Jinzuu/wc_ws/doc/Signalfluss DigIn Out.png

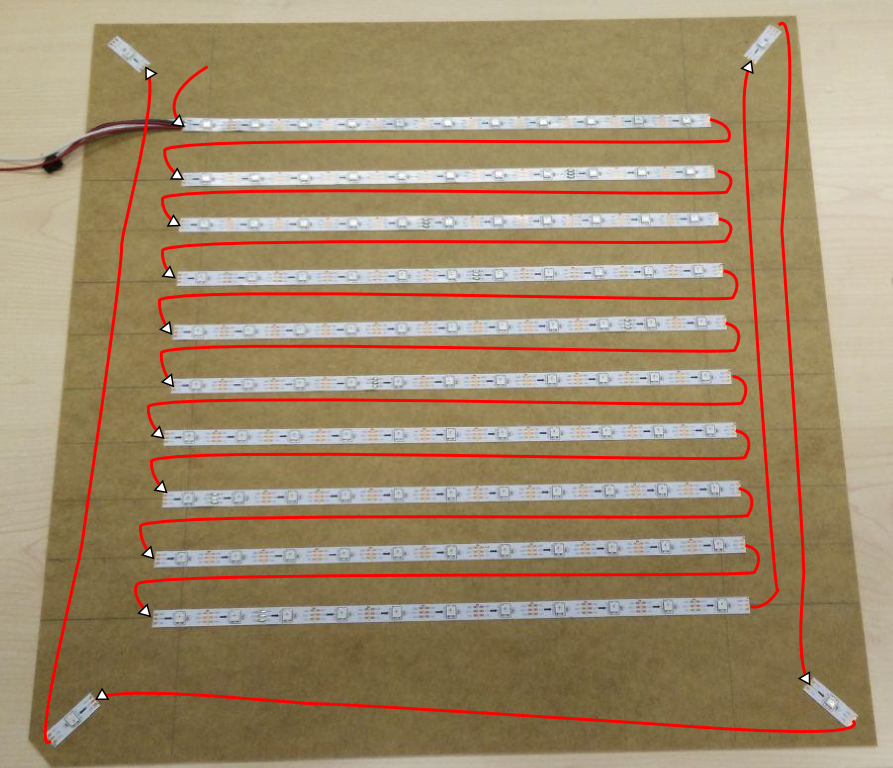
doc/Signalfluss DigIn Out.png
