Jinzuu/wc_ws/README.md

wc_ws
=====

Wordclock on STM32 with WS LEDs
