Jinzuu/wc_ws/doc/Frontplatte V02 mit Bemaßung.png

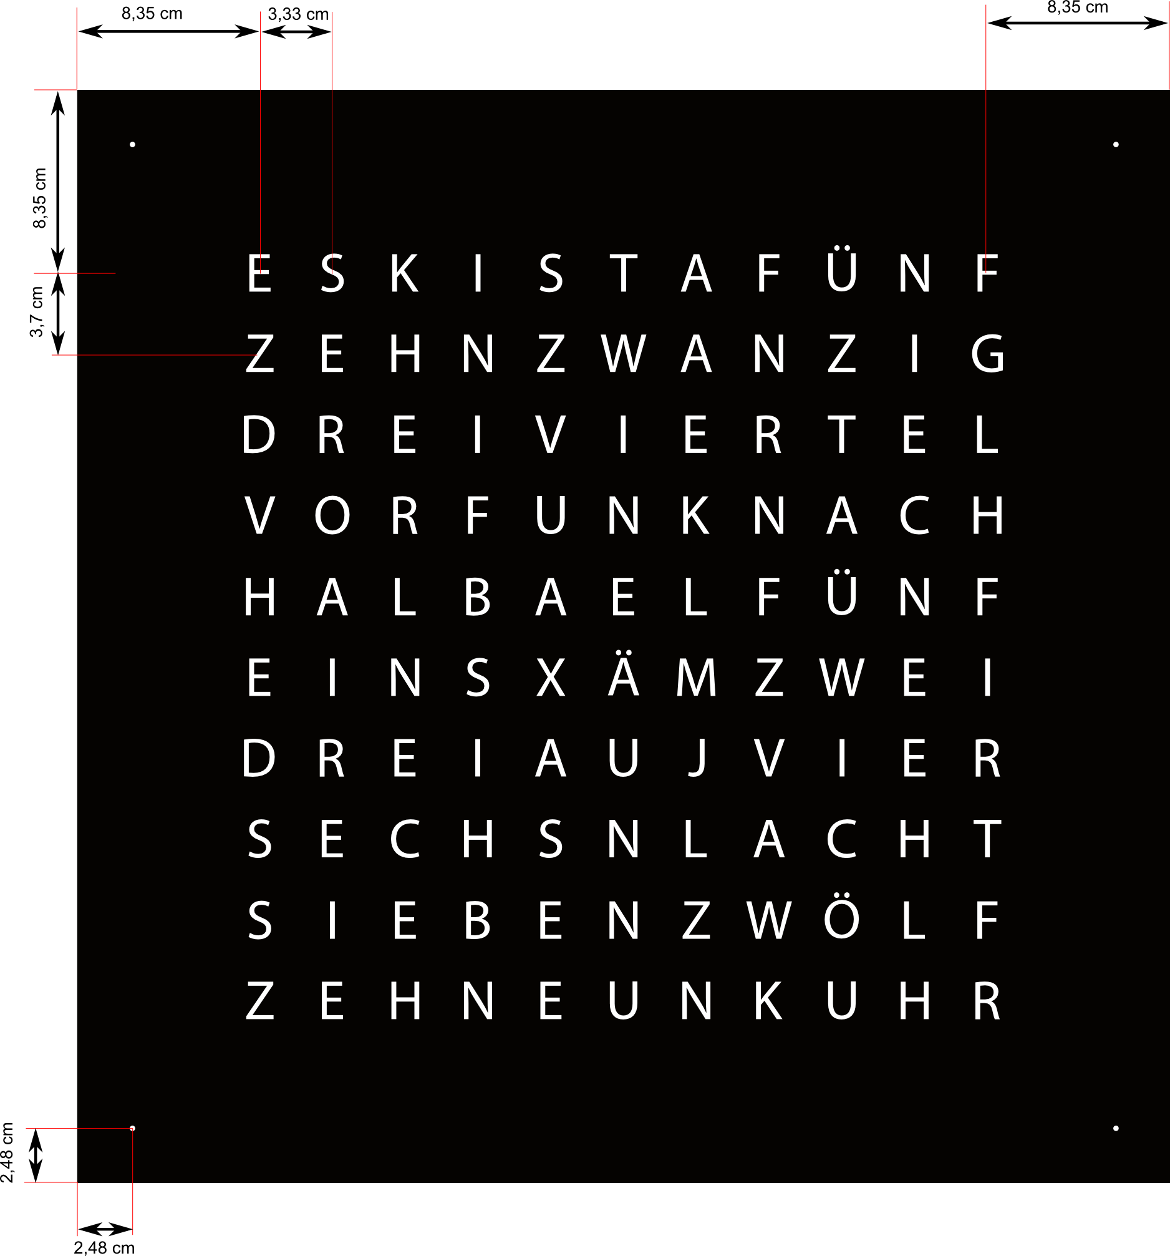
doc/Frontplatte V02 mit Bemaßung.png
