Jinzuu/wc_ws/(list of files, cad)

Other CAD files:
Inventor/Horizontal_Einschub.ipt
