Jinzuu/wc_ws/Platine/Zusatzplatine.brd

## EAGLE design Platine/Zusatzplatine.brd (2015-11-07)

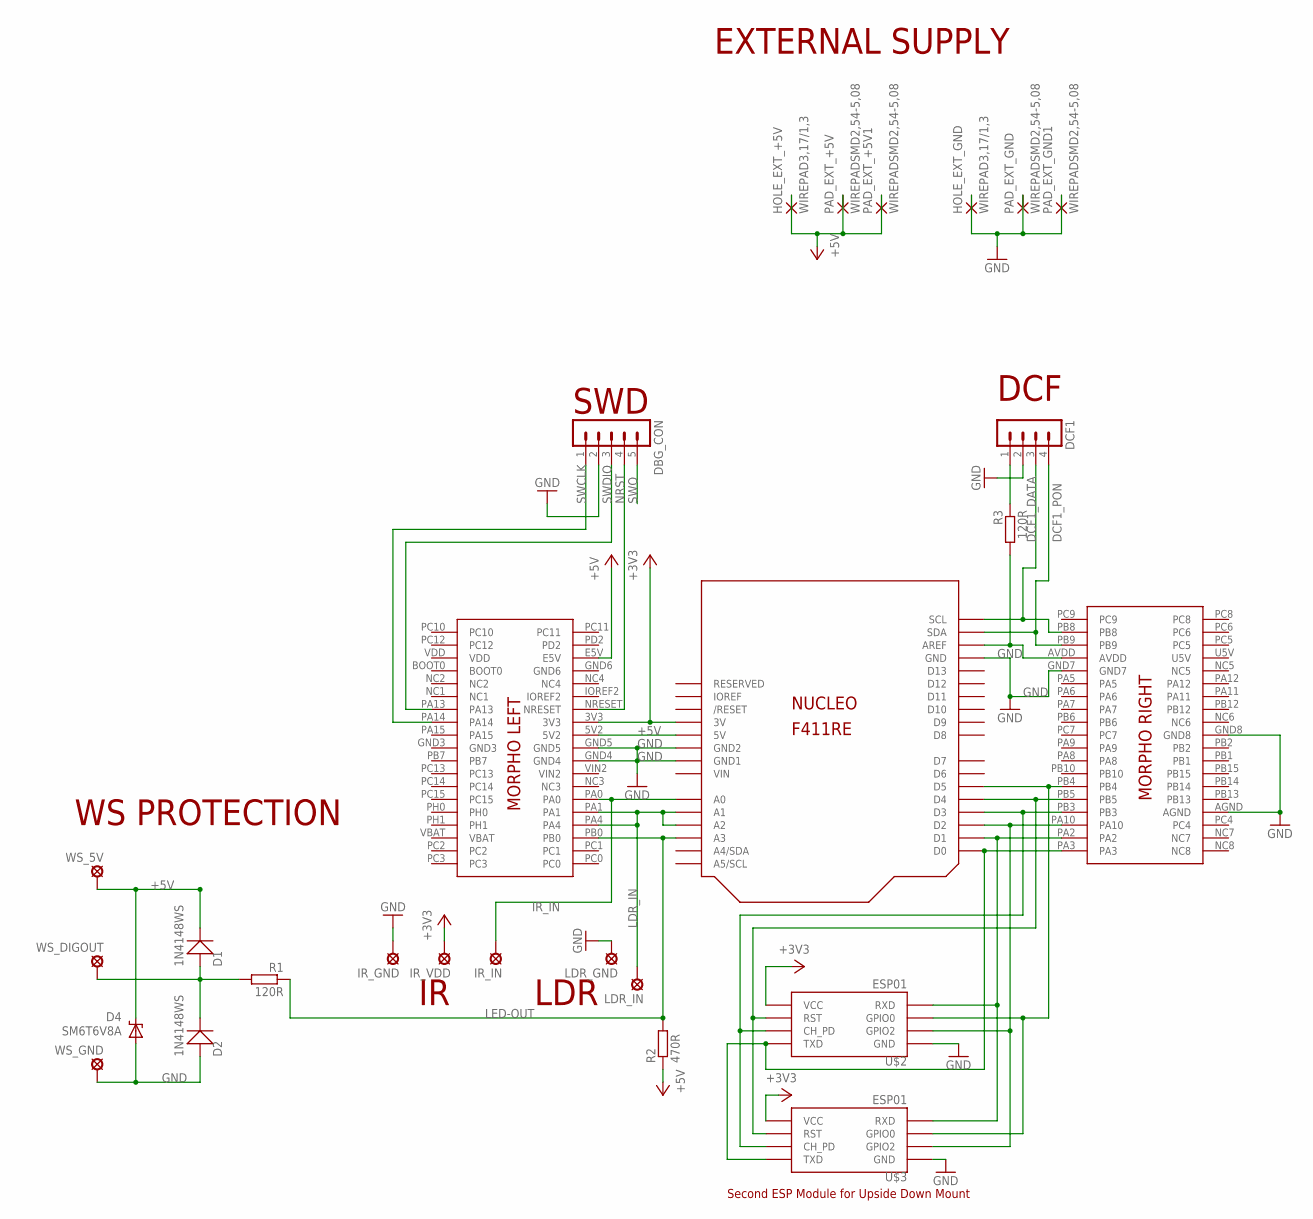
[picture p7: schematic Zusatzplatine.sch]

Parts:
D1, D2: 1N4148WS; SOD-323
D4: SM6T6V8A; SMBJ
DBG_CON: MA05-1
DCF1: MA04-1
HOLE_EXT_+5V: WIREPAD3,17/1,3; 3,17/1,3
HOLE_EXT_GND: WIREPAD3,17/1,3; 3,17/1,3
IR_GND: SE14
IR_IN: SE14
IR_VDD: SE14
LDR_GND: SE14
LDR_IN: SE14
PAD_EXT_+5V, PAD_EXT_+5V1: WIREPADSMD2,54-5,08; SMD2,54-5,08
PAD_EXT_GND, PAD_EXT_GND1: WIREPADSMD2,54-5,08; SMD2,54-5,08
R1, R3: 120R; R1206
R2: 470R; R1206
U$1: NUCLEO_F411RE; NUCLEO_BRD64
U$2, U$3: ESP01
WS_5V: SE14
WS_DIGOUT: SE14
WS_GND: SE14

Connections:
+3V3: IR_VDD.MP, U$1.3V, U$1.3V3, U$2.VCC, U$3.VCC
+5V: D1.1, D4.C, HOLE_EXT_+5V.1, PAD_EXT_+5V.1, PAD_EXT_+5V1.1, R2.1, U$1.5V, U$1.5V2, U$1.E5V, WS_5V.MP
DCF1_DATA: DCF1.3, U$1.PB8, U$1.SCL
DCF1_PON: DCF1.4, U$1.PB9, U$1.SDA
GND: D2.0, D4.A, DBG_CON.2, DCF1.2, HOLE_EXT_GND.1, IR_GND.MP, LDR_GND.MP, PAD_EXT_GND.1, PAD_EXT_GND1.1, U$1.AGND, U$1.GND, U$1.GND1, U$1.GND2, U$1.GND4, U$1.GND5, U$1.GND7, U$1.GND8, U$2.GND, U$3.GND, WS_GND.MP
GND3: U$1.GND3
GND6: U$1.GND6
IR_IN: IR_IN.MP, U$1.A0, U$1.PA0
LDR_IN: LDR_IN.MP, U$1.A1, U$1.A2, U$1.PA1, U$1.PA4
LED-OUT: R1.1, R2.2, U$1.A3, U$1.PB0
unnamed: R3.2, U$1.AREF, U$1.AVDD
unnamed: DCF1.1, R3.1
unnamed: D1.0, D2.1, R1.2, WS_DIGOUT.MP
unnamed: U$1.D5, U$1.PB4, U$2.GPIO0, U$3.GPIO0
unnamed: U$1.D4, U$1.PB5, U$2.RST, U$3.RST
unnamed: U$1.D3, U$1.PB3, U$2.CH_PD, U$3.CH_PD
unnamed: U$1.D0, U$1.PA3, U$2.TX (TXD), U$3.TX (TXD)
unnamed: U$1.D1, U$1.PA2, U$2.RX (RXD), U$3.RX (RXD)
unnamed: U$1.D2, U$1.PA10, U$2.GPIO2, U$3.GPIO2
NRST: DBG_CON.4, U$1.NRESET
SWCLK: DBG_CON.1, U$1.PA14
SWDIO: DBG_CON.3, U$1.PA13
SWO: DBG_CON.5
U5V: U$1.U5V
VBAT: U$1.VBAT
VDD: U$1.VDD
VIN: U$1.VIN
VIN2: U$1.VIN2

Notes on the sheet:
DCF
EXTERNAL SUPPLY
WS PROTECTION
LDR
SWD
Second ESP Module for Upside Down Mount

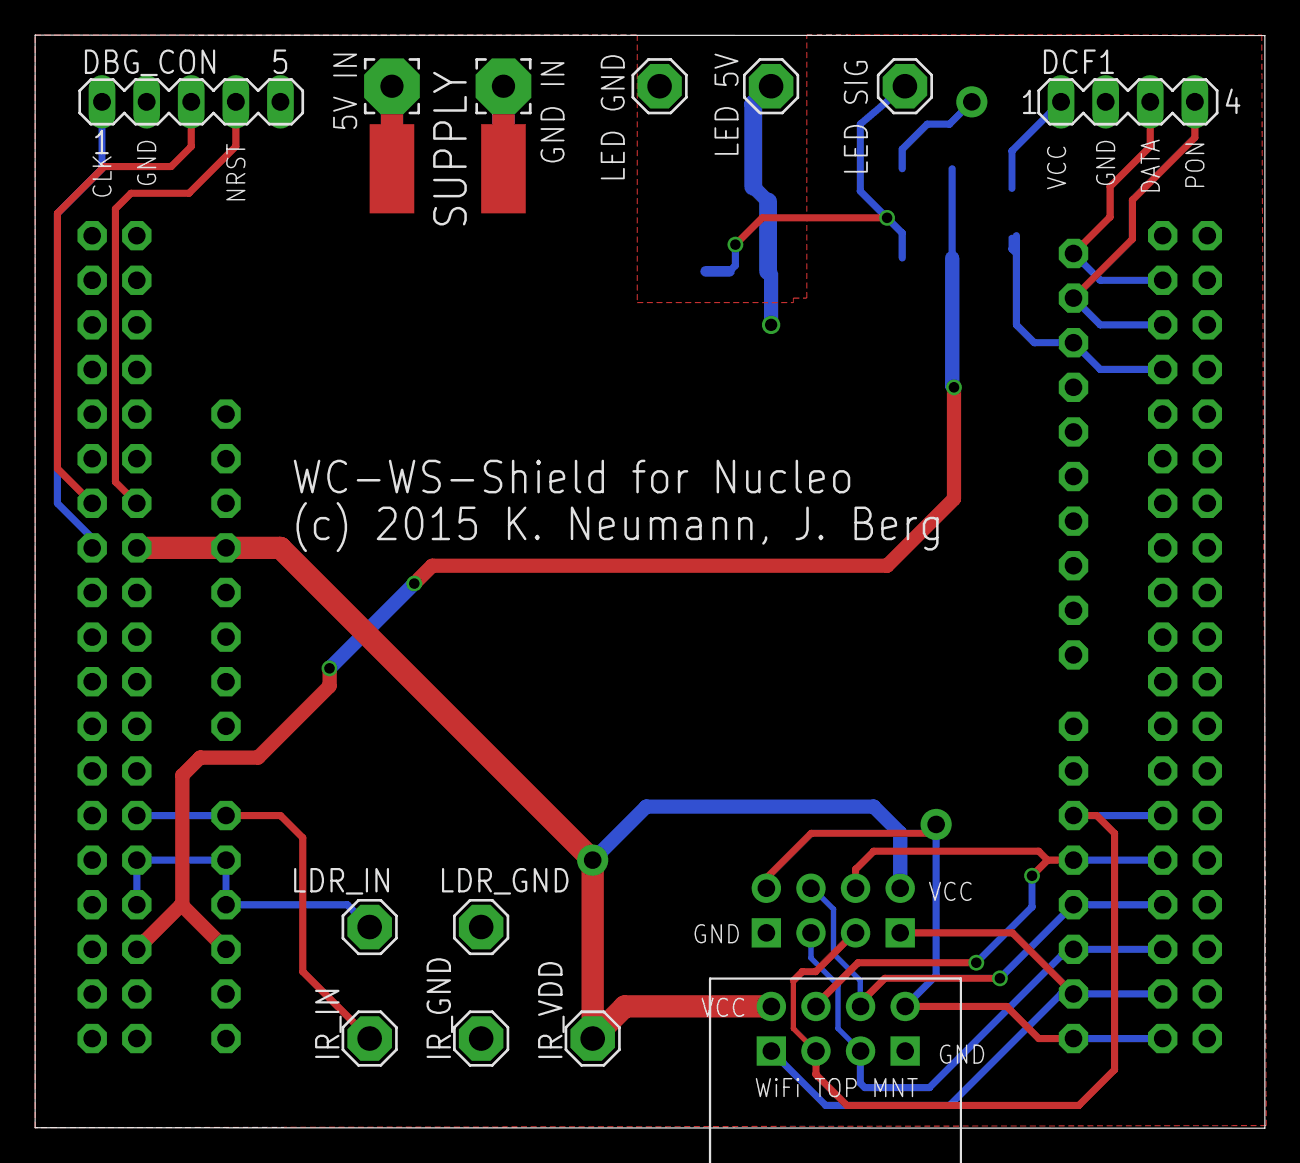
[picture p8: board Zusatzplatine.brd from above]

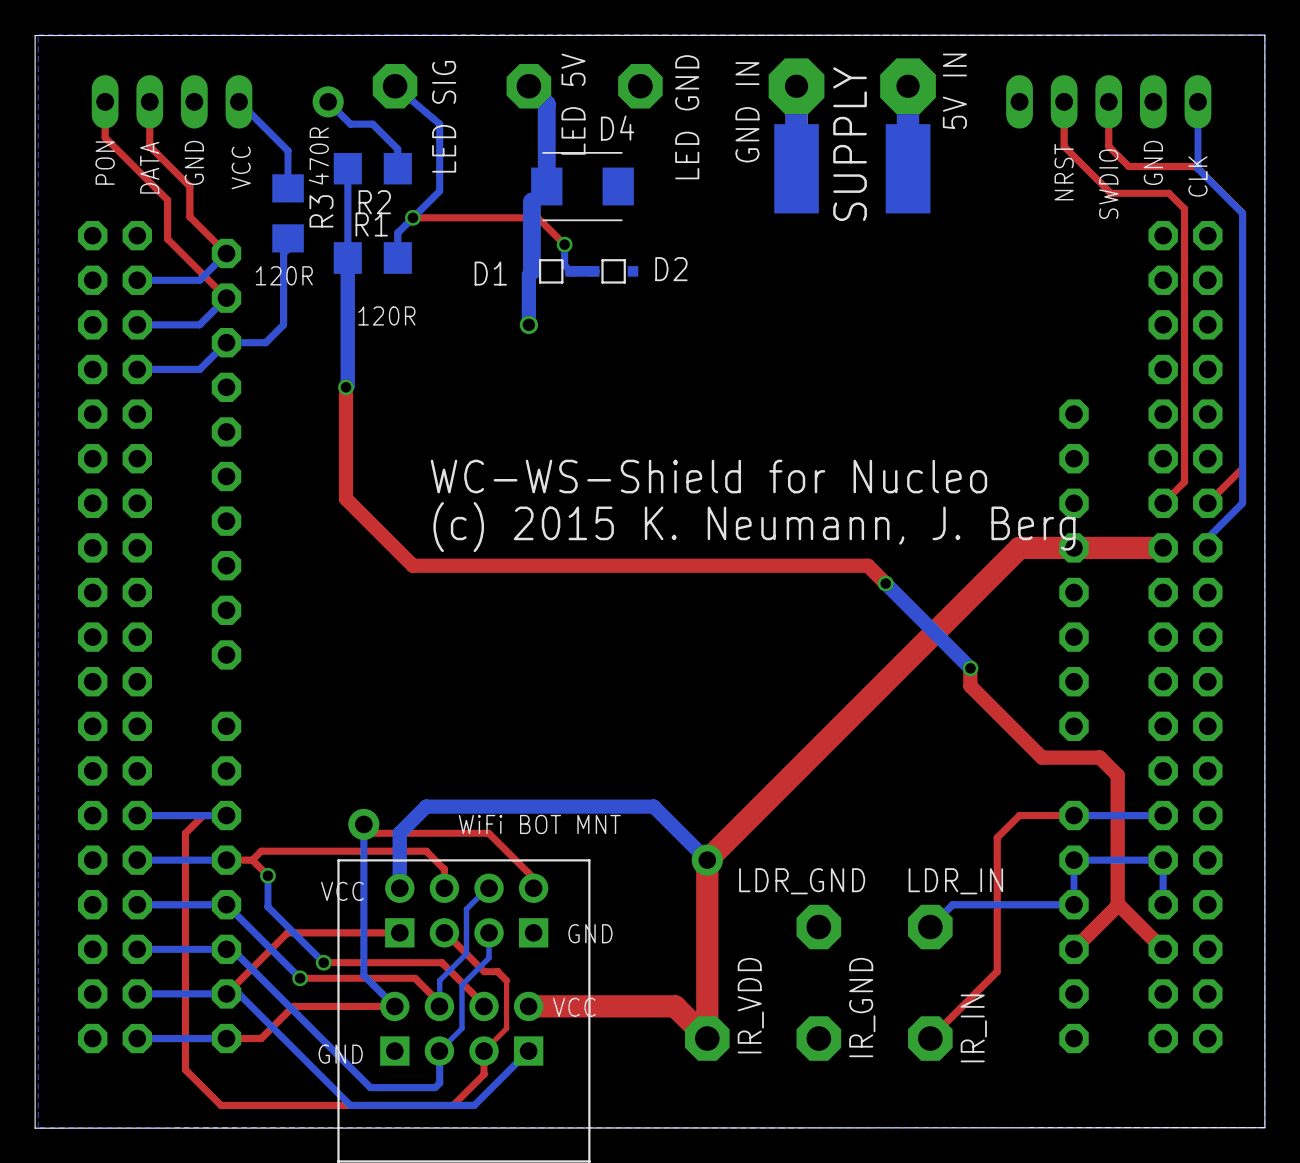
[picture p9: board Zusatzplatine.brd from below]

Board: 2 copper layers, 70.0 x 62.2 mm, 25 parts (9 on the bottom side), 20 nets.
