Jinzuu/wc_ws/Platine/Schutz.brd

## EAGLE design Platine/Schutz.brd (2015-05-21)

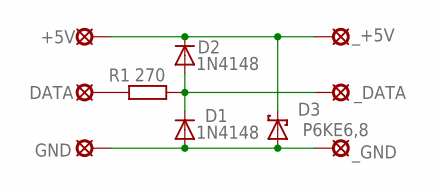
[picture p10: schematic Schutz.sch]

Parts:
+5V: LSP11
D1, D2: 1N4148; DO35-7
D3: P6KE6,8; CB417-15
DATA: LSP11
GND: LSP11
R1: 270; 0207/7
_+5V: LSP11
_DATA: LSP11
_GND: LSP11

Connections:
unnamed: D1.C, D2.A, R1.2, _DATA.MP
unnamed: D1.A, D3.A, GND.MP, _GND.MP
unnamed: +5V.MP, D2.C, D3.C, _+5V.MP
unnamed: DATA.MP, R1.1

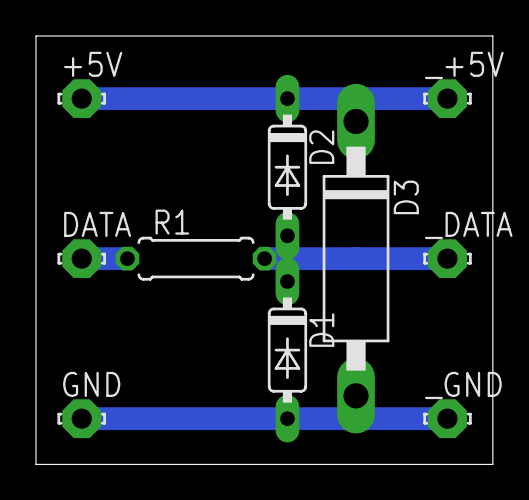
[picture p11: board Schutz.brd from above]

Board: 2 copper layers, 25.4 x 23.8 mm, 10 parts (0 on the bottom side), 4 nets.
