Jinzuu/wc_ws/IRMP/irmp.c

/*---------------------------------------------------------------------------------------------------------------------------------------------------
 * irmp.c - infrared multi-protocol decoder, supports several remote control protocols
 *
 * Copyright (c) 2009-2010 Frank Meyer - frank(at)fli4l.de
 *
 * $Id: irmp.c,v 1.87 2011/01/18 13:02:15 fm Exp $
 *
 * ATMEGA88 @ 8 MHz
 *
 * Typical manufacturers:
 *
 * SIRCS      - Sony
 * NEC        - NEC, Yamaha, Canon, Tevion, Harman/Kardon, Hitachi, JVC, Pioneer, Toshiba, Xoro, Orion, and many other Japanese manufacturers
 * SAMSUNG    - Samsung
 * SAMSUNG32  - Samsung
 * MATSUSHITA - Matsushita
 * KASEIKYO   - Panasonic, Denon & other Japanese manufacturers (members of "Japan's Association for Electric Home Application")
 * RECS80     - Philips, Nokia, Thomson, Nordmende, Telefunken, Saba
 * RC5        - Philips and other European manufacturers
 * DENON      - Denon, Sharp
 * RC6        - Philips and other European manufacturers
 * APPLE      - Apple
 * NUBERT     - Nubert Subwoofer System
 * B&O        - Bang & Olufsen
 * PANASONIC  - Panasonic (older, yet not implemented)
 * GRUNDIG    - Grundig
 * NOKIA      - Nokia
 * SIEMENS    - Siemens, e.g. Gigaset M740AV
 *
 *---------------------------------------------------------------------------------------------------------------------------------------------------
 *
 *   SIRCS
 *   -----
 *
 *   frame: 1 start bit + 12-20 data bits + no stop bit
 *   data:  7 command bits + 5 address bits + 0 to 8 additional bits
 *
 *   start bit:                           data "0":                 data "1":                 stop bit:
 *   -----------------_________           ------_____               ------------______
 *       2400us         600us             600us 600us               1200us      600 us        no stop bit
 *
 *---------------------------------------------------------------------------------------------------------------------------------------------------
 *
 *   NEC + extended NEC
 *   -------------------------
 *
 *   frame: 1 start bit + 32 data bits + 1 stop bit
 *   data NEC:          8 address bits + 8 inverted address bits + 8 command bits + 8 inverted command bits
 *   data extended NEC: 16 address bits + 8 command bits + 8 inverted command bits
 *
 *   start bit:                           data "0":                 data "1":                 stop bit:
 *   -----------------_________           ------______              ------________________    ------______....
 *       9000us        4500us             560us  560us              560us    1690 us          560us
 *
 *
 *   Repetition frame:
 *
 *   -----------------_________------______  .... ~100ms Pause, then repeat
 *       9000us        2250us   560us
 *
 *---------------------------------------------------------------------------------------------------------------------------------------------------
 *
 *   SAMSUNG
 *   -------
 *
 *   frame: 1 start bit + 16 data(1) bits + 1 sync bit + additional 20 data(2) bits + 1 stop bit
 *   data(1): 16 address bits
 *   data(2): 4 ID bits + 8 command bits + 8 inverted command bits
 *
 *   start bit:                           data "0":                 data "1":                 sync bit:               stop bit:
 *   ----------______________             ------______              ------________________    ------______________    ------______....
 *    4500us       4500us                 550us  450us              550us    1450us           550us    4500us         550us
 *
 *---------------------------------------------------------------------------------------------------------------------------------------------------
 *
 *   SAMSUNG32
 *   ----------
 *
 *   frame: 1 start bit + 32 data bits + 1 stop bit
 *   data: 16 address bits + 16 command bits
 *
 *   start bit:                           data "0":                 data "1":                 stop bit:
 *   ----------______________             ------______              ------________________    ------______....
 *    4500us       4500us                 550us  450us              550us    1450us           550us
 *
 *---------------------------------------------------------------------------------------------------------------------------------------------------
 *
 *   MATSUSHITA
 *   ----------
 *
 *   frame: 1 start bit + 24 data bits + 1 stop bit
 *   data:  6 custom bits + 6 command bits + 12 address bits
 *
 *   start bit:                           data "0":                 data "1":                 stop bit:
 *   ----------_________                  ------______              ------________________    ------______....
 *    3488us     3488us                   872us  872us              872us    2616us           872us
 *
 *---------------------------------------------------------------------------------------------------------------------------------------------------
 *
 *   KASEIKYO
 *   --------
 *
 *   frame: 1 start bit + 48 data bits + 1 stop bit
 *   data:  16 manufacturer bits + 4 parity bits + 4 genre1 bits + 4 genre2 bits + 10 command bits + 2 id bits + 8 parity bits
 *
 *   start bit:                           data "0":                 data "1":                 stop bit:
 *   ----------______                     ------______              ------________________    ------______....
 *    3380us   1690us                     423us  423us              423us    1269us           423us
 *
 *---------------------------------------------------------------------------------------------------------------------------------------------------
 *
 *   RECS80
 *   ------
 *
 *   frame: 2 start bits + 10 data bits + 1 stop bit
 *   data:  1 toggle bit + 3 address bits + 6 command bits
 *
 *   start bit:                           data "0":                 data "1":                 stop bit:
 *   -----_____________________           -----____________         -----______________       ------_______....
 *   158us       7432us                   158us   4902us            158us    7432us           158us
 *
 *---------------------------------------------------------------------------------------------------------------------------------------------------
 *
 *   RECS80EXT
 *   ---------
 *
 *   frame: 2 start bits + 11 data bits + 1 stop bit
 *   data:  1 toggle bit + 4 address bits + 6 command bits
 *
 *   start bit:                           data "0":                 data "1":                 stop bit:
 *   -----_____________________           -----____________         -----______________       ------_______....
 *   158us       3637us                   158us   4902us            158us    7432us           158us
 *
 *---------------------------------------------------------------------------------------------------------------------------------------------------
 *
 *   RC5 + RC5X
 *   ----------
 *
 *   RC5 frame:  2 start bits + 12 data bits + no stop bit
 *   RC5 data:   1 toggle bit + 5 address bits + 6 command bits
 *   RC5X frame: 1 start bit +  13 data bits + no stop bit
 *   RC5X data:  1 inverted command bit + 1 toggle bit + 5 address bits + 6 command bits
 *
 *   start bit:              data "0":                data "1":
 *   ______-----             ------______             ______------
 *   889us 889us             889us 889us              889us 889us
 *
 *---------------------------------------------------------------------------------------------------------------------------------------------------
 *
 *   DENON
 *   -----
 *
 *   frame: 0 start bits + 16 data bits + stop bit + 65ms pause + 16 inverted data bits + stop bit
 *   data:  5 address bits + 10 command bits
 *
 *   Theory:
 *
 *   data "0":                 data "1":
 *   ------________________    ------______________
 *   275us       775us         275us   1900us
 *
 *   Practice:
 *
 *   data "0":                 data "1":
 *   ------________________    ------______________
 *   310us       745us         310us   1780us
 *
 *---------------------------------------------------------------------------------------------------------------------------------------------------
 *
 *   RC6
 *   ---
 *
 *   RC6 frame:  1 start bit + 1 bit "1" + 3 mode bits + 1 toggle bit + 16 data bits + 2666 µs pause
 *   RC6 data:   8 address bits + 8 command bits
 *
 *   start  bit               toggle bit "0":      toggle bit "1":     data/mode "0":      data/mode "1":
 *   ____________-------      _______-------       -------_______      _______-------      -------_______
 *      2666us    889us        889us  889us         889us  889us        444us  444us        444us  444us
 *
 *---------------------------------------------------------------------------------------------------------------------------------------------------
 *
 *   APPLE
 *   -----
 *
 *   frame: 1 start bit + 32 data bits + 1 stop bit
 *   data:  16 address bits + 11100000 + 8 command bits
 *
 *   start bit:                           data "0":                 data "1":                 stop bit:
 *   -----------------_________           ------______              ------________________    ------______....
 *       9000us        4500us             560us  560us              560us    1690 us          560us
 *
 *---------------------------------------------------------------------------------------------------------------------------------------------------
 *
 *   NUBERT (subwoofer system)
 *   -------------------------
 *
 *   frame: 1 start bit + 10 data bits + 1 stop bit
 *   data:  0 address bits + 10 command bits ?
 *
 *   start bit:                       data "0":                 data "1":                 stop bit:
 *   ----------_____                  ------______              ------________________    ------______....
 *    1340us   340us                  500us 1300us              1340us 340us              500us
 *
 *---------------------------------------------------------------------------------------------------------------------------------------------------
 *
 *   BANG_OLUFSEN
 *   ------------
 *
 *   frame: 4 start bits + 16 data bits + 1 trailer bit + 1 stop bit
 *   data:  0 address bits + 16 command bits
 *
 *   1st start bit:  2nd start bit:      3rd start bit:       4th start bit:
 *   -----________   -----________       -----_____________   -----________
 *   210us 3000us    210us 3000us        210us   15000us      210us 3000us
 *
 *   data "0":       data "1":           data "repeat bit":   trailer bit:         stop bit:
 *   -----________   -----_____________  -----___________     -----_____________   -----____...
 *   210us 3000us    210us   9000us      210us   6000us       210us   12000us      210us
 *
 *---------------------------------------------------------------------------------------------------------------------------------------------------
 *
 *   GRUNDIG
 *   -------
 *
 *   packet:  1 start frame + 19,968ms pause + N info frames + 117,76ms pause + 1 stop frame
 *   frame: 1 pre bit + 1 start bit + 9 data bits + no stop bit
 *   pause between info frames: 117,76ms
 *
 *   data of start frame:   9 x 1
 *   data of info  frame:   9 command bits
 *   data of stop  frame:   9 x 1
 *
 *   pre bit:              start bit           data "0":            data "1":
 *   ------____________    ------______        ______------         ------______             
 *   528us  2639us         528us  528us        528us  528us         528us  528us
 *
 *---------------------------------------------------------------------------------------------------------------------------------------------------
 *
 *   NOKIA:
 *   ------
 *
 *   Timing similar to Grundig, but 16 data bits:
 *   frame: 1 pre bit + 1 start bit + 8 command bits + 8 address bits + no stop bit
 *
 *---------------------------------------------------------------------------------------------------------------------------------------------------
 *
 *   SIEMENS:
 *   --------
 *
 *   SIEMENS frame:  1 start bit + 22 data bits + no stop bit
 *   SIEMENS data:   13 address bits + 1 repeat bit + 7 data bits + 1 unknown bit
 *
 *   start  bit           data "0":            data "1":
 *   -------_______       _______-------       -------_______
 *    250us  250us         250us  250us         250us  250us
 *
 *---------------------------------------------------------------------------------------------------------------------------------------------------
 *
 *   PANASONIC (older protocol, yet not implemented, see also MATSUSHITA, timing very similar)
 *   -----------------------------------------------------------------------------------------
 *
 *   frame: 1 start bit + 22 data bits + 1 stop bit
 *   22 data bits = 5 custom bits + 6 data bits + 5 inverted custom bits + 6 inverted data bits
 *
 *   European version:      T = 456us
 *   USA & Canada version:  T = 422us
 *
 *   start bit:                           data "0":                 data "1":                 stop bit:
 *        8T            8T                 2T   2T                   2T      6T                2T
 *   -------------____________            ------_____               ------_____________       ------_______....
 *      3648us        3648us              912us 912us               912us    2736us           912us                (Europe)
 *      3376us        3376us              844us 844us               844us    2532us           844us                (US)
 *
 *---------------------------------------------------------------------------------------------------------------------------------------------------
 *
 * This program is free software; you can redistribute it and/or modify
 * it under the terms of the GNU General Public License as published by
 * the Free Software Foundation; either version 2 of the License, or
 * (at your option) any later version.
 *---------------------------------------------------------------------------------------------------------------------------------------------------
 */

#include "irmp.h"


#if defined(__PCM__) || defined(__PCB__) || defined(__PCH__)                // CCS PIC Compiler instead of AVR
#define PIC_CCS_COMPILER
#endif

#ifdef unix                                                                 // test on linux/unix
#include <stdio.h>
#include <unistd.h>
#include <stdlib.h>
#include <string.h>
#include <inttypes.h>

#define ANALYZE
#define PROGMEM
#define memcpy_P        memcpy

#else // not unix:

#ifdef WIN32
#include <stdio.h>
#include <string.h>
typedef unsigned char   uint8_t;
typedef unsigned short  uint16_t;
#define ANALYZE
#define PROGMEM
#define memcpy_P        memcpy

#else

#ifndef CODEVISION

#ifdef PIC_CCS_COMPILER

#include <string.h>
typedef unsigned int8   uint8_t;
typedef unsigned int16  uint16_t;
#define PROGMEM
#define memcpy_P        memcpy
#endif  // PIC_CCS_COMPILER

#ifdef IRMP_FLEXIBLE_VERSION
// Code for other microcontrollers ( ARM...)
#define PROGMEM
#define memcpy_P        memcpy

#else // AVR:

#include <inttypes.h>
#include <stdio.h>
#include <string.h>
#include <avr/io.h>
#include <util/delay.h>
#include <avr/pgmspace.h>

#endif 	// IRMP_FLEXIBLE_VERSION
#endif  // CODEVISION

#endif // windows
#endif // unix

#ifndef IRMP_USE_AS_LIB
#include "irmpconfig.h"
#endif
#include "irmp.h"

#if IRMP_SUPPORT_GRUNDIG_PROTOCOL == 1 || IRMP_SUPPORT_NOKIA_PROTOCOL == 1
#define IRMP_SUPPORT_GRUNDIG_OR_NOKIA_PROTOCOL  1
#else
#define IRMP_SUPPORT_GRUNDIG_OR_NOKIA_PROTOCOL  0
#endif

#if IRMP_SUPPORT_RC5_PROTOCOL == 1 || IRMP_SUPPORT_RC6_PROTOCOL == 1 || IRMP_SUPPORT_GRUNDIG_OR_NOKIA_PROTOCOL == 1 || IRMP_SUPPORT_SIEMENS_PROTOCOL == 1 
#define IRMP_SUPPORT_MANCHESTER                 1
#else
#define IRMP_SUPPORT_MANCHESTER                 0
#endif

//#define IRMP_KEY_REPETITION_LEN                 (uint16_t)(F_INTERRUPTS * 150.0e-3 + 0.5)           // autodetect key repetition within 150 msec
#define IRMP_KEY_REPETITION_LEN                 (uint16_t)(F_INTERRUPTS * 800.0e-3 + 0.5)           // autodetect key repetition within 1 sec

#define MIN_TOLERANCE_00                        1.0                           // -0%
#define MAX_TOLERANCE_00                        1.0                           // +0%

#define MIN_TOLERANCE_05                        0.95                          // -5%
#define MAX_TOLERANCE_05                        1.05                          // +5%

#define MIN_TOLERANCE_10                        0.9                           // -10%
#define MAX_TOLERANCE_10                        1.1                           // +10%

#define MIN_TOLERANCE_15                        0.85                          // -15%
#define MAX_TOLERANCE_15                        1.15                          // +15%

#define MIN_TOLERANCE_20                        0.8                           // -20%
#define MAX_TOLERANCE_20                        1.2                           // +20%

#define MIN_TOLERANCE_30                        0.7                           // -30%
#define MAX_TOLERANCE_30                        1.3                           // +30%

#define MIN_TOLERANCE_40                        0.6                           // -40%
#define MAX_TOLERANCE_40                        1.4                           // +40%

#define MIN_TOLERANCE_50                        0.5                           // -50%
#define MAX_TOLERANCE_50                        1.5                           // +50%

#define MIN_TOLERANCE_60                        0.4                           // -60%
#define MAX_TOLERANCE_60                        1.6                           // +60%

#define MIN_TOLERANCE_70                        0.3                           // -70%
#define MAX_TOLERANCE_70                        1.7                           // +70%

#define SIRCS_START_BIT_PULSE_LEN_MIN           ((uint8_t)(F_INTERRUPTS * SIRCS_START_BIT_PULSE_TIME * MIN_TOLERANCE_10 + 0.5) - 1)
#define SIRCS_START_BIT_PULSE_LEN_MAX           ((uint8_t)(F_INTERRUPTS * SIRCS_START_BIT_PULSE_TIME * MAX_TOLERANCE_10 + 0.5) + 1)
#define SIRCS_START_BIT_PAUSE_LEN_MIN           ((uint8_t)(F_INTERRUPTS * SIRCS_START_BIT_PAUSE_TIME * MIN_TOLERANCE_20 + 0.5) - 1)
#define SIRCS_START_BIT_PAUSE_LEN_MAX           ((uint8_t)(F_INTERRUPTS * SIRCS_START_BIT_PAUSE_TIME * MAX_TOLERANCE_05 + 0.5) + 1) // only 5% to avoid conflict with RC6
#define SIRCS_1_PULSE_LEN_MIN                   ((uint8_t)(F_INTERRUPTS * SIRCS_1_PULSE_TIME * MIN_TOLERANCE_10 + 0.5) - 1)
#define SIRCS_1_PULSE_LEN_MAX                   ((uint8_t)(F_INTERRUPTS * SIRCS_1_PULSE_TIME * MAX_TOLERANCE_10 + 0.5) + 1)
#define SIRCS_0_PULSE_LEN_MIN                   ((uint8_t)(F_INTERRUPTS * SIRCS_0_PULSE_TIME * MIN_TOLERANCE_10 + 0.5) - 1)
#define SIRCS_0_PULSE_LEN_MAX                   ((uint8_t)(F_INTERRUPTS * SIRCS_0_PULSE_TIME * MAX_TOLERANCE_10 + 0.5) + 1)
#define SIRCS_PAUSE_LEN_MIN                     ((uint8_t)(F_INTERRUPTS * SIRCS_PAUSE_TIME * MIN_TOLERANCE_10 + 0.5) - 1)
#define SIRCS_PAUSE_LEN_MAX                     ((uint8_t)(F_INTERRUPTS * SIRCS_PAUSE_TIME * MAX_TOLERANCE_10 + 0.5) + 1)

#define NEC_START_BIT_PULSE_LEN_MIN             ((uint8_t)(F_INTERRUPTS * NEC_START_BIT_PULSE_TIME * MIN_TOLERANCE_40 + 0.5) - 1)
#define NEC_START_BIT_PULSE_LEN_MAX             ((uint8_t)(F_INTERRUPTS * NEC_START_BIT_PULSE_TIME * MAX_TOLERANCE_40 + 0.5) + 1)
#define NEC_START_BIT_PAUSE_LEN_MIN             ((uint8_t)(F_INTERRUPTS * NEC_START_BIT_PAUSE_TIME * MIN_TOLERANCE_40 + 0.5) - 1)
#define NEC_START_BIT_PAUSE_LEN_MAX             ((uint8_t)(F_INTERRUPTS * NEC_START_BIT_PAUSE_TIME * MAX_TOLERANCE_40 + 0.5) + 1)
#define NEC_REPEAT_START_BIT_PAUSE_LEN_MIN      ((uint8_t)(F_INTERRUPTS * NEC_REPEAT_START_BIT_PAUSE_TIME * MIN_TOLERANCE_40 + 0.5) - 1)
#define NEC_REPEAT_START_BIT_PAUSE_LEN_MAX      ((uint8_t)(F_INTERRUPTS * NEC_REPEAT_START_BIT_PAUSE_TIME * MAX_TOLERANCE_40 + 0.5) + 1)
#define NEC_PULSE_LEN_MIN                       ((uint8_t)(F_INTERRUPTS * NEC_PULSE_TIME * MIN_TOLERANCE_40 + 0.5) - 1)
#define NEC_PULSE_LEN_MAX                       ((uint8_t)(F_INTERRUPTS * NEC_PULSE_TIME * MAX_TOLERANCE_40 + 0.5) + 1)
#define NEC_1_PAUSE_LEN_MIN                     ((uint8_t)(F_INTERRUPTS * NEC_1_PAUSE_TIME * MIN_TOLERANCE_40 + 0.5) - 1)
#define NEC_1_PAUSE_LEN_MAX                     ((uint8_t)(F_INTERRUPTS * NEC_1_PAUSE_TIME * MAX_TOLERANCE_40 + 0.5) + 1)
#define NEC_0_PAUSE_LEN_MIN                     ((uint8_t)(F_INTERRUPTS * NEC_0_PAUSE_TIME * MIN_TOLERANCE_40 + 0.5) - 1)
#define NEC_0_PAUSE_LEN_MAX                     ((uint8_t)(F_INTERRUPTS * NEC_0_PAUSE_TIME * MAX_TOLERANCE_40 + 0.5) + 1)
// autodetect nec repetition frame within 50 msec:
// NEC seems to send the first repetition frame after 40ms, further repetition frames after 100 ms
#if 0
#define NEC_FRAME_REPEAT_PAUSE_LEN_MAX          (uint16_t)(F_INTERRUPTS * NEC_FRAME_REPEAT_PAUSE_TIME * MAX_TOLERANCE_20 + 0.5)
#else
#define NEC_FRAME_REPEAT_PAUSE_LEN_MAX          (uint16_t)(F_INTERRUPTS * 100.0e-3 * MAX_TOLERANCE_20 + 0.5)
#endif

#define SAMSUNG_START_BIT_PULSE_LEN_MIN         ((uint8_t)(F_INTERRUPTS * SAMSUNG_START_BIT_PULSE_TIME * MIN_TOLERANCE_10 + 0.5) - 1)
#define SAMSUNG_START_BIT_PULSE_LEN_MAX         ((uint8_t)(F_INTERRUPTS * SAMSUNG_START_BIT_PULSE_TIME * MAX_TOLERANCE_10 + 0.5) + 1)
#define SAMSUNG_START_BIT_PAUSE_LEN_MIN         ((uint8_t)(F_INTERRUPTS * SAMSUNG_START_BIT_PAUSE_TIME * MIN_TOLERANCE_10 + 0.5) - 1)
#define SAMSUNG_START_BIT_PAUSE_LEN_MAX         ((uint8_t)(F_INTERRUPTS * SAMSUNG_START_BIT_PAUSE_TIME * MAX_TOLERANCE_10 + 0.5) + 1)
#define SAMSUNG_PULSE_LEN_MIN                   ((uint8_t)(F_INTERRUPTS * SAMSUNG_PULSE_TIME * MIN_TOLERANCE_30 + 0.5) - 1)
#define SAMSUNG_PULSE_LEN_MAX                   ((uint8_t)(F_INTERRUPTS * SAMSUNG_PULSE_TIME * MAX_TOLERANCE_30 + 0.5) + 1)
#define SAMSUNG_1_PAUSE_LEN_MIN                 ((uint8_t)(F_INTERRUPTS * SAMSUNG_1_PAUSE_TIME * MIN_TOLERANCE_30 + 0.5) - 1)
#define SAMSUNG_1_PAUSE_LEN_MAX                 ((uint8_t)(F_INTERRUPTS * SAMSUNG_1_PAUSE_TIME * MAX_TOLERANCE_30 + 0.5) + 1)
#define SAMSUNG_0_PAUSE_LEN_MIN                 ((uint8_t)(F_INTERRUPTS * SAMSUNG_0_PAUSE_TIME * MIN_TOLERANCE_30 + 0.5) - 1)
#define SAMSUNG_0_PAUSE_LEN_MAX                 ((uint8_t)(F_INTERRUPTS * SAMSUNG_0_PAUSE_TIME * MAX_TOLERANCE_30 + 0.5) + 1)

#define MATSUSHITA_START_BIT_PULSE_LEN_MIN      ((uint8_t)(F_INTERRUPTS * MATSUSHITA_START_BIT_PULSE_TIME * MIN_TOLERANCE_20 + 0.5) - 1)
#define MATSUSHITA_START_BIT_PULSE_LEN_MAX      ((uint8_t)(F_INTERRUPTS * MATSUSHITA_START_BIT_PULSE_TIME * MAX_TOLERANCE_20 + 0.5) + 1)
#define MATSUSHITA_START_BIT_PAUSE_LEN_MIN      ((uint8_t)(F_INTERRUPTS * MATSUSHITA_START_BIT_PAUSE_TIME * MIN_TOLERANCE_20 + 0.5) - 1)
#define MATSUSHITA_START_BIT_PAUSE_LEN_MAX      ((uint8_t)(F_INTERRUPTS * MATSUSHITA_START_BIT_PAUSE_TIME * MAX_TOLERANCE_20 + 0.5) + 1)
#define MATSUSHITA_PULSE_LEN_MIN                ((uint8_t)(F_INTERRUPTS * MATSUSHITA_PULSE_TIME * MIN_TOLERANCE_40 + 0.5) - 1)
#define MATSUSHITA_PULSE_LEN_MAX                ((uint8_t)(F_INTERRUPTS * MATSUSHITA_PULSE_TIME * MAX_TOLERANCE_40 + 0.5) + 1)
#define MATSUSHITA_1_PAUSE_LEN_MIN              ((uint8_t)(F_INTERRUPTS * MATSUSHITA_1_PAUSE_TIME * MIN_TOLERANCE_40 + 0.5) - 1)
#define MATSUSHITA_1_PAUSE_LEN_MAX              ((uint8_t)(F_INTERRUPTS * MATSUSHITA_1_PAUSE_TIME * MAX_TOLERANCE_40 + 0.5) + 1)
#define MATSUSHITA_0_PAUSE_LEN_MIN              ((uint8_t)(F_INTERRUPTS * MATSUSHITA_0_PAUSE_TIME * MIN_TOLERANCE_40 + 0.5) - 1)
#define MATSUSHITA_0_PAUSE_LEN_MAX              ((uint8_t)(F_INTERRUPTS * MATSUSHITA_0_PAUSE_TIME * MAX_TOLERANCE_40 + 0.5) + 1)

#define KASEIKYO_START_BIT_PULSE_LEN_MIN        ((uint8_t)(F_INTERRUPTS * KASEIKYO_START_BIT_PULSE_TIME * MIN_TOLERANCE_10 + 0.5) - 1)
#define KASEIKYO_START_BIT_PULSE_LEN_MAX        ((uint8_t)(F_INTERRUPTS * KASEIKYO_START_BIT_PULSE_TIME * MAX_TOLERANCE_10 + 0.5) + 1)
#define KASEIKYO_START_BIT_PAUSE_LEN_MIN        ((uint8_t)(F_INTERRUPTS * KASEIKYO_START_BIT_PAUSE_TIME * MIN_TOLERANCE_10 + 0.5) - 1)
#define KASEIKYO_START_BIT_PAUSE_LEN_MAX        ((uint8_t)(F_INTERRUPTS * KASEIKYO_START_BIT_PAUSE_TIME * MAX_TOLERANCE_10 + 0.5) + 1)
#define KASEIKYO_PULSE_LEN_MIN                  ((uint8_t)(F_INTERRUPTS * KASEIKYO_PULSE_TIME * MIN_TOLERANCE_50 + 0.5) - 1)
#define KASEIKYO_PULSE_LEN_MAX                  ((uint8_t)(F_INTERRUPTS * KASEIKYO_PULSE_TIME * MAX_TOLERANCE_50 + 0.5) + 1)
#define KASEIKYO_1_PAUSE_LEN_MIN                ((uint8_t)(F_INTERRUPTS * KASEIKYO_1_PAUSE_TIME * MIN_TOLERANCE_30 + 0.5) - 1)
#define KASEIKYO_1_PAUSE_LEN_MAX                ((uint8_t)(F_INTERRUPTS * KASEIKYO_1_PAUSE_TIME * MAX_TOLERANCE_30 + 0.5) + 1)
#define KASEIKYO_0_PAUSE_LEN_MIN                ((uint8_t)(F_INTERRUPTS * KASEIKYO_0_PAUSE_TIME * MIN_TOLERANCE_50 + 0.5) - 1)
#define KASEIKYO_0_PAUSE_LEN_MAX                ((uint8_t)(F_INTERRUPTS * KASEIKYO_0_PAUSE_TIME * MAX_TOLERANCE_50 + 0.5) + 1)

#define RECS80_START_BIT_PULSE_LEN_MIN          ((uint8_t)(F_INTERRUPTS * RECS80_START_BIT_PULSE_TIME * MIN_TOLERANCE_00 + 0.5) - 1)
#define RECS80_START_BIT_PULSE_LEN_MAX          ((uint8_t)(F_INTERRUPTS * RECS80_START_BIT_PULSE_TIME * MAX_TOLERANCE_10 + 0.5) + 1)
#define RECS80_START_BIT_PAUSE_LEN_MIN          ((uint8_t)(F_INTERRUPTS * RECS80_START_BIT_PAUSE_TIME * MIN_TOLERANCE_10 + 0.5) - 1)
#define RECS80_START_BIT_PAUSE_LEN_MAX          ((uint8_t)(F_INTERRUPTS * RECS80_START_BIT_PAUSE_TIME * MAX_TOLERANCE_10 + 0.5) + 1)
#define RECS80_PULSE_LEN_MIN                    ((uint8_t)(F_INTERRUPTS * RECS80_PULSE_TIME * MIN_TOLERANCE_10 + 0.5) - 1)
#define RECS80_PULSE_LEN_MAX                    ((uint8_t)(F_INTERRUPTS * RECS80_PULSE_TIME * MAX_TOLERANCE_10 + 0.5) + 1)
#define RECS80_1_PAUSE_LEN_MIN                  ((uint8_t)(F_INTERRUPTS * RECS80_1_PAUSE_TIME * MIN_TOLERANCE_10 + 0.5) - 1)
#define RECS80_1_PAUSE_LEN_MAX                  ((uint8_t)(F_INTERRUPTS * RECS80_1_PAUSE_TIME * MAX_TOLERANCE_10 + 0.5) + 1)
#define RECS80_0_PAUSE_LEN_MIN                  ((uint8_t)(F_INTERRUPTS * RECS80_0_PAUSE_TIME * MIN_TOLERANCE_10 + 0.5) - 1)
#define RECS80_0_PAUSE_LEN_MAX                  ((uint8_t)(F_INTERRUPTS * RECS80_0_PAUSE_TIME * MAX_TOLERANCE_10 + 0.5) + 1)

#define RC5_START_BIT_LEN_MIN                   ((uint8_t)(F_INTERRUPTS * RC5_BIT_TIME * MIN_TOLERANCE_10 + 0.5) - 1)
#define RC5_START_BIT_LEN_MAX                   ((uint8_t)(F_INTERRUPTS * RC5_BIT_TIME * MAX_TOLERANCE_10 + 0.5) + 1)
#define RC5_BIT_LEN_MIN                         ((uint8_t)(F_INTERRUPTS * RC5_BIT_TIME * MIN_TOLERANCE_10 + 0.5) - 1)
#define RC5_BIT_LEN_MAX                         ((uint8_t)(F_INTERRUPTS * RC5_BIT_TIME * MAX_TOLERANCE_10 + 0.5) + 1)

#define DENON_PULSE_LEN_MIN                     ((uint8_t)(F_INTERRUPTS * DENON_PULSE_TIME * MIN_TOLERANCE_10 + 0.5) - 1)
#define DENON_PULSE_LEN_MAX                     ((uint8_t)(F_INTERRUPTS * DENON_PULSE_TIME * MAX_TOLERANCE_10 + 0.5) + 1)
#define DENON_1_PAUSE_LEN_MIN                   ((uint8_t)(F_INTERRUPTS * DENON_1_PAUSE_TIME * MIN_TOLERANCE_10 + 0.5) - 1)
#define DENON_1_PAUSE_LEN_MAX                   ((uint8_t)(F_INTERRUPTS * DENON_1_PAUSE_TIME * MAX_TOLERANCE_10 + 0.5) + 1)
#define DENON_0_PAUSE_LEN_MIN                   ((uint8_t)(F_INTERRUPTS * DENON_0_PAUSE_TIME * MIN_TOLERANCE_10 + 0.5) - 1)
#define DENON_0_PAUSE_LEN_MAX                   ((uint8_t)(F_INTERRUPTS * DENON_0_PAUSE_TIME * MAX_TOLERANCE_10 + 0.5) + 1)

#define RC6_START_BIT_PULSE_LEN_MIN             ((uint8_t)(F_INTERRUPTS * RC6_START_BIT_PULSE_TIME * MIN_TOLERANCE_10 + 0.5) - 1)
#define RC6_START_BIT_PULSE_LEN_MAX             ((uint8_t)(F_INTERRUPTS * RC6_START_BIT_PULSE_TIME * MAX_TOLERANCE_10 + 0.5) + 1)
#define RC6_START_BIT_PAUSE_LEN_MIN             ((uint8_t)(F_INTERRUPTS * RC6_START_BIT_PAUSE_TIME * MIN_TOLERANCE_10 + 0.5) - 1)
#define RC6_START_BIT_PAUSE_LEN_MAX             ((uint8_t)(F_INTERRUPTS * RC6_START_BIT_PAUSE_TIME * MAX_TOLERANCE_10 + 0.5) + 1)
#define RC6_TOGGLE_BIT_LEN_MIN                  ((uint8_t)(F_INTERRUPTS * RC6_TOGGLE_BIT_TIME * MIN_TOLERANCE_10 + 0.5) - 1)
#define RC6_TOGGLE_BIT_LEN_MAX                  ((uint8_t)(F_INTERRUPTS * RC6_TOGGLE_BIT_TIME * MAX_TOLERANCE_10 + 0.5) + 1)
#define RC6_BIT_PULSE_LEN_MIN                   ((uint8_t)(F_INTERRUPTS * RC6_BIT_TIME * MIN_TOLERANCE_10 + 0.5) - 1)
#define RC6_BIT_PULSE_LEN_MAX                   ((uint8_t)(F_INTERRUPTS * RC6_BIT_TIME * MAX_TOLERANCE_30 + 0.5) + 1)       // pulses: 300 - 700
#define RC6_BIT_PAUSE_LEN_MIN                   ((uint8_t)(F_INTERRUPTS * RC6_BIT_TIME * MIN_TOLERANCE_10 + 0.5) - 1)       // pauses: 300 - 600
#define RC6_BIT_PAUSE_LEN_MAX                   ((uint8_t)(F_INTERRUPTS * RC6_BIT_TIME * MAX_TOLERANCE_10 + 0.5) + 1)

#define RECS80EXT_START_BIT_PULSE_LEN_MIN       ((uint8_t)(F_INTERRUPTS * RECS80EXT_START_BIT_PULSE_TIME * MIN_TOLERANCE_00 + 0.5) - 1)
#define RECS80EXT_START_BIT_PULSE_LEN_MAX       ((uint8_t)(F_INTERRUPTS * RECS80EXT_START_BIT_PULSE_TIME * MAX_TOLERANCE_00 + 0.5) + 1)
#define RECS80EXT_START_BIT_PAUSE_LEN_MIN       ((uint8_t)(F_INTERRUPTS * RECS80EXT_START_BIT_PAUSE_TIME * MIN_TOLERANCE_05 + 0.5) - 1)
#define RECS80EXT_START_BIT_PAUSE_LEN_MAX       ((uint8_t)(F_INTERRUPTS * RECS80EXT_START_BIT_PAUSE_TIME * MAX_TOLERANCE_05 + 0.5) + 1)
#define RECS80EXT_PULSE_LEN_MIN                 ((uint8_t)(F_INTERRUPTS * RECS80EXT_PULSE_TIME * MIN_TOLERANCE_10 + 0.5) - 1)
#define RECS80EXT_PULSE_LEN_MAX                 ((uint8_t)(F_INTERRUPTS * RECS80EXT_PULSE_TIME * MAX_TOLERANCE_10 + 0.5) + 1)
#define RECS80EXT_1_PAUSE_LEN_MIN               ((uint8_t)(F_INTERRUPTS * RECS80EXT_1_PAUSE_TIME * MIN_TOLERANCE_10 + 0.5) - 1)
#define RECS80EXT_1_PAUSE_LEN_MAX               ((uint8_t)(F_INTERRUPTS * RECS80EXT_1_PAUSE_TIME * MAX_TOLERANCE_10 + 0.5) + 1)
#define RECS80EXT_0_PAUSE_LEN_MIN               ((uint8_t)(F_INTERRUPTS * RECS80EXT_0_PAUSE_TIME * MIN_TOLERANCE_10 + 0.5) - 1)
#define RECS80EXT_0_PAUSE_LEN_MAX               ((uint8_t)(F_INTERRUPTS * RECS80EXT_0_PAUSE_TIME * MAX_TOLERANCE_10 + 0.5) + 1)

#define NUBERT_START_BIT_PULSE_LEN_MIN          ((uint8_t)(F_INTERRUPTS * NUBERT_START_BIT_PULSE_TIME * MIN_TOLERANCE_20 + 0.5) - 1)
#define NUBERT_START_BIT_PULSE_LEN_MAX          ((uint8_t)(F_INTERRUPTS * NUBERT_START_BIT_PULSE_TIME * MAX_TOLERANCE_20 + 0.5) + 1)
#define NUBERT_START_BIT_PAUSE_LEN_MIN          ((uint8_t)(F_INTERRUPTS * NUBERT_START_BIT_PAUSE_TIME * MIN_TOLERANCE_20 + 0.5) - 1)
#define NUBERT_START_BIT_PAUSE_LEN_MAX          ((uint8_t)(F_INTERRUPTS * NUBERT_START_BIT_PAUSE_TIME * MAX_TOLERANCE_20 + 0.5) + 1)
#define NUBERT_1_PULSE_LEN_MIN                  ((uint8_t)(F_INTERRUPTS * NUBERT_1_PULSE_TIME * MIN_TOLERANCE_20 + 0.5) - 1)
#define NUBERT_1_PULSE_LEN_MAX                  ((uint8_t)(F_INTERRUPTS * NUBERT_1_PULSE_TIME * MAX_TOLERANCE_20 + 0.5) + 1)
#define NUBERT_1_PAUSE_LEN_MIN                  ((uint8_t)(F_INTERRUPTS * NUBERT_1_PAUSE_TIME * MIN_TOLERANCE_20 + 0.5) - 1)
#define NUBERT_1_PAUSE_LEN_MAX                  ((uint8_t)(F_INTERRUPTS * NUBERT_1_PAUSE_TIME * MAX_TOLERANCE_20 + 0.5) + 1)
#define NUBERT_0_PULSE_LEN_MIN                  ((uint8_t)(F_INTERRUPTS * NUBERT_0_PULSE_TIME * MIN_TOLERANCE_20 + 0.5) - 1)
#define NUBERT_0_PULSE_LEN_MAX                  ((uint8_t)(F_INTERRUPTS * NUBERT_0_PULSE_TIME * MAX_TOLERANCE_20 + 0.5) + 1)
#define NUBERT_0_PAUSE_LEN_MIN                  ((uint8_t)(F_INTERRUPTS * NUBERT_0_PAUSE_TIME * MIN_TOLERANCE_20 + 0.5) - 1)
#define NUBERT_0_PAUSE_LEN_MAX                  ((uint8_t)(F_INTERRUPTS * NUBERT_0_PAUSE_TIME * MAX_TOLERANCE_20 + 0.5) + 1)

#define BANG_OLUFSEN_START_BIT1_PULSE_LEN_MIN   ((uint8_t)(F_INTERRUPTS * BANG_OLUFSEN_START_BIT1_PULSE_TIME * MIN_TOLERANCE_10 + 0.5) - 1)
#define BANG_OLUFSEN_START_BIT1_PULSE_LEN_MAX   ((uint8_t)(F_INTERRUPTS * BANG_OLUFSEN_START_BIT1_PULSE_TIME * MAX_TOLERANCE_10 + 0.5) + 1)
#define BANG_OLUFSEN_START_BIT1_PAUSE_LEN_MIN   ((uint8_t)(F_INTERRUPTS * BANG_OLUFSEN_START_BIT1_PAUSE_TIME * MIN_TOLERANCE_10 + 0.5) - 1)
#define BANG_OLUFSEN_START_BIT1_PAUSE_LEN_MAX   ((uint8_t)(F_INTERRUPTS * BANG_OLUFSEN_START_BIT1_PAUSE_TIME * MAX_TOLERANCE_10 + 0.5) + 1)
#define BANG_OLUFSEN_START_BIT2_PULSE_LEN_MIN   ((uint8_t)(F_INTERRUPTS * BANG_OLUFSEN_START_BIT2_PULSE_TIME * MIN_TOLERANCE_10 + 0.5) - 1)
#define BANG_OLUFSEN_START_BIT2_PULSE_LEN_MAX   ((uint8_t)(F_INTERRUPTS * BANG_OLUFSEN_START_BIT2_PULSE_TIME * MAX_TOLERANCE_10 + 0.5) + 1)
#define BANG_OLUFSEN_START_BIT2_PAUSE_LEN_MIN   ((uint8_t)(F_INTERRUPTS * BANG_OLUFSEN_START_BIT2_PAUSE_TIME * MIN_TOLERANCE_10 + 0.5) - 1)
#define BANG_OLUFSEN_START_BIT2_PAUSE_LEN_MAX   ((uint8_t)(F_INTERRUPTS * BANG_OLUFSEN_START_BIT2_PAUSE_TIME * MAX_TOLERANCE_10 + 0.5) + 1)
#define BANG_OLUFSEN_START_BIT3_PULSE_LEN_MIN   ((uint8_t)(F_INTERRUPTS * BANG_OLUFSEN_START_BIT3_PULSE_TIME * MIN_TOLERANCE_10 + 0.5) - 1)
#define BANG_OLUFSEN_START_BIT3_PULSE_LEN_MAX   ((uint8_t)(F_INTERRUPTS * BANG_OLUFSEN_START_BIT3_PULSE_TIME * MAX_TOLERANCE_10 + 0.5) + 1)
#define BANG_OLUFSEN_START_BIT3_PAUSE_LEN_MIN   ((uint8_t)(F_INTERRUPTS * BANG_OLUFSEN_START_BIT3_PAUSE_TIME * MIN_TOLERANCE_10 + 0.5) - 1)
#define BANG_OLUFSEN_START_BIT3_PAUSE_LEN_MAX   ((PAUSE_LEN)(F_INTERRUPTS * BANG_OLUFSEN_START_BIT3_PAUSE_TIME * MAX_TOLERANCE_05 + 0.5) + 1) // value must be below IRMP_TIMEOUT
#define BANG_OLUFSEN_START_BIT4_PULSE_LEN_MIN   ((uint8_t)(F_INTERRUPTS * BANG_OLUFSEN_START_BIT4_PULSE_TIME * MIN_TOLERANCE_10 + 0.5) - 1)
#define BANG_OLUFSEN_START_BIT4_PULSE_LEN_MAX   ((uint8_t)(F_INTERRUPTS * BANG_OLUFSEN_START_BIT4_PULSE_TIME * MAX_TOLERANCE_10 + 0.5) + 1)
#define BANG_OLUFSEN_START_BIT4_PAUSE_LEN_MIN   ((uint8_t)(F_INTERRUPTS * BANG_OLUFSEN_START_BIT4_PAUSE_TIME * MIN_TOLERANCE_10 + 0.5) - 1)
#define BANG_OLUFSEN_START_BIT4_PAUSE_LEN_MAX   ((uint8_t)(F_INTERRUPTS * BANG_OLUFSEN_START_BIT4_PAUSE_TIME * MAX_TOLERANCE_10 + 0.5) + 1)
#define BANG_OLUFSEN_PULSE_LEN_MIN              ((uint8_t)(F_INTERRUPTS * BANG_OLUFSEN_PULSE_TIME * MIN_TOLERANCE_10 + 0.5) - 1)
#define BANG_OLUFSEN_PULSE_LEN_MAX              ((uint8_t)(F_INTERRUPTS * BANG_OLUFSEN_PULSE_TIME * MAX_TOLERANCE_10 + 0.5) + 1)
#define BANG_OLUFSEN_1_PAUSE_LEN_MIN            ((uint8_t)(F_INTERRUPTS * BANG_OLUFSEN_1_PAUSE_TIME * MIN_TOLERANCE_10 + 0.5) - 1)
#define BANG_OLUFSEN_1_PAUSE_LEN_MAX            ((uint8_t)(F_INTERRUPTS * BANG_OLUFSEN_1_PAUSE_TIME * MAX_TOLERANCE_10 + 0.5) + 1)
#define BANG_OLUFSEN_0_PAUSE_LEN_MIN            ((uint8_t)(F_INTERRUPTS * BANG_OLUFSEN_0_PAUSE_TIME * MIN_TOLERANCE_10 + 0.5) - 1)
#define BANG_OLUFSEN_0_PAUSE_LEN_MAX            ((uint8_t)(F_INTERRUPTS * BANG_OLUFSEN_0_PAUSE_TIME * MAX_TOLERANCE_10 + 0.5) + 1)
#define BANG_OLUFSEN_R_PAUSE_LEN_MIN            ((uint8_t)(F_INTERRUPTS * BANG_OLUFSEN_R_PAUSE_TIME * MIN_TOLERANCE_10 + 0.5) - 1)
#define BANG_OLUFSEN_R_PAUSE_LEN_MAX            ((uint8_t)(F_INTERRUPTS * BANG_OLUFSEN_R_PAUSE_TIME * MAX_TOLERANCE_10 + 0.5) + 1)
#define BANG_OLUFSEN_TRAILER_BIT_PAUSE_LEN_MIN  ((uint8_t)(F_INTERRUPTS * BANG_OLUFSEN_TRAILER_BIT_PAUSE_TIME * MIN_TOLERANCE_10 + 0.5) - 1)
#define BANG_OLUFSEN_TRAILER_BIT_PAUSE_LEN_MAX  ((uint8_t)(F_INTERRUPTS * BANG_OLUFSEN_TRAILER_BIT_PAUSE_TIME * MAX_TOLERANCE_10 + 0.5) + 1)

#define GRUNDIG_OR_NOKIA_START_BIT_LEN_MIN      ((uint8_t)(F_INTERRUPTS * GRUNDIG_OR_NOKIA_BIT_TIME * MIN_TOLERANCE_20 + 0.5) - 1)
#define GRUNDIG_OR_NOKIA_START_BIT_LEN_MAX      ((uint8_t)(F_INTERRUPTS * GRUNDIG_OR_NOKIA_BIT_TIME * MAX_TOLERANCE_20 + 0.5) + 1)
#define GRUNDIG_OR_NOKIA_BIT_LEN_MIN            ((uint8_t)(F_INTERRUPTS * GRUNDIG_OR_NOKIA_BIT_TIME * MIN_TOLERANCE_20 + 0.5) - 1)
#define GRUNDIG_OR_NOKIA_BIT_LEN_MAX            ((uint8_t)(F_INTERRUPTS * GRUNDIG_OR_NOKIA_BIT_TIME * MAX_TOLERANCE_20 + 0.5) + 1)
#define GRUNDIG_OR_NOKIA_PRE_PAUSE_LEN_MIN      ((uint8_t)(F_INTERRUPTS * GRUNDIG_OR_NOKIA_PRE_PAUSE_TIME * MIN_TOLERANCE_20 + 0.5) + 1)
#define GRUNDIG_OR_NOKIA_PRE_PAUSE_LEN_MAX      ((uint8_t)(F_INTERRUPTS * GRUNDIG_OR_NOKIA_PRE_PAUSE_TIME * MAX_TOLERANCE_20 + 0.5) + 1)

#define SIEMENS_START_BIT_LEN_MIN               ((uint8_t)(F_INTERRUPTS * SIEMENS_BIT_TIME * 1 + 0.5) - 1)
#define SIEMENS_START_BIT_LEN_MAX               ((uint8_t)(F_INTERRUPTS * SIEMENS_BIT_TIME * 1 + 0.5) + 1)
#define SIEMENS_BIT_LEN_MIN                     ((uint8_t)(F_INTERRUPTS * SIEMENS_BIT_TIME * 1 + 0.5) - 1)
#define SIEMENS_BIT_LEN_MAX                     ((uint8_t)(F_INTERRUPTS * SIEMENS_BIT_TIME * 1 + 0.5) + 1)

#define FDC_START_BIT_PULSE_LEN_MIN             ((uint8_t)(F_INTERRUPTS * FDC_START_BIT_PULSE_TIME * MIN_TOLERANCE_10 + 0.5) - 1)
#define FDC_START_BIT_PULSE_LEN_MAX             ((uint8_t)(F_INTERRUPTS * FDC_START_BIT_PULSE_TIME * MAX_TOLERANCE_10 + 0.5) + 1)
#define FDC_START_BIT_PAUSE_LEN_MIN             ((uint8_t)(F_INTERRUPTS * FDC_START_BIT_PAUSE_TIME * MIN_TOLERANCE_10 + 0.5) - 1)
#define FDC_START_BIT_PAUSE_LEN_MAX             ((uint8_t)(F_INTERRUPTS * FDC_START_BIT_PAUSE_TIME * MAX_TOLERANCE_10 + 0.5) + 1)
#define FDC_PULSE_LEN_MIN                       ((uint8_t)(F_INTERRUPTS * FDC_PULSE_TIME * MIN_TOLERANCE_40 + 0.5) - 1)
#define FDC_PULSE_LEN_MAX                       ((uint8_t)(F_INTERRUPTS * FDC_PULSE_TIME * MAX_TOLERANCE_50 + 0.5) + 1)
#define FDC_1_PAUSE_LEN_MIN                     ((uint8_t)(F_INTERRUPTS * FDC_1_PAUSE_TIME * MIN_TOLERANCE_20 + 0.5) - 1)
#define FDC_1_PAUSE_LEN_MAX                     ((uint8_t)(F_INTERRUPTS * FDC_1_PAUSE_TIME * MAX_TOLERANCE_20 + 0.5) + 1)
#if 0
#define FDC_0_PAUSE_LEN_MIN                     ((uint8_t)(F_INTERRUPTS * FDC_0_PAUSE_TIME * MIN_TOLERANCE_40 + 0.5) - 1)   // could be negative: 255
#else
#define FDC_0_PAUSE_LEN_MIN                     (1)                                                                         // simply use 1
#endif
#define FDC_0_PAUSE_LEN_MAX                     ((uint8_t)(F_INTERRUPTS * FDC_0_PAUSE_TIME * MAX_TOLERANCE_10 + 0.5) + 1)

#define RCCAR_START_BIT_PULSE_LEN_MIN           ((uint8_t)(F_INTERRUPTS * RCCAR_START_BIT_PULSE_TIME * MIN_TOLERANCE_10 + 0.5) - 1)
#define RCCAR_START_BIT_PULSE_LEN_MAX           ((uint8_t)(F_INTERRUPTS * RCCAR_START_BIT_PULSE_TIME * MAX_TOLERANCE_10 + 0.5) + 1)
#define RCCAR_START_BIT_PAUSE_LEN_MIN           ((uint8_t)(F_INTERRUPTS * RCCAR_START_BIT_PAUSE_TIME * MIN_TOLERANCE_10 + 0.5) - 1)
#define RCCAR_START_BIT_PAUSE_LEN_MAX           ((uint8_t)(F_INTERRUPTS * RCCAR_START_BIT_PAUSE_TIME * MAX_TOLERANCE_10 + 0.5) + 1)
#define RCCAR_PULSE_LEN_MIN                     ((uint8_t)(F_INTERRUPTS * RCCAR_PULSE_TIME * MIN_TOLERANCE_20 + 0.5) - 1)
#define RCCAR_PULSE_LEN_MAX                     ((uint8_t)(F_INTERRUPTS * RCCAR_PULSE_TIME * MAX_TOLERANCE_20 + 0.5) + 1)
#define RCCAR_1_PAUSE_LEN_MIN                   ((uint8_t)(F_INTERRUPTS * RCCAR_1_PAUSE_TIME * MIN_TOLERANCE_30 + 0.5) - 1)
#define RCCAR_1_PAUSE_LEN_MAX                   ((uint8_t)(F_INTERRUPTS * RCCAR_1_PAUSE_TIME * MAX_TOLERANCE_30 + 0.5) + 1)
#define RCCAR_0_PAUSE_LEN_MIN                   ((uint8_t)(F_INTERRUPTS * RCCAR_0_PAUSE_TIME * MIN_TOLERANCE_30 + 0.5) - 1)
#define RCCAR_0_PAUSE_LEN_MAX                   ((uint8_t)(F_INTERRUPTS * RCCAR_0_PAUSE_TIME * MAX_TOLERANCE_30 + 0.5) + 1)

#define JVC_START_BIT_PULSE_LEN_MIN             ((uint8_t)(F_INTERRUPTS * JVC_START_BIT_PULSE_TIME * MIN_TOLERANCE_40 + 0.5) - 1)
#define JVC_START_BIT_PULSE_LEN_MAX             ((uint8_t)(F_INTERRUPTS * JVC_START_BIT_PULSE_TIME * MAX_TOLERANCE_40 + 0.5) + 1)
#define JVC_REPEAT_START_BIT_PAUSE_LEN_MIN      ((uint8_t)(F_INTERRUPTS * (JVC_FRAME_REPEAT_PAUSE_TIME - IRMP_TIMEOUT_TIME) * MIN_TOLERANCE_40 + 0.5) - 1)  // HACK!
#define JVC_REPEAT_START_BIT_PAUSE_LEN_MAX      ((uint8_t)(F_INTERRUPTS * (JVC_FRAME_REPEAT_PAUSE_TIME - IRMP_TIMEOUT_TIME) * MAX_TOLERANCE_70 + 0.5) - 1)  // HACK!
#define JVC_PULSE_LEN_MIN                       ((uint8_t)(F_INTERRUPTS * JVC_PULSE_TIME * MIN_TOLERANCE_40 + 0.5) - 1)
#define JVC_PULSE_LEN_MAX                       ((uint8_t)(F_INTERRUPTS * JVC_PULSE_TIME * MAX_TOLERANCE_40 + 0.5) + 1)
#define JVC_1_PAUSE_LEN_MIN                     ((uint8_t)(F_INTERRUPTS * JVC_1_PAUSE_TIME * MIN_TOLERANCE_40 + 0.5) - 1)
#define JVC_1_PAUSE_LEN_MAX                     ((uint8_t)(F_INTERRUPTS * JVC_1_PAUSE_TIME * MAX_TOLERANCE_40 + 0.5) + 1)
#define JVC_0_PAUSE_LEN_MIN                     ((uint8_t)(F_INTERRUPTS * JVC_0_PAUSE_TIME * MIN_TOLERANCE_40 + 0.5) - 1)
#define JVC_0_PAUSE_LEN_MAX                     ((uint8_t)(F_INTERRUPTS * JVC_0_PAUSE_TIME * MAX_TOLERANCE_40 + 0.5) + 1)
// autodetect JVC repetition frame within 50 msec:
#define JVC_FRAME_REPEAT_PAUSE_LEN_MAX          (uint16_t)(F_INTERRUPTS * JVC_FRAME_REPEAT_PAUSE_TIME * MAX_TOLERANCE_20 + 0.5)

#define NIKON_START_BIT_PULSE_LEN_MIN           ((uint8_t)(F_INTERRUPTS * NIKON_START_BIT_PULSE_TIME * MIN_TOLERANCE_20 + 0.5) - 1)
#define NIKON_START_BIT_PULSE_LEN_MAX           ((uint8_t)(F_INTERRUPTS * NIKON_START_BIT_PULSE_TIME * MAX_TOLERANCE_20 + 0.5) + 1)
#define NIKON_START_BIT_PAUSE_LEN_MIN           ((uint16_t)(F_INTERRUPTS * NIKON_START_BIT_PAUSE_TIME * MIN_TOLERANCE_20 + 0.5) - 1)
#define NIKON_START_BIT_PAUSE_LEN_MAX           ((uint16_t)(F_INTERRUPTS * NIKON_START_BIT_PAUSE_TIME * MAX_TOLERANCE_20 + 0.5) + 1)
#define NIKON_REPEAT_START_BIT_PAUSE_LEN_MIN    ((uint8_t)(F_INTERRUPTS * NIKON_REPEAT_START_BIT_PAUSE_TIME * MIN_TOLERANCE_20 + 0.5) - 1)
#define NIKON_REPEAT_START_BIT_PAUSE_LEN_MAX    ((uint8_t)(F_INTERRUPTS * NIKON_REPEAT_START_BIT_PAUSE_TIME * MAX_TOLERANCE_20 + 0.5) + 1)
#define NIKON_PULSE_LEN_MIN                     ((uint8_t)(F_INTERRUPTS * NIKON_PULSE_TIME * MIN_TOLERANCE_20 + 0.5) - 1)
#define NIKON_PULSE_LEN_MAX                     ((uint8_t)(F_INTERRUPTS * NIKON_PULSE_TIME * MAX_TOLERANCE_20 + 0.5) + 1)
#define NIKON_1_PAUSE_LEN_MIN                   ((uint8_t)(F_INTERRUPTS * NIKON_1_PAUSE_TIME * MIN_TOLERANCE_20 + 0.5) - 1)
#define NIKON_1_PAUSE_LEN_MAX                   ((uint8_t)(F_INTERRUPTS * NIKON_1_PAUSE_TIME * MAX_TOLERANCE_20 + 0.5) + 1)
#define NIKON_0_PAUSE_LEN_MIN                   ((uint8_t)(F_INTERRUPTS * NIKON_0_PAUSE_TIME * MIN_TOLERANCE_20 + 0.5) - 1)
#define NIKON_0_PAUSE_LEN_MAX                   ((uint8_t)(F_INTERRUPTS * NIKON_0_PAUSE_TIME * MAX_TOLERANCE_20 + 0.5) + 1)
#define NIKON_FRAME_REPEAT_PAUSE_LEN_MAX        (uint16_t)(F_INTERRUPTS * NIKON_FRAME_REPEAT_PAUSE_TIME * MAX_TOLERANCE_20 + 0.5)

#define AUTO_FRAME_REPETITION_LEN               (uint16_t)(F_INTERRUPTS * AUTO_FRAME_REPETITION_TIME + 0.5)       // use uint16_t!

#ifdef ANALYZE
#define ANALYZE_PUTCHAR(a)                        { if (! silent)             { putchar (a);          } }
#define ANALYZE_ONLY_NORMAL_PUTCHAR(a)            { if (! silent && !verbose) { putchar (a);          } }
#define ANALYZE_PRINTF(...)                       { if (verbose)              { printf (__VA_ARGS__); } }
#define ANALYZE_NEWLINE()                         { if (verbose)              { putchar ('\n');       } }
static int      silent;
static int      time_counter;
static int      verbose;
#else
#define ANALYZE_PUTCHAR(a)
#define ANALYZE_ONLY_NORMAL_PUTCHAR(a)
#define ANALYZE_PRINTF(...)
#define ANALYZE_NEWLINE()
#endif

#if IRMP_LOGGING == 1
#define BAUD                                    9600L
#include <util/setbaud.h>

#ifdef UBRR0H

#define UART0_UBRRH                             UBRR0H
#define UART0_UBRRL                             UBRR0L
#define UART0_UCSRA                             UCSR0A
#define UART0_UCSRB                             UCSR0B
#define UART0_UCSRC                             UCSR0C
#define UART0_UDRE_BIT_VALUE                    (1<<UDRE0)
#define UART0_UCSZ1_BIT_VALUE                   (1<<UCSZ01)
#define UART0_UCSZ0_BIT_VALUE                   (1<<UCSZ00)
#ifdef URSEL0
#define UART0_URSEL_BIT_VALUE                   (1<<URSEL0)
#else
#define UART0_URSEL_BIT_VALUE                   (0)
#endif
#define UART0_TXEN_BIT_VALUE                    (1<<TXEN0)
#define UART0_UDR                               UDR0
#define UART0_U2X                               U2X0

#else

#define UART0_UBRRH                             UBRRH
#define UART0_UBRRL                             UBRRL
#define UART0_UCSRA                             UCSRA
#define UART0_UCSRB                             UCSRB
#define UART0_UCSRC                             UCSRC
#define UART0_UDRE_BIT_VALUE                    (1<<UDRE)
#define UART0_UCSZ1_BIT_VALUE                   (1<<UCSZ1)
#define UART0_UCSZ0_BIT_VALUE                   (1<<UCSZ0)
#ifdef URSEL
#define UART0_URSEL_BIT_VALUE                   (1<<URSEL)
#else
#define UART0_URSEL_BIT_VALUE                   (0)
#endif
#define UART0_TXEN_BIT_VALUE                    (1<<TXEN)
#define UART0_UDR                               UDR
#define UART0_U2X                               U2X

#endif

/*---------------------------------------------------------------------------------------------------------------------------------------------------
 *  Initialize  UART
 *  @details  Initializes UART
 *---------------------------------------------------------------------------------------------------------------------------------------------------
 */
void
irmp_uart_init (void)
{
    UART0_UBRRH = UBRRH_VALUE;                                                                      // set baud rate
    UART0_UBRRL = UBRRL_VALUE;

#if USE_2X
    UART0_UCSRA |= (1<<UART0_U2X);
#else
    UART0_UCSRA &= ~(1<<UART0_U2X);
#endif

    UART0_UCSRC = UART0_UCSZ1_BIT_VALUE | UART0_UCSZ0_BIT_VALUE | UART0_URSEL_BIT_VALUE;
    UART0_UCSRB |= UART0_TXEN_BIT_VALUE;                                                            // enable UART TX
}

/*---------------------------------------------------------------------------------------------------------------------------------------------------
 *  Send character
 *  @details  Sends character
 *  @param    ch character to be transmitted
 *---------------------------------------------------------------------------------------------------------------------------------------------------
 */
void
irmp_uart_putc (unsigned char ch)
{
    while (!(UART0_UCSRA & UART0_UDRE_BIT_VALUE))
    {
        ;
    }

    UART0_UDR = ch;
}

/*---------------------------------------------------------------------------------------------------------------------------------------------------
 *  Log IR signal
 *---------------------------------------------------------------------------------------------------------------------------------------------------
 */

#define STARTCYCLES                       2                                 // min count of zeros before start of logging
#define ENDBITS                        1000                                 // number of sequenced highbits to detect end
#define DATALEN                         700                                 // log buffer size

static void
irmp_log (uint8_t val)
{
    static uint8_t  buf[DATALEN];                                           // logging buffer
    static uint16_t buf_idx;                                                // number of written bits
    static uint8_t  startcycles;                                            // current number of start-zeros
    static uint16_t cnt;                                                    // counts sequenced highbits - to detect end

    if (! val && (startcycles < STARTCYCLES) && !buf_idx)                   // prevent that single random zeros init logging
    {
        startcycles++;
    }
    else
    {
        startcycles = 0;

        if (! val || (val && buf_idx != 0))                                 // start or continue logging on "0", "1" cannot init logging
        {
            if (buf_idx < DATALEN * 8)                                      // index in range?
            {                                                               // yes
                if (val)
                {
                    buf[(buf_idx / 8)] |=  (1<<(buf_idx % 8));              // set bit
                }
                else
                {
                    buf[(buf_idx / 8)] &= ~(1<<(buf_idx % 8));              // reset bit
                }

                buf_idx++;
            }

            if (val)
            {                                                               // if high received then look at log-stop condition
                cnt++;

                if (cnt > ENDBITS)
                {                                                           // if stop condition is true, output on uart
                    uint16_t i;

                    for (i = 0; i < STARTCYCLES; i++)
                    {
                        irmp_uart_putc ('0');                               // the ignored starting zeros
                    }

                    for (i = 0; i < (buf_idx - ENDBITS + 20) / 8; i++)      // transform bitset into uart chars
                    {
                        uint8_t d = buf[i];
                        uint8_t j;

                        for (j = 0; j < 8; j++)
                        {
                            irmp_uart_putc ((d & 1) + '0');
                            d >>= 1;
                        }
                    }

                    irmp_uart_putc ('\n');
                    buf_idx = 0;
                }
            }
            else
            {
                cnt = 0;
            }
        }
    }
}

#else
#define irmp_log(val)
#endif

typedef struct
{
    uint8_t    protocol;                                                // ir protocol
    uint8_t    pulse_1_len_min;                                         // minimum length of pulse with bit value 1
    uint8_t    pulse_1_len_max;                                         // maximum length of pulse with bit value 1
    uint8_t    pause_1_len_min;                                         // minimum length of pause with bit value 1
    uint8_t    pause_1_len_max;                                         // maximum length of pause with bit value 1
    uint8_t    pulse_0_len_min;                                         // minimum length of pulse with bit value 0
    uint8_t    pulse_0_len_max;                                         // maximum length of pulse with bit value 0
    uint8_t    pause_0_len_min;                                         // minimum length of pause with bit value 0
    uint8_t    pause_0_len_max;                                         // maximum length of pause with bit value 0
    uint8_t    address_offset;                                          // address offset
    uint8_t    address_end;                                             // end of address
    uint8_t    command_offset;                                          // command offset
    uint8_t    command_end;                                             // end of command
    uint8_t    complete_len;                                            // complete length of frame
    uint8_t    stop_bit;                                                // flag: frame has stop bit
    uint8_t    lsb_first;                                               // flag: LSB first
    uint8_t    flags;                                                   // some flags
} IRMP_PARAMETER;

#if IRMP_SUPPORT_SIRCS_PROTOCOL == 1

static PROGMEM IRMP_PARAMETER sircs_param =
{
    IRMP_SIRCS_PROTOCOL,                                                // protocol:        ir protocol
    SIRCS_1_PULSE_LEN_MIN,                                              // pulse_1_len_min: minimum length of pulse with bit value 1
    SIRCS_1_PULSE_LEN_MAX,                                              // pulse_1_len_max: maximum length of pulse with bit value 1
    SIRCS_PAUSE_LEN_MIN,                                                // pause_1_len_min: minimum length of pause with bit value 1
    SIRCS_PAUSE_LEN_MAX,                                                // pause_1_len_max: maximum length of pause with bit value 1
    SIRCS_0_PULSE_LEN_MIN,                                              // pulse_0_len_min: minimum length of pulse with bit value 0
    SIRCS_0_PULSE_LEN_MAX,                                              // pulse_0_len_max: maximum length of pulse with bit value 0
    SIRCS_PAUSE_LEN_MIN,                                                // pause_0_len_min: minimum length of pause with bit value 0
    SIRCS_PAUSE_LEN_MAX,                                                // pause_0_len_max: maximum length of pause with bit value 0
    SIRCS_ADDRESS_OFFSET,                                               // address_offset:  address offset
    SIRCS_ADDRESS_OFFSET + SIRCS_ADDRESS_LEN,                           // address_end:     end of address
    SIRCS_COMMAND_OFFSET,                                               // command_offset:  command offset
    SIRCS_COMMAND_OFFSET + SIRCS_COMMAND_LEN,                           // command_end:     end of command
    SIRCS_COMPLETE_DATA_LEN,                                            // complete_len:    complete length of frame
    SIRCS_STOP_BIT,                                                     // stop_bit:        flag: frame has stop bit
    SIRCS_LSB,                                                          // lsb_first:       flag: LSB first
    SIRCS_FLAGS                                                         // flags:           some flags
};

#endif

#if IRMP_SUPPORT_NEC_PROTOCOL == 1

static PROGMEM IRMP_PARAMETER nec_param =
{
    IRMP_NEC_PROTOCOL,                                                  // protocol:        ir protocol
    NEC_PULSE_LEN_MIN,                                                  // pulse_1_len_min: minimum length of pulse with bit value 1
    NEC_PULSE_LEN_MAX,                                                  // pulse_1_len_max: maximum length of pulse with bit value 1
    NEC_1_PAUSE_LEN_MIN,                                                // pause_1_len_min: minimum length of pause with bit value 1
    NEC_1_PAUSE_LEN_MAX,                                                // pause_1_len_max: maximum length of pause with bit value 1
    NEC_PULSE_LEN_MIN,                                                  // pulse_0_len_min: minimum length of pulse with bit value 0
    NEC_PULSE_LEN_MAX,                                                  // pulse_0_len_max: maximum length of pulse with bit value 0
    NEC_0_PAUSE_LEN_MIN,                                                // pause_0_len_min: minimum length of pause with bit value 0
    NEC_0_PAUSE_LEN_MAX,                                                // pause_0_len_max: maximum length of pause with bit value 0
    NEC_ADDRESS_OFFSET,                                                 // address_offset:  address offset
    NEC_ADDRESS_OFFSET + NEC_ADDRESS_LEN,                               // address_end:     end of address
    NEC_COMMAND_OFFSET,                                                 // command_offset:  command offset
    NEC_COMMAND_OFFSET + NEC_COMMAND_LEN,                               // command_end:     end of command
    NEC_COMPLETE_DATA_LEN,                                              // complete_len:    complete length of frame
    NEC_STOP_BIT,                                                       // stop_bit:        flag: frame has stop bit
    NEC_LSB,                                                            // lsb_first:       flag: LSB first
    NEC_FLAGS                                                           // flags:           some flags
};

static PROGMEM IRMP_PARAMETER nec_rep_param =
{
    IRMP_NEC_PROTOCOL,                                                  // protocol:        ir protocol
    NEC_PULSE_LEN_MIN,                                                  // pulse_1_len_min: minimum length of pulse with bit value 1
    NEC_PULSE_LEN_MAX,                                                  // pulse_1_len_max: maximum length of pulse with bit value 1
    NEC_1_PAUSE_LEN_MIN,                                                // pause_1_len_min: minimum length of pause with bit value 1
    NEC_1_PAUSE_LEN_MAX,                                                // pause_1_len_max: maximum length of pause with bit value 1
    NEC_PULSE_LEN_MIN,                                                  // pulse_0_len_min: minimum length of pulse with bit value 0
    NEC_PULSE_LEN_MAX,                                                  // pulse_0_len_max: maximum length of pulse with bit value 0
    NEC_0_PAUSE_LEN_MIN,                                                // pause_0_len_min: minimum length of pause with bit value 0
    NEC_0_PAUSE_LEN_MAX,                                                // pause_0_len_max: maximum length of pause with bit value 0
    0,                                                                  // address_offset:  address offset
    0,                                                                  // address_end:     end of address
    0,                                                                  // command_offset:  command offset
    0,                                                                  // command_end:     end of command
    0,                                                                  // complete_len:    complete length of frame
    NEC_STOP_BIT,                                                       // stop_bit:        flag: frame has stop bit
    NEC_LSB,                                                            // lsb_first:       flag: LSB first
    NEC_FLAGS                                                           // flags:           some flags
};

#endif

#if IRMP_SUPPORT_SAMSUNG_PROTOCOL == 1

static PROGMEM IRMP_PARAMETER samsung_param =
{
    IRMP_SAMSUNG_PROTOCOL,                                              // protocol:        ir protocol
    SAMSUNG_PULSE_LEN_MIN,                                              // pulse_1_len_min: minimum length of pulse with bit value 1
    SAMSUNG_PULSE_LEN_MAX,                                              // pulse_1_len_max: maximum length of pulse with bit value 1
    SAMSUNG_1_PAUSE_LEN_MIN,                                            // pause_1_len_min: minimum length of pause with bit value 1
    SAMSUNG_1_PAUSE_LEN_MAX,                                            // pause_1_len_max: maximum length of pause with bit value 1
    SAMSUNG_PULSE_LEN_MIN,                                              // pulse_0_len_min: minimum length of pulse with bit value 0
    SAMSUNG_PULSE_LEN_MAX,                                              // pulse_0_len_max: maximum length of pulse with bit value 0
    SAMSUNG_0_PAUSE_LEN_MIN,                                            // pause_0_len_min: minimum length of pause with bit value 0
    SAMSUNG_0_PAUSE_LEN_MAX,                                            // pause_0_len_max: maximum length of pause with bit value 0
    SAMSUNG_ADDRESS_OFFSET,                                             // address_offset:  address offset
    SAMSUNG_ADDRESS_OFFSET + SAMSUNG_ADDRESS_LEN,                       // address_end:     end of address
    SAMSUNG_COMMAND_OFFSET,                                             // command_offset:  command offset
    SAMSUNG_COMMAND_OFFSET + SAMSUNG_COMMAND_LEN,                       // command_end:     end of command
    SAMSUNG_COMPLETE_DATA_LEN,                                          // complete_len:    complete length of frame
    SAMSUNG_STOP_BIT,                                                   // stop_bit:        flag: frame has stop bit
    SAMSUNG_LSB,                                                        // lsb_first:       flag: LSB first
    SAMSUNG_FLAGS                                                       // flags:           some flags
};

#endif

#if IRMP_SUPPORT_MATSUSHITA_PROTOCOL == 1

static PROGMEM IRMP_PARAMETER matsushita_param =
{
    IRMP_MATSUSHITA_PROTOCOL,                                           // protocol:        ir protocol
    MATSUSHITA_PULSE_LEN_MIN,                                           // pulse_1_len_min: minimum length of pulse with bit value 1
    MATSUSHITA_PULSE_LEN_MAX,                                           // pulse_1_len_max: maximum length of pulse with bit value 1
    MATSUSHITA_1_PAUSE_LEN_MIN,                                         // pause_1_len_min: minimum length of pause with bit value 1
    MATSUSHITA_1_PAUSE_LEN_MAX,                                         // pause_1_len_max: maximum length of pause with bit value 1
    MATSUSHITA_PULSE_LEN_MIN,                                           // pulse_0_len_min: minimum length of pulse with bit value 0
    MATSUSHITA_PULSE_LEN_MAX,                                           // pulse_0_len_max: maximum length of pulse with bit value 0
    MATSUSHITA_0_PAUSE_LEN_MIN,                                         // pause_0_len_min: minimum length of pause with bit value 0
    MATSUSHITA_0_PAUSE_LEN_MAX,                                         // pause_0_len_max: maximum length of pause with bit value 0
    MATSUSHITA_ADDRESS_OFFSET,                                          // address_offset:  address offset
    MATSUSHITA_ADDRESS_OFFSET + MATSUSHITA_ADDRESS_LEN,                 // address_end:     end of address
    MATSUSHITA_COMMAND_OFFSET,                                          // command_offset:  command offset
    MATSUSHITA_COMMAND_OFFSET + MATSUSHITA_COMMAND_LEN,                 // command_end:     end of command
    MATSUSHITA_COMPLETE_DATA_LEN,                                       // complete_len:    complete length of frame
    MATSUSHITA_STOP_BIT,                                                // stop_bit:        flag: frame has stop bit
    MATSUSHITA_LSB,                                                     // lsb_first:       flag: LSB first
    MATSUSHITA_FLAGS                                                    // flags:           some flags
};

#endif

#if IRMP_SUPPORT_KASEIKYO_PROTOCOL == 1

static PROGMEM IRMP_PARAMETER kaseikyo_param =
{
    IRMP_KASEIKYO_PROTOCOL,                                             // protocol:        ir protocol
    KASEIKYO_PULSE_LEN_MIN,                                             // pulse_1_len_min: minimum length of pulse with bit value 1
    KASEIKYO_PULSE_LEN_MAX,                                             // pulse_1_len_max: maximum length of pulse with bit value 1
    KASEIKYO_1_PAUSE_LEN_MIN,                                           // pause_1_len_min: minimum length of pause with bit value 1
    KASEIKYO_1_PAUSE_LEN_MAX,                                           // pause_1_len_max: maximum length of pause with bit value 1
    KASEIKYO_PULSE_LEN_MIN,                                             // pulse_0_len_min: minimum length of pulse with bit value 0
    KASEIKYO_PULSE_LEN_MAX,                                             // pulse_0_len_max: maximum length of pulse with bit value 0
    KASEIKYO_0_PAUSE_LEN_MIN,                                           // pause_0_len_min: minimum length of pause with bit value 0
    KASEIKYO_0_PAUSE_LEN_MAX,                                           // pause_0_len_max: maximum length of pause with bit value 0
    KASEIKYO_ADDRESS_OFFSET,                                            // address_offset:  address offset
    KASEIKYO_ADDRESS_OFFSET + KASEIKYO_ADDRESS_LEN,                     // address_end:     end of address
    KASEIKYO_COMMAND_OFFSET,                                            // command_offset:  command offset
    KASEIKYO_COMMAND_OFFSET + KASEIKYO_COMMAND_LEN,                     // command_end:     end of command
    KASEIKYO_COMPLETE_DATA_LEN,                                         // complete_len:    complete length of frame
    KASEIKYO_STOP_BIT,                                                  // stop_bit:        flag: frame has stop bit
    KASEIKYO_LSB,                                                       // lsb_first:       flag: LSB first
    KASEIKYO_FLAGS                                                      // flags:           some flags
};

#endif

#if IRMP_SUPPORT_RECS80_PROTOCOL == 1

static PROGMEM IRMP_PARAMETER recs80_param =
{
    IRMP_RECS80_PROTOCOL,                                               // protocol:        ir protocol
    RECS80_PULSE_LEN_MIN,                                               // pulse_1_len_min: minimum length of pulse with bit value 1
    RECS80_PULSE_LEN_MAX,                                               // pulse_1_len_max: maximum length of pulse with bit value 1
    RECS80_1_PAUSE_LEN_MIN,                                             // pause_1_len_min: minimum length of pause with bit value 1
    RECS80_1_PAUSE_LEN_MAX,                                             // pause_1_len_max: maximum length of pause with bit value 1
    RECS80_PULSE_LEN_MIN,                                               // pulse_0_len_min: minimum length of pulse with bit value 0
    RECS80_PULSE_LEN_MAX,                                               // pulse_0_len_max: maximum length of pulse with bit value 0
    RECS80_0_PAUSE_LEN_MIN,                                             // pause_0_len_min: minimum length of pause with bit value 0
    RECS80_0_PAUSE_LEN_MAX,                                             // pause_0_len_max: maximum length of pause with bit value 0
    RECS80_ADDRESS_OFFSET,                                              // address_offset:  address offset
    RECS80_ADDRESS_OFFSET + RECS80_ADDRESS_LEN,                         // address_end:     end of address
    RECS80_COMMAND_OFFSET,                                              // command_offset:  command offset
    RECS80_COMMAND_OFFSET + RECS80_COMMAND_LEN,                         // command_end:     end of command
    RECS80_COMPLETE_DATA_LEN,                                           // complete_len:    complete length of frame
    RECS80_STOP_BIT,                                                    // stop_bit:        flag: frame has stop bit
    RECS80_LSB,                                                         // lsb_first:       flag: LSB first
    RECS80_FLAGS                                                        // flags:           some flags
};

#endif

#if IRMP_SUPPORT_RC5_PROTOCOL == 1

static PROGMEM IRMP_PARAMETER rc5_param =
{
    IRMP_RC5_PROTOCOL,                                                  // protocol:        ir protocol
    RC5_BIT_LEN_MIN,                                                    // pulse_1_len_min: minimum length of pulse with bit value 1
    RC5_BIT_LEN_MAX,                                                    // pulse_1_len_max: maximum length of pulse with bit value 1
    RC5_BIT_LEN_MIN,                                                    // pause_1_len_min: minimum length of pause with bit value 1
    RC5_BIT_LEN_MAX,                                                    // pause_1_len_max: maximum length of pause with bit value 1
    1,  // tricky: use this as stop bit length                          // pulse_0_len_min: minimum length of pulse with bit value 0
    1,                                                                  // pulse_0_len_max: maximum length of pulse with bit value 0
    1,                                                                  // pause_0_len_min: minimum length of pause with bit value 0
    1,                                                                  // pause_0_len_max: maximum length of pause with bit value 0
    RC5_ADDRESS_OFFSET,                                                 // address_offset:  address offset
    RC5_ADDRESS_OFFSET + RC5_ADDRESS_LEN,                               // address_end:     end of address
    RC5_COMMAND_OFFSET,                                                 // command_offset:  command offset
    RC5_COMMAND_OFFSET + RC5_COMMAND_LEN,                               // command_end:     end of command
    RC5_COMPLETE_DATA_LEN,                                              // complete_len:    complete length of frame
    RC5_STOP_BIT,                                                       // stop_bit:        flag: frame has stop bit
    RC5_LSB,                                                            // lsb_first:       flag: LSB first
    RC5_FLAGS                                                           // flags:           some flags
};

#endif

#if IRMP_SUPPORT_DENON_PROTOCOL == 1

static PROGMEM IRMP_PARAMETER denon_param =
{
    IRMP_DENON_PROTOCOL,                                                // protocol:        ir protocol
    DENON_PULSE_LEN_MIN,                                                // pulse_1_len_min: minimum length of pulse with bit value 1
    DENON_PULSE_LEN_MAX,                                                // pulse_1_len_max: maximum length of pulse with bit value 1
    DENON_1_PAUSE_LEN_MIN,                                              // pause_1_len_min: minimum length of pause with bit value 1
    DENON_1_PAUSE_LEN_MAX,                                              // pause_1_len_max: maximum length of pause with bit value 1
    DENON_PULSE_LEN_MIN,                                                // pulse_0_len_min: minimum length of pulse with bit value 0
    DENON_PULSE_LEN_MAX,                                                // pulse_0_len_max: maximum length of pulse with bit value 0
    DENON_0_PAUSE_LEN_MIN,                                              // pause_0_len_min: minimum length of pause with bit value 0
    DENON_0_PAUSE_LEN_MAX,                                              // pause_0_len_max: maximum length of pause with bit value 0
    DENON_ADDRESS_OFFSET,                                               // address_offset:  address offset
    DENON_ADDRESS_OFFSET + DENON_ADDRESS_LEN,                           // address_end:     end of address
    DENON_COMMAND_OFFSET,                                               // command_offset:  command offset
    DENON_COMMAND_OFFSET + DENON_COMMAND_LEN,                           // command_end:     end of command
    DENON_COMPLETE_DATA_LEN,                                            // complete_len:    complete length of frame
    DENON_STOP_BIT,                                                     // stop_bit:        flag: frame has stop bit
    DENON_LSB,                                                          // lsb_first:       flag: LSB first
    DENON_FLAGS                                                         // flags:           some flags
};

#endif

#if IRMP_SUPPORT_RC6_PROTOCOL == 1

static PROGMEM IRMP_PARAMETER rc6_param =
{
    IRMP_RC6_PROTOCOL,                                                  // protocol:        ir protocol
    RC6_BIT_PULSE_LEN_MIN,                                              // pulse_1_len_min: minimum length of pulse with bit value 1
    RC6_BIT_PULSE_LEN_MAX,                                              // pulse_1_len_max: maximum length of pulse with bit value 1
    RC6_BIT_PAUSE_LEN_MIN,                                              // pause_1_len_min: minimum length of pause with bit value 1
    RC6_BIT_PAUSE_LEN_MAX,                                              // pause_1_len_max: maximum length of pause with bit value 1
    1,  // tricky: use this as stop bit length                          // pulse_0_len_min: minimum length of pulse with bit value 0
    1,                                                                  // pulse_0_len_max: maximum length of pulse with bit value 0
    1,                                                                  // pause_0_len_min: minimum length of pause with bit value 0
    1,                                                                  // pause_0_len_max: maximum length of pause with bit value 0
    RC6_ADDRESS_OFFSET,                                                 // address_offset:  address offset
    RC6_ADDRESS_OFFSET + RC6_ADDRESS_LEN,                               // address_end:     end of address
    RC6_COMMAND_OFFSET,                                                 // command_offset:  command offset
    RC6_COMMAND_OFFSET + RC6_COMMAND_LEN,                               // command_end:     end of command
    RC6_COMPLETE_DATA_LEN_SHORT,                                        // complete_len:    complete length of frame
    RC6_STOP_BIT,                                                       // stop_bit:        flag: frame has stop bit
    RC6_LSB,                                                            // lsb_first:       flag: LSB first
    RC6_FLAGS                                                           // flags:           some flags
};

#endif

#if IRMP_SUPPORT_RECS80EXT_PROTOCOL == 1

static PROGMEM IRMP_PARAMETER recs80ext_param =
{
    IRMP_RECS80EXT_PROTOCOL,                                            // protocol:        ir protocol
    RECS80EXT_PULSE_LEN_MIN,                                            // pulse_1_len_min: minimum length of pulse with bit value 1
    RECS80EXT_PULSE_LEN_MAX,                                            // pulse_1_len_max: maximum length of pulse with bit value 1
    RECS80EXT_1_PAUSE_LEN_MIN,                                          // pause_1_len_min: minimum length of pause with bit value 1
    RECS80EXT_1_PAUSE_LEN_MAX,                                          // pause_1_len_max: maximum length of pause with bit value 1
    RECS80EXT_PULSE_LEN_MIN,                                            // pulse_0_len_min: minimum length of pulse with bit value 0
    RECS80EXT_PULSE_LEN_MAX,                                            // pulse_0_len_max: maximum length of pulse with bit value 0
    RECS80EXT_0_PAUSE_LEN_MIN,                                          // pause_0_len_min: minimum length of pause with bit value 0
    RECS80EXT_0_PAUSE_LEN_MAX,                                          // pause_0_len_max: maximum length of pause with bit value 0
    RECS80EXT_ADDRESS_OFFSET,                                           // address_offset:  address offset
    RECS80EXT_ADDRESS_OFFSET + RECS80EXT_ADDRESS_LEN,                   // address_end:     end of address
    RECS80EXT_COMMAND_OFFSET,                                           // command_offset:  command offset
    RECS80EXT_COMMAND_OFFSET + RECS80EXT_COMMAND_LEN,                   // command_end:     end of command
    RECS80EXT_COMPLETE_DATA_LEN,                                        // complete_len:    complete length of frame
    RECS80EXT_STOP_BIT,                                                 // stop_bit:        flag: frame has stop bit
    RECS80EXT_LSB,                                                      // lsb_first:       flag: LSB first
    RECS80EXT_FLAGS                                                     // flags:           some flags
};

#endif

#if IRMP_SUPPORT_NUBERT_PROTOCOL == 1

static PROGMEM IRMP_PARAMETER nubert_param =
{
    IRMP_NUBERT_PROTOCOL,                                               // protocol:        ir protocol
    NUBERT_1_PULSE_LEN_MIN,                                             // pulse_1_len_min: minimum length of pulse with bit value 1
    NUBERT_1_PULSE_LEN_MAX,                                             // pulse_1_len_max: maximum length of pulse with bit value 1
    NUBERT_1_PAUSE_LEN_MIN,                                             // pause_1_len_min: minimum length of pause with bit value 1
    NUBERT_1_PAUSE_LEN_MAX,                                             // pause_1_len_max: maximum length of pause with bit value 1
    NUBERT_0_PULSE_LEN_MIN,                                             // pulse_0_len_min: minimum length of pulse with bit value 0
    NUBERT_0_PULSE_LEN_MAX,                                             // pulse_0_len_max: maximum length of pulse with bit value 0
    NUBERT_0_PAUSE_LEN_MIN,                                             // pause_0_len_min: minimum length of pause with bit value 0
    NUBERT_0_PAUSE_LEN_MAX,                                             // pause_0_len_max: maximum length of pause with bit value 0
    NUBERT_ADDRESS_OFFSET,                                              // address_offset:  address offset
    NUBERT_ADDRESS_OFFSET + NUBERT_ADDRESS_LEN,                         // address_end:     end of address
    NUBERT_COMMAND_OFFSET,                                              // command_offset:  command offset
    NUBERT_COMMAND_OFFSET + NUBERT_COMMAND_LEN,                         // command_end:     end of command
    NUBERT_COMPLETE_DATA_LEN,                                           // complete_len:    complete length of frame
    NUBERT_STOP_BIT,                                                    // stop_bit:        flag: frame has stop bit
    NUBERT_LSB,                                                         // lsb_first:       flag: LSB first
    NUBERT_FLAGS                                                        // flags:           some flags
};

#endif

#if IRMP_SUPPORT_BANG_OLUFSEN_PROTOCOL == 1

static PROGMEM IRMP_PARAMETER bang_olufsen_param =
{
    IRMP_BANG_OLUFSEN_PROTOCOL,                                         // protocol:        ir protocol
    BANG_OLUFSEN_PULSE_LEN_MIN,                                         // pulse_1_len_min: minimum length of pulse with bit value 1
    BANG_OLUFSEN_PULSE_LEN_MAX,                                         // pulse_1_len_max: maximum length of pulse with bit value 1
    BANG_OLUFSEN_1_PAUSE_LEN_MIN,                                       // pause_1_len_min: minimum length of pause with bit value 1
    BANG_OLUFSEN_1_PAUSE_LEN_MAX,                                       // pause_1_len_max: maximum length of pause with bit value 1
    BANG_OLUFSEN_PULSE_LEN_MIN,                                         // pulse_0_len_min: minimum length of pulse with bit value 0
    BANG_OLUFSEN_PULSE_LEN_MAX,                                         // pulse_0_len_max: maximum length of pulse with bit value 0
    BANG_OLUFSEN_0_PAUSE_LEN_MIN,                                       // pause_0_len_min: minimum length of pause with bit value 0
    BANG_OLUFSEN_0_PAUSE_LEN_MAX,                                       // pause_0_len_max: maximum length of pause with bit value 0
    BANG_OLUFSEN_ADDRESS_OFFSET,                                        // address_offset:  address offset
    BANG_OLUFSEN_ADDRESS_OFFSET + BANG_OLUFSEN_ADDRESS_LEN,             // address_end:     end of address
    BANG_OLUFSEN_COMMAND_OFFSET,                                        // command_offset:  command offset
    BANG_OLUFSEN_COMMAND_OFFSET + BANG_OLUFSEN_COMMAND_LEN,             // command_end:     end of command
    BANG_OLUFSEN_COMPLETE_DATA_LEN,                                     // complete_len:    complete length of frame
    BANG_OLUFSEN_STOP_BIT,                                              // stop_bit:        flag: frame has stop bit
    BANG_OLUFSEN_LSB,                                                   // lsb_first:       flag: LSB first
    BANG_OLUFSEN_FLAGS                                                  // flags:           some flags
};

#endif

#if IRMP_SUPPORT_GRUNDIG_OR_NOKIA_PROTOCOL == 1

static PROGMEM IRMP_PARAMETER grundig_param =
{
    IRMP_GRUNDIG_PROTOCOL,                                              // protocol:        ir protocol
    GRUNDIG_OR_NOKIA_BIT_LEN_MIN,                                       // pulse_1_len_min: minimum length of pulse with bit value 1
    GRUNDIG_OR_NOKIA_BIT_LEN_MAX,                                       // pulse_1_len_max: maximum length of pulse with bit value 1
    GRUNDIG_OR_NOKIA_BIT_LEN_MIN,                                       // pause_1_len_min: minimum length of pause with bit value 1
    GRUNDIG_OR_NOKIA_BIT_LEN_MAX,                                       // pause_1_len_max: maximum length of pause with bit value 1
    1,  // tricky: use this as stop bit length                          // pulse_0_len_min: minimum length of pulse with bit value 0
    1,                                                                  // pulse_0_len_max: maximum length of pulse with bit value 0
    1,                                                                  // pause_0_len_min: minimum length of pause with bit value 0
    1,                                                                  // pause_0_len_max: maximum length of pause with bit value 0
    GRUNDIG_ADDRESS_OFFSET,                                             // address_offset:  address offset
    GRUNDIG_ADDRESS_OFFSET + GRUNDIG_ADDRESS_LEN,                       // address_end:     end of address
    GRUNDIG_COMMAND_OFFSET,                                             // command_offset:  command offset
    GRUNDIG_COMMAND_OFFSET + GRUNDIG_COMMAND_LEN + 1,                   // command_end:     end of command (USE 1 bit MORE to STORE NOKIA DATA!)
    NOKIA_COMPLETE_DATA_LEN,                                            // complete_len:    complete length of frame, here: NOKIA instead of GRUNDIG!
    GRUNDIG_OR_NOKIA_STOP_BIT,                                          // stop_bit:        flag: frame has stop bit
    GRUNDIG_OR_NOKIA_LSB,                                               // lsb_first:       flag: LSB first
    GRUNDIG_OR_NOKIA_FLAGS                                              // flags:           some flags
};

#endif

#if IRMP_SUPPORT_SIEMENS_PROTOCOL == 1

static PROGMEM IRMP_PARAMETER siemens_param =
{
    IRMP_SIEMENS_PROTOCOL,                                              // protocol:        ir protocol
    SIEMENS_BIT_LEN_MIN,                                                // pulse_1_len_min: minimum length of pulse with bit value 1
    SIEMENS_BIT_LEN_MAX,                                                // pulse_1_len_max: maximum length of pulse with bit value 1
    SIEMENS_BIT_LEN_MIN,                                                // pause_1_len_min: minimum length of pause with bit value 1
    SIEMENS_BIT_LEN_MAX,                                                // pause_1_len_max: maximum length of pause with bit value 1
    1,  // tricky: use this as stop bit length                          // pulse_0_len_min: minimum length of pulse with bit value 0
    1,                                                                  // pulse_0_len_max: maximum length of pulse with bit value 0
    1,                                                                  // pause_0_len_min: minimum length of pause with bit value 0
    1,                                                                  // pause_0_len_max: maximum length of pause with bit value 0
    SIEMENS_ADDRESS_OFFSET,                                             // address_offset:  address offset
    SIEMENS_ADDRESS_OFFSET + SIEMENS_ADDRESS_LEN,                       // address_end:     end of address
    SIEMENS_COMMAND_OFFSET,                                             // command_offset:  command offset
    SIEMENS_COMMAND_OFFSET + SIEMENS_COMMAND_LEN,                       // command_end:     end of command
    SIEMENS_COMPLETE_DATA_LEN,                                          // complete_len:    complete length of frame
    SIEMENS_STOP_BIT,                                                   // stop_bit:        flag: frame has stop bit
    SIEMENS_LSB,                                                        // lsb_first:       flag: LSB first
    SIEMENS_FLAGS                                                       // flags:           some flags
};

#endif

#if IRMP_SUPPORT_FDC_PROTOCOL == 1

static PROGMEM IRMP_PARAMETER fdc_param =
{
    IRMP_FDC_PROTOCOL,                                                  // protocol:        ir protocol
    FDC_PULSE_LEN_MIN,                                                  // pulse_1_len_min: minimum length of pulse with bit value 1
    FDC_PULSE_LEN_MAX,                                                  // pulse_1_len_max: maximum length of pulse with bit value 1
    FDC_1_PAUSE_LEN_MIN,                                                // pause_1_len_min: minimum length of pause with bit value 1
    FDC_1_PAUSE_LEN_MAX,                                                // pause_1_len_max: maximum length of pause with bit value 1
    FDC_PULSE_LEN_MIN,                                                  // pulse_0_len_min: minimum length of pulse with bit value 0
    FDC_PULSE_LEN_MAX,                                                  // pulse_0_len_max: maximum length of pulse with bit value 0
    FDC_0_PAUSE_LEN_MIN,                                                // pause_0_len_min: minimum length of pause with bit value 0
    FDC_0_PAUSE_LEN_MAX,                                                // pause_0_len_max: maximum length of pause with bit value 0
    FDC_ADDRESS_OFFSET,                                                 // address_offset:  address offset
    FDC_ADDRESS_OFFSET + FDC_ADDRESS_LEN,                               // address_end:     end of address
    FDC_COMMAND_OFFSET,                                                 // command_offset:  command offset
    FDC_COMMAND_OFFSET + FDC_COMMAND_LEN,                               // command_end:     end of command
    FDC_COMPLETE_DATA_LEN,                                              // complete_len:    complete length of frame
    FDC_STOP_BIT,                                                       // stop_bit:        flag: frame has stop bit
    FDC_LSB,                                                            // lsb_first:       flag: LSB first
    FDC_FLAGS                                                           // flags:           some flags
};

#endif

#if IRMP_SUPPORT_RCCAR_PROTOCOL == 1

static PROGMEM IRMP_PARAMETER rccar_param =
{
    IRMP_RCCAR_PROTOCOL,                                                // protocol:        ir protocol
    RCCAR_PULSE_LEN_MIN,                                                // pulse_1_len_min: minimum length of pulse with bit value 1
    RCCAR_PULSE_LEN_MAX,                                                // pulse_1_len_max: maximum length of pulse with bit value 1
    RCCAR_1_PAUSE_LEN_MIN,                                              // pause_1_len_min: minimum length of pause with bit value 1
    RCCAR_1_PAUSE_LEN_MAX,                                              // pause_1_len_max: maximum length of pause with bit value 1
    RCCAR_PULSE_LEN_MIN,                                                // pulse_0_len_min: minimum length of pulse with bit value 0
    RCCAR_PULSE_LEN_MAX,                                                // pulse_0_len_max: maximum length of pulse with bit value 0
    RCCAR_0_PAUSE_LEN_MIN,                                              // pause_0_len_min: minimum length of pause with bit value 0
    RCCAR_0_PAUSE_LEN_MAX,                                              // pause_0_len_max: maximum length of pause with bit value 0
    RCCAR_ADDRESS_OFFSET,                                               // address_offset:  address offset
    RCCAR_ADDRESS_OFFSET + RCCAR_ADDRESS_LEN,                           // address_end:     end of address
    RCCAR_COMMAND_OFFSET,                                               // command_offset:  command offset
    RCCAR_COMMAND_OFFSET + RCCAR_COMMAND_LEN,                           // command_end:     end of command
    RCCAR_COMPLETE_DATA_LEN,                                            // complete_len:    complete length of frame
    RCCAR_STOP_BIT,                                                     // stop_bit:        flag: frame has stop bit
    RCCAR_LSB,                                                          // lsb_first:       flag: LSB first
    RCCAR_FLAGS                                                         // flags:           some flags
};

#endif

#if IRMP_SUPPORT_NIKON_PROTOCOL == 1

static PROGMEM IRMP_PARAMETER nikon_param =
{
    IRMP_NIKON_PROTOCOL,                                                // protocol:        ir protocol
    NIKON_PULSE_LEN_MIN,                                                // pulse_1_len_min: minimum length of pulse with bit value 1
    NIKON_PULSE_LEN_MAX,                                                // pulse_1_len_max: maximum length of pulse with bit value 1
    NIKON_1_PAUSE_LEN_MIN,                                              // pause_1_len_min: minimum length of pause with bit value 1
    NIKON_1_PAUSE_LEN_MAX,                                              // pause_1_len_max: maximum length of pause with bit value 1
    NIKON_PULSE_LEN_MIN,                                                // pulse_0_len_min: minimum length of pulse with bit value 0
    NIKON_PULSE_LEN_MAX,                                                // pulse_0_len_max: maximum length of pulse with bit value 0
    NIKON_0_PAUSE_LEN_MIN,                                              // pause_0_len_min: minimum length of pause with bit value 0
    NIKON_0_PAUSE_LEN_MAX,                                              // pause_0_len_max: maximum length of pause with bit value 0
    NIKON_ADDRESS_OFFSET,                                               // address_offset:  address offset
    NIKON_ADDRESS_OFFSET + NIKON_ADDRESS_LEN,                           // address_end:     end of address
    NIKON_COMMAND_OFFSET,                                               // command_offset:  command offset
    NIKON_COMMAND_OFFSET + NIKON_COMMAND_LEN,                           // command_end:     end of command
    NIKON_COMPLETE_DATA_LEN,                                            // complete_len:    complete length of frame
    NIKON_STOP_BIT,                                                     // stop_bit:        flag: frame has stop bit
    NIKON_LSB,                                                          // lsb_first:       flag: LSB first
    NIKON_FLAGS                                                         // flags:           some flags
};

#endif

static uint8_t                              irmp_bit;                   // current bit position
static IRMP_PARAMETER                       irmp_param;

#if IRMP_SUPPORT_RC5_PROTOCOL == 1 && (IRMP_SUPPORT_FDC_PROTOCOL == 1 || IRMP_SUPPORT_RCCAR_PROTOCOL == 1)
static IRMP_PARAMETER                       irmp_param2;
#endif

static volatile uint8_t                     irmp_ir_detected;
static volatile uint8_t                     irmp_protocol;
static volatile uint16_t                    irmp_address;
static volatile uint16_t                    irmp_command;
static volatile uint16_t                    irmp_id;                    // only used for SAMSUNG protocol
static volatile uint8_t                     irmp_flags;

#ifdef ANALYZE
static uint8_t                              IRMP_PIN;
#endif

/*---------------------------------------------------------------------------------------------------------------------------------------------------
 *  Initialize IRMP decoder
 *  @details  Configures IRMP input pin
 *---------------------------------------------------------------------------------------------------------------------------------------------------
 */
#ifndef ANALYZE
void
irmp_init (void)
{
#if !defined( PIC_CCS_COMPILER ) && !defined( IRMP_FLEXIBLE_VERSION )
    IRMP_PORT &= ~(1<<IRMP_BIT);                                        // deactivate pullup
    IRMP_DDR &= ~(1<<IRMP_BIT);                                         // set pin to input
#endif // PIC_CCS_COMPILER

#if IRMP_LOGGING == 1
    irmp_uart_init ();
#endif
}
#endif
/*---------------------------------------------------------------------------------------------------------------------------------------------------
 *  Get IRMP data
 *  @details  gets decoded IRMP data
 *  @param    pointer in order to store IRMP data
 *  @return    TRUE: successful, FALSE: failed
 *---------------------------------------------------------------------------------------------------------------------------------------------------
 */
uint8_t
irmp_get_data (IRMP_DATA * irmp_data_p)
{
    uint8_t   rtc = FALSE;

    if (irmp_ir_detected)
    {
        switch (irmp_protocol)
        {
#if IRMP_SUPPORT_SAMSUNG_PROTOCOL == 1
            case IRMP_SAMSUNG_PROTOCOL:
                if ((irmp_command >> 8) == (~irmp_command & 0x00FF))
                {
                    irmp_command &= 0xff;
                    irmp_command |= irmp_id << 8;
                    rtc = TRUE;
                }
                break;
#endif
#if IRMP_SUPPORT_NEC_PROTOCOL == 1
            case IRMP_NEC_PROTOCOL:
                if ((irmp_command >> 8) == (~irmp_command & 0x00FF))
                {
                    irmp_command &= 0xff;
                    rtc = TRUE;
                }
                else if (irmp_address == 0x87EE)
                {
                    ANALYZE_PRINTF ("Switching to APPLE protocol\n");
                    irmp_protocol = IRMP_APPLE_PROTOCOL;
                    irmp_address = (irmp_command & 0xFF00) >> 8;
                    irmp_command &= 0x00FF;
                    rtc = TRUE;
                }
                break;
#endif
#if IRMP_SUPPORT_SIEMENS_PROTOCOL == 1
            case IRMP_SIEMENS_PROTOCOL:
                if (((irmp_command >> 1) & 0x0001) == (~irmp_command & 0x0001))
                {
                    irmp_command >>= 1;
                    rtc = TRUE;
                }
                break;
#endif
#if IRMP_SUPPORT_RCCAR_PROTOCOL == 1
            case IRMP_RCCAR_PROTOCOL:
                // frame in irmp_data:
                // Bit 12 11 10 9  8  7  6  5  4  3  2  1  0
                //     V  D7 D6 D5 D4 D3 D2 D1 D0 A1 A0 C1 C0   //         10 9  8  7  6  5  4  3  2  1  0
                irmp_address = (irmp_command & 0x000C) >> 2;    // addr:   0  0  0  0  0  0  0  0  0  A1 A0
                irmp_command = ((irmp_command & 0x1000) >> 2) | // V-Bit:  V  0  0  0  0  0  0  0  0  0  0
                               ((irmp_command & 0x0003) << 8) | // C-Bits: 0  C1 C0 0  0  0  0  0  0  0  0
                               ((irmp_command & 0x0FF0) >> 4);  // D-Bits:          D7 D6 D5 D4 D3 D2 D1 D0
                rtc = TRUE;                                     // Summe:  V  C1 C0 D7 D6 D5 D4 D3 D2 D1 D0
                break;
#endif
            default:
                rtc = TRUE;
        }

        if (rtc)
        {
            irmp_data_p->protocol = irmp_protocol;
            irmp_data_p->address = irmp_address;
            irmp_data_p->command = irmp_command;
            irmp_data_p->flags   = irmp_flags;
            irmp_command = 0;
            irmp_address = 0;
            irmp_flags   = 0;
        }

        irmp_ir_detected = FALSE;
    }

    return rtc;
}

// these statics must not be volatile, because they are only used by irmp_store_bit(), which is called by irmp_ISR()
static uint16_t irmp_tmp_address;                                                       // ir address
static uint16_t irmp_tmp_command;                                                       // ir command

#if IRMP_SUPPORT_RC5_PROTOCOL == 1 && (IRMP_SUPPORT_FDC_PROTOCOL == 1 || IRMP_SUPPORT_RCCAR_PROTOCOL == 1)
static uint16_t irmp_tmp_address2;                                                      // ir address
static uint16_t irmp_tmp_command2;                                                      // ir command
#endif

#if IRMP_SUPPORT_SAMSUNG_PROTOCOL == 1
static uint16_t irmp_tmp_id;                                                            // ir id (only SAMSUNG)
#endif
#if IRMP_SUPPORT_KASEIKYO_PROTOCOL == 1
static uint8_t  xor_check[6];                                                           // check kaseikyo "parity" bits
#endif

static uint8_t  irmp_bit;                                                               // current bit position

/*---------------------------------------------------------------------------------------------------------------------------------------------------
 *  store bit
 *  @details  store bit in temp address or temp command
 *  @param    value to store: 0 or 1
 *---------------------------------------------------------------------------------------------------------------------------------------------------
 */
// verhindert, dass irmp_store_bit() inline compiliert wird:
// static void irmp_store_bit (uint8_t) __attribute__ ((noinline));

static void
irmp_store_bit (uint8_t value)
{

    if (irmp_bit >= irmp_param.address_offset && irmp_bit < irmp_param.address_end)
    {
        if (irmp_param.lsb_first)
        {
            irmp_tmp_address |= (((uint16_t) (value)) << (irmp_bit - irmp_param.address_offset));   // CV wants cast
        }
        else
        {
            irmp_tmp_address <<= 1;
            irmp_tmp_address |= value;
        }
    }
    else if (irmp_bit >= irmp_param.command_offset && irmp_bit < irmp_param.command_end)
    {
        if (irmp_param.lsb_first)
        {
            irmp_tmp_command |= (((uint16_t) (value)) << (irmp_bit - irmp_param.command_offset));   // CV wants cast
        }
        else
        {
            irmp_tmp_command <<= 1;
            irmp_tmp_command |= value;
        }
    }

#if IRMP_SUPPORT_SAMSUNG_PROTOCOL == 1
    else if (irmp_param.protocol == IRMP_SAMSUNG_PROTOCOL && irmp_bit >= SAMSUNG_ID_OFFSET && irmp_bit < SAMSUNG_ID_OFFSET + SAMSUNG_ID_LEN)
    {
        irmp_tmp_id |= (((uint16_t) (value)) << (irmp_bit - SAMSUNG_ID_OFFSET));                    // store with LSB first
    }
#endif

#if IRMP_SUPPORT_KASEIKYO_PROTOCOL == 1
    else if (irmp_param.protocol == IRMP_KASEIKYO_PROTOCOL && irmp_bit >= 20 && irmp_bit < 24)
    {
        irmp_tmp_command |= (((uint16_t) (value)) << (irmp_bit - 8));                   // store 4 system bits in upper nibble with LSB first
    }

    if (irmp_param.protocol == IRMP_KASEIKYO_PROTOCOL && irmp_bit < KASEIKYO_COMPLETE_DATA_LEN)
    {
        if (value)
        {
            xor_check[irmp_bit / 8] |= 1 << (irmp_bit % 8);
        }
        else
        {
            xor_check[irmp_bit / 8] &= ~(1 << (irmp_bit % 8));
        }
    }

#endif

    irmp_bit++;
}

/*---------------------------------------------------------------------------------------------------------------------------------------------------
 *  store bit
 *  @details  store bit in temp address or temp command
 *  @param    value to store: 0 or 1
 *---------------------------------------------------------------------------------------------------------------------------------------------------
 */
#if IRMP_SUPPORT_RC5_PROTOCOL == 1 && (IRMP_SUPPORT_FDC_PROTOCOL == 1 || IRMP_SUPPORT_RCCAR_PROTOCOL == 1)
static void
irmp_store_bit2 (uint8_t value)
{
    uint8_t irmp_bit2;

    if (irmp_param.protocol)
    {
        irmp_bit2 = irmp_bit - 2;
    }
    else
    {
        irmp_bit2 = irmp_bit - 1;
    }

    if (irmp_bit2 >= irmp_param2.address_offset && irmp_bit2 < irmp_param2.address_end)
    {
        irmp_tmp_address2 |= (((uint16_t) (value)) << (irmp_bit2 - irmp_param2.address_offset));   // CV wants cast
    }
    else if (irmp_bit2 >= irmp_param2.command_offset && irmp_bit2 < irmp_param2.command_end)
    {
        irmp_tmp_command2 |= (((uint16_t) (value)) << (irmp_bit2 - irmp_param2.command_offset));   // CV wants cast
    }
}
#endif // IRMP_SUPPORT_RC5_PROTOCOL == 1 && (IRMP_SUPPORT_FDC_PROTOCOL == 1 || IRMP_SUPPORT_RCCAR_PROTOCOL == 1)

/*---------------------------------------------------------------------------------------------------------------------------------------------------
 *  ISR routine
 *  @details  ISR routine, called 10000 times per second
 *---------------------------------------------------------------------------------------------------------------------------------------------------
 */

#ifdef IRMP_FLEXIBLE_VERSION
uint8_t
irmp_ISR ( uint8_t irmp_input )
#else
uint8_t
irmp_ISR (void)
#endif
{
    static uint8_t      irmp_start_bit_detected;                                // flag: start bit detected
    static uint8_t      wait_for_space;                                         // flag: wait for data bit space
    static uint8_t      wait_for_start_space;                                   // flag: wait for start bit space
    static uint8_t      irmp_pulse_time;                                        // count bit time for pulse
    static PAUSE_LEN    irmp_pause_time;                                        // count bit time for pause
    static uint16_t     last_irmp_address = 0xFFFF;                             // save last irmp address to recognize key repetition
    static uint16_t     last_irmp_command = 0xFFFF;                             // save last irmp command to recognize key repetition
    static uint16_t     repetition_len;                                         // SIRCS repeats frame 2-5 times with 45 ms pause
    static uint8_t      repetition_frame_number;
#if IRMP_SUPPORT_DENON_PROTOCOL == 1
    static uint16_t     last_irmp_denon_command;                                // save last irmp command to recognize DENON frame repetition
#endif
#if IRMP_SUPPORT_RC5_PROTOCOL == 1
    static uint8_t      rc5_cmd_bit6;                                           // bit 6 of RC5 command is the inverted 2nd start bit
#endif
#if IRMP_SUPPORT_MANCHESTER == 1
    static PAUSE_LEN    last_pause;                                             // last pause value
#endif
#if IRMP_SUPPORT_MANCHESTER == 1 || IRMP_SUPPORT_BANG_OLUFSEN_PROTOCOL == 1
    static uint8_t      last_value;                                             // last bit value
#endif
#ifndef IRMP_FLEXIBLE_VERSION
    uint8_t             irmp_input;                                             // input value
#endif

#ifdef ANALYZE
    time_counter++;
#endif


#ifndef IRMP_FLEXIBLE_VERSION
    irmp_input = input(IRMP_PIN);

    irmp_log(irmp_input);                                                       // log ir signal, if IRMP_LOGGING defined
#endif

    if (! irmp_ir_detected)                                                     // ir code already detected?
    {                                                                           // no...
        if (! irmp_start_bit_detected)                                          // start bit detected?
        {                                                                       // no...
            if (! irmp_input)                                                   // receiving burst?
            {                                                                   // yes...
#ifdef ANALYZE
                if (! irmp_pulse_time)
                {
                    ANALYZE_PRINTF("%8d [starting pulse]\n", time_counter);
                }
#endif
                irmp_pulse_time++;                                              // increment counter
            }
            else
            {                                                                   // no...
                if (irmp_pulse_time)                                            // it's dark....
                {                                                               // set flags for counting the time of darkness...
                    irmp_start_bit_detected = 1;
                    wait_for_start_space    = 1;
                    wait_for_space          = 0;
                    irmp_tmp_command        = 0;
                    irmp_tmp_address        = 0;

#if IRMP_SUPPORT_RC5_PROTOCOL == 1 && (IRMP_SUPPORT_FDC_PROTOCOL == 1 || IRMP_SUPPORT_RCCAR_PROTOCOL == 1)
                    irmp_tmp_command2       = 0;
                    irmp_tmp_address2       = 0;
#endif

                    irmp_bit                = 0xff;
                    irmp_pause_time         = 1;                                // 1st pause: set to 1, not to 0!
#if IRMP_SUPPORT_RC5_PROTOCOL == 1
                    rc5_cmd_bit6            = 0;                                // fm 2010-03-07: bugfix: reset it after incomplete RC5 frame!
#endif
                }
                else
                {
                    if (repetition_len < 0xFFFF)                                // avoid overflow of counter
                    {
                        repetition_len++;
                    }
                }
            }
        }
        else
        {
            if (wait_for_start_space)                                           // we have received start bit...
            {                                                                   // ...and are counting the time of darkness
                if (irmp_input)                                                 // still dark?
                {                                                               // yes
                    irmp_pause_time++;                                          // increment counter

#if IRMP_SUPPORT_NIKON_PROTOCOL == 1
                    if (((irmp_pulse_time < NIKON_START_BIT_PULSE_LEN_MIN || irmp_pulse_time > NIKON_START_BIT_PULSE_LEN_MAX) && irmp_pause_time > IRMP_TIMEOUT_LEN) ||
                         irmp_pause_time > IRMP_TIMEOUT_NIKON_LEN)
#else
                    if (irmp_pause_time > IRMP_TIMEOUT_LEN)                     // timeout?
#endif
                    {                                                           // yes...
#if IRMP_SUPPORT_JVC_PROTOCOL == 1
                        if (irmp_protocol == IRMP_JVC_PROTOCOL)                 // don't show eror if JVC protocol, irmp_pulse_time has been set below!
                        {
                            ;
                        }
                        else
#endif // IRMP_SUPPORT_JVC_PROTOCOL == 1
                        {
                            ANALYZE_PRINTF ("%8d error 1: pause after start bit pulse %d too long: %d\n", time_counter, irmp_pulse_time, irmp_pause_time);
                            ANALYZE_ONLY_NORMAL_PUTCHAR ('\n');
                        }
                        irmp_start_bit_detected = 0;                            // reset flags, let's wait for another start bit
                        irmp_pulse_time         = 0;
                        irmp_pause_time         = 0;
                    }
                }
                else
                {                                                               // receiving first data pulse!
                    IRMP_PARAMETER * irmp_param_p = (IRMP_PARAMETER *) 0;

#if IRMP_SUPPORT_RC5_PROTOCOL == 1 && (IRMP_SUPPORT_FDC_PROTOCOL == 1 || IRMP_SUPPORT_RCCAR_PROTOCOL == 1)
                    irmp_param2.protocol = 0;
#endif

                    ANALYZE_PRINTF ("%8d [start-bit: pulse = %2d, pause = %2d]\n", time_counter, irmp_pulse_time, irmp_pause_time);

#if IRMP_SUPPORT_SIRCS_PROTOCOL == 1
                    if (irmp_pulse_time >= SIRCS_START_BIT_PULSE_LEN_MIN && irmp_pulse_time <= SIRCS_START_BIT_PULSE_LEN_MAX &&
                        irmp_pause_time >= SIRCS_START_BIT_PAUSE_LEN_MIN && irmp_pause_time <= SIRCS_START_BIT_PAUSE_LEN_MAX)
                    {                                                           // it's SIRCS
                        ANALYZE_PRINTF ("protocol = SIRCS, start bit timings: pulse: %3d - %3d, pause: %3d - %3d\n",
                                        SIRCS_START_BIT_PULSE_LEN_MIN, SIRCS_START_BIT_PULSE_LEN_MAX,
                                        SIRCS_START_BIT_PAUSE_LEN_MIN, SIRCS_START_BIT_PAUSE_LEN_MAX);
                        irmp_param_p = (IRMP_PARAMETER *) (IRMP_PARAMETER *) &sircs_param;
                    }
                    else
#endif // IRMP_SUPPORT_SIRCS_PROTOCOL == 1

#if IRMP_SUPPORT_JVC_PROTOCOL == 1
                    if (irmp_protocol == IRMP_JVC_PROTOCOL &&                                                       // last protocol was JVC, awaiting repeat frame
                        irmp_pulse_time >= JVC_START_BIT_PULSE_LEN_MIN && irmp_pulse_time <= JVC_START_BIT_PULSE_LEN_MAX &&
                        irmp_pause_time >= JVC_REPEAT_START_BIT_PAUSE_LEN_MIN && irmp_pause_time <= JVC_REPEAT_START_BIT_PAUSE_LEN_MAX)
                    {
                        ANALYZE_PRINTF ("protocol = NEC or JVC repeat frame, start bit timings: pulse: %3d - %3d, pause: %3d - %3d\n",
                                        JVC_START_BIT_PULSE_LEN_MIN, JVC_START_BIT_PULSE_LEN_MAX,
                                        JVC_REPEAT_START_BIT_PAUSE_LEN_MIN, JVC_REPEAT_START_BIT_PAUSE_LEN_MAX);
                        irmp_param_p = (IRMP_PARAMETER *) &nec_param;                                               // tricky: use nec parameters
                    }
                    else
#endif // IRMP_SUPPORT_JVC_PROTOCOL == 1

#if IRMP_SUPPORT_NEC_PROTOCOL == 1
                    if (irmp_pulse_time >= NEC_START_BIT_PULSE_LEN_MIN && irmp_pulse_time <= NEC_START_BIT_PULSE_LEN_MAX &&
                        irmp_pause_time >= NEC_START_BIT_PAUSE_LEN_MIN && irmp_pause_time <= NEC_START_BIT_PAUSE_LEN_MAX)
                    {
                        ANALYZE_PRINTF ("protocol = NEC, start bit timings: pulse: %3d - %3d, pause: %3d - %3d\n",
                                        NEC_START_BIT_PULSE_LEN_MIN, NEC_START_BIT_PULSE_LEN_MAX,
                                        NEC_START_BIT_PAUSE_LEN_MIN, NEC_START_BIT_PAUSE_LEN_MAX);
                        irmp_param_p = (IRMP_PARAMETER *) &nec_param;
                    }
                    else if (irmp_pulse_time >= NEC_START_BIT_PULSE_LEN_MIN        && irmp_pulse_time <= NEC_START_BIT_PULSE_LEN_MAX &&
                             irmp_pause_time >= NEC_REPEAT_START_BIT_PAUSE_LEN_MIN && irmp_pause_time <= NEC_REPEAT_START_BIT_PAUSE_LEN_MAX)
                    {                                                           // it's NEC
                        ANALYZE_PRINTF ("protocol = NEC (repetition frame), start bit timings: pulse: %3d - %3d, pause: %3d - %3d\n",
                                        NEC_START_BIT_PULSE_LEN_MIN, NEC_START_BIT_PULSE_LEN_MAX,
                                        NEC_REPEAT_START_BIT_PAUSE_LEN_MIN, NEC_REPEAT_START_BIT_PAUSE_LEN_MAX);

                        irmp_param_p = (IRMP_PARAMETER *) &nec_rep_param;
                    }
                    else
#endif // IRMP_SUPPORT_NEC_PROTOCOL == 1

#if IRMP_SUPPORT_NIKON_PROTOCOL == 1
                    if (irmp_pulse_time >= NIKON_START_BIT_PULSE_LEN_MIN && irmp_pulse_time <= NIKON_START_BIT_PULSE_LEN_MAX &&
                        irmp_pause_time >= NIKON_START_BIT_PAUSE_LEN_MIN && irmp_pause_time <= NIKON_START_BIT_PAUSE_LEN_MAX)
                    {
                        ANALYZE_PRINTF ("protocol = NIKON, start bit timings: pulse: %3d - %3d, pause: %3d - %3d\n",
                                        NIKON_START_BIT_PULSE_LEN_MIN, NIKON_START_BIT_PULSE_LEN_MAX,
                                        NIKON_START_BIT_PAUSE_LEN_MIN, NIKON_START_BIT_PAUSE_LEN_MAX);
                        irmp_param_p = (IRMP_PARAMETER *) &nikon_param;
                    }
                    else
#endif // IRMP_SUPPORT_NIKON_PROTOCOL == 1

#if IRMP_SUPPORT_SAMSUNG_PROTOCOL == 1
                    if (irmp_pulse_time >= SAMSUNG_START_BIT_PULSE_LEN_MIN && irmp_pulse_time <= SAMSUNG_START_BIT_PULSE_LEN_MAX &&
                        irmp_pause_time >= SAMSUNG_START_BIT_PAUSE_LEN_MIN && irmp_pause_time <= SAMSUNG_START_BIT_PAUSE_LEN_MAX)
                    {                                                           // it's SAMSUNG
                        ANALYZE_PRINTF ("protocol = SAMSUNG, start bit timings: pulse: %3d - %3d, pause: %3d - %3d\n",
                                        SAMSUNG_START_BIT_PULSE_LEN_MIN, SAMSUNG_START_BIT_PULSE_LEN_MAX,
                                        SAMSUNG_START_BIT_PAUSE_LEN_MIN, SAMSUNG_START_BIT_PAUSE_LEN_MAX);
                        irmp_param_p = (IRMP_PARAMETER *) &samsung_param;
                    }
                    else
#endif // IRMP_SUPPORT_SAMSUNG_PROTOCOL == 1

#if IRMP_SUPPORT_MATSUSHITA_PROTOCOL == 1
                    if (irmp_pulse_time >= MATSUSHITA_START_BIT_PULSE_LEN_MIN && irmp_pulse_time <= MATSUSHITA_START_BIT_PULSE_LEN_MAX &&
                        irmp_pause_time >= MATSUSHITA_START_BIT_PAUSE_LEN_MIN && irmp_pause_time <= MATSUSHITA_START_BIT_PAUSE_LEN_MAX)
                    {                                                           // it's MATSUSHITA
                        ANALYZE_PRINTF ("protocol = MATSUSHITA, start bit timings: pulse: %3d - %3d, pause: %3d - %3d\n",
                                        MATSUSHITA_START_BIT_PULSE_LEN_MIN, MATSUSHITA_START_BIT_PULSE_LEN_MAX,
                                        MATSUSHITA_START_BIT_PAUSE_LEN_MIN, MATSUSHITA_START_BIT_PAUSE_LEN_MAX);
                        irmp_param_p = (IRMP_PARAMETER *) &matsushita_param;
                    }
                    else
#endif // IRMP_SUPPORT_MATSUSHITA_PROTOCOL == 1

#if IRMP_SUPPORT_KASEIKYO_PROTOCOL == 1
                    if (irmp_pulse_time >= KASEIKYO_START_BIT_PULSE_LEN_MIN && irmp_pulse_time <= KASEIKYO_START_BIT_PULSE_LEN_MAX &&
                        irmp_pause_time >= KASEIKYO_START_BIT_PAUSE_LEN_MIN && irmp_pause_time <= KASEIKYO_START_BIT_PAUSE_LEN_MAX)
                    {                                                           // it's KASEIKYO
                        ANALYZE_PRINTF ("protocol = KASEIKYO, start bit timings: pulse: %3d - %3d, pause: %3d - %3d\n",
                                        KASEIKYO_START_BIT_PULSE_LEN_MIN, KASEIKYO_START_BIT_PULSE_LEN_MAX,
                                        KASEIKYO_START_BIT_PAUSE_LEN_MIN, KASEIKYO_START_BIT_PAUSE_LEN_MAX);
                        irmp_param_p = (IRMP_PARAMETER *) &kaseikyo_param;
                    }
                    else
#endif // IRMP_SUPPORT_KASEIKYO_PROTOCOL == 1

#if IRMP_SUPPORT_RECS80_PROTOCOL == 1
                    if (irmp_pulse_time >= RECS80_START_BIT_PULSE_LEN_MIN && irmp_pulse_time <= RECS80_START_BIT_PULSE_LEN_MAX &&
                        irmp_pause_time >= RECS80_START_BIT_PAUSE_LEN_MIN && irmp_pause_time <= RECS80_START_BIT_PAUSE_LEN_MAX)
                    {                                                           // it's RECS80
                        ANALYZE_PRINTF ("protocol = RECS80, start bit timings: pulse: %3d - %3d, pause: %3d - %3d\n",
                                        RECS80_START_BIT_PULSE_LEN_MIN, RECS80_START_BIT_PULSE_LEN_MAX,
                                        RECS80_START_BIT_PAUSE_LEN_MIN, RECS80_START_BIT_PAUSE_LEN_MAX);
                        irmp_param_p = (IRMP_PARAMETER *) &recs80_param;
                    }
                    else
#endif // IRMP_SUPPORT_RECS80_PROTOCOL == 1

#if IRMP_SUPPORT_RC5_PROTOCOL == 1
                    if (((irmp_pulse_time >= RC5_START_BIT_LEN_MIN && irmp_pulse_time <= RC5_START_BIT_LEN_MAX) ||
                         (irmp_pulse_time >= 2 * RC5_START_BIT_LEN_MIN && irmp_pulse_time <= 2 * RC5_START_BIT_LEN_MAX)) &&
                        ((irmp_pause_time >= RC5_START_BIT_LEN_MIN && irmp_pause_time <= RC5_START_BIT_LEN_MAX) ||
                         (irmp_pause_time >= 2 * RC5_START_BIT_LEN_MIN && irmp_pause_time <= 2 * RC5_START_BIT_LEN_MAX)))
                    {                                                           // it's RC5
#if IRMP_SUPPORT_FDC_PROTOCOL == 1
                        if (irmp_pulse_time >= FDC_START_BIT_PULSE_LEN_MIN && irmp_pulse_time <= FDC_START_BIT_PULSE_LEN_MAX &&
                            irmp_pause_time >= FDC_START_BIT_PAUSE_LEN_MIN && irmp_pause_time <= FDC_START_BIT_PAUSE_LEN_MAX)
                        {
                            ANALYZE_PRINTF ("protocol = RC5 or FDC\n");
                            ANALYZE_PRINTF ("FDC start bit timings: pulse: %3d - %3d, pause: %3d - %3d\n",
                                            FDC_START_BIT_PULSE_LEN_MIN, FDC_START_BIT_PULSE_LEN_MAX,
                                            FDC_START_BIT_PAUSE_LEN_MIN, FDC_START_BIT_PAUSE_LEN_MAX);
                            ANALYZE_PRINTF ("RC5 start bit timings: pulse: %3d - %3d, pause: %3d - %3d\n",
                                            RC5_START_BIT_LEN_MIN, RC5_START_BIT_LEN_MAX,
                                            RC5_START_BIT_LEN_MIN, RC5_START_BIT_LEN_MAX);
                            memcpy_P (&irmp_param2, &fdc_param, sizeof (IRMP_PARAMETER));
                        }
                        else
#endif // IRMP_SUPPORT_FDC_PROTOCOL == 1
#if IRMP_SUPPORT_RCCAR_PROTOCOL == 1
                        if (irmp_pulse_time >= RCCAR_START_BIT_PULSE_LEN_MIN && irmp_pulse_time <= RCCAR_START_BIT_PULSE_LEN_MAX &&
                            irmp_pause_time >= RCCAR_START_BIT_PAUSE_LEN_MIN && irmp_pause_time <= RCCAR_START_BIT_PAUSE_LEN_MAX)
                        {
                            ANALYZE_PRINTF ("protocol = RC5 or RCCAR\n");
                            ANALYZE_PRINTF ("RCCAR start bit timings: pulse: %3d - %3d, pause: %3d - %3d\n",
                                            RCCAR_START_BIT_PULSE_LEN_MIN, RCCAR_START_BIT_PULSE_LEN_MAX,
                                            RCCAR_START_BIT_PAUSE_LEN_MIN, RCCAR_START_BIT_PAUSE_LEN_MAX);
                            ANALYZE_PRINTF ("RC5 start bit timings: pulse: %3d - %3d, pause: %3d - %3d\n",
                                            RC5_START_BIT_LEN_MIN, RC5_START_BIT_LEN_MAX,
                                            RC5_START_BIT_LEN_MIN, RC5_START_BIT_LEN_MAX);
                            memcpy_P (&irmp_param2, &rccar_param, sizeof (IRMP_PARAMETER));
                        }
                        else
#endif // IRMP_SUPPORT_RCCAR_PROTOCOL == 1
                        {
                            ANALYZE_PRINTF ("protocol = RC5, start bit timings: pulse: %3d - %3d, pause: %3d - %3d\n",
                                            RC5_START_BIT_LEN_MIN, RC5_START_BIT_LEN_MAX,
                                            RC5_START_BIT_LEN_MIN, RC5_START_BIT_LEN_MAX);
                        }

                        irmp_param_p = (IRMP_PARAMETER *) &rc5_param;
                        last_pause = irmp_pause_time;

                        if ((irmp_pulse_time > RC5_START_BIT_LEN_MAX && irmp_pulse_time <= 2 * RC5_START_BIT_LEN_MAX) ||
                            (irmp_pause_time > RC5_START_BIT_LEN_MAX && irmp_pause_time <= 2 * RC5_START_BIT_LEN_MAX))
                        {
                          last_value  = 0;
                          rc5_cmd_bit6 = 1<<6;
                        }
                        else
                        {
                          last_value  = 1;
                        }
                    }
                    else
#endif // IRMP_SUPPORT_RC5_PROTOCOL == 1

#if IRMP_SUPPORT_DENON_PROTOCOL == 1
                    if ( (irmp_pulse_time >= DENON_PULSE_LEN_MIN && irmp_pulse_time <= DENON_PULSE_LEN_MAX) &&
                        ((irmp_pause_time >= DENON_1_PAUSE_LEN_MIN && irmp_pause_time <= DENON_1_PAUSE_LEN_MAX) ||
                         (irmp_pause_time >= DENON_0_PAUSE_LEN_MIN && irmp_pause_time <= DENON_0_PAUSE_LEN_MAX)))
                    {                                                           // it's DENON
                        ANALYZE_PRINTF ("protocol = DENON, start bit timings: pulse: %3d - %3d, pause: %3d - %3d or %3d - %3d\n",
                                        DENON_PULSE_LEN_MIN, DENON_PULSE_LEN_MAX,
                                        DENON_1_PAUSE_LEN_MIN, DENON_1_PAUSE_LEN_MAX,
                                        DENON_0_PAUSE_LEN_MIN, DENON_0_PAUSE_LEN_MAX);
                        irmp_param_p = (IRMP_PARAMETER *) &denon_param;
                    }
                    else
#endif // IRMP_SUPPORT_DENON_PROTOCOL == 1
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
