Jinzuu/wc_ws/sonstige_lib/stm32_ub_pwm_tim3.c

//--------------------------------------------------------------
// File     : stm32_ub_pwm_tim3.c
// Datum    : 26.03.2013
// Version  : 1.0
// Autor    : UB
// EMail    : mc-4u(@)t-online.de
// Web      : www.mikrocontroller-4u.de
// CPU      : STM32F4
// IDE      : CooCox CoIDE 1.7.0
// Module   : GPIO, TIM
// Funktion : PWM-Funktionen per Timer3
//
// Hinweis  : mögliche Pinbelegungen
//            CH1 : [PA6, PB4, PC6]
//            CH2 : [PA7, PB5, PC7]
//            CH3 : [PB0, PC8]
//            CH4 : [PB1, PC9]
//--------------------------------------------------------------


//--------------------------------------------------------------
// Includes
//--------------------------------------------------------------
#include "stm32_ub_pwm_tim3.h"



//--------------------------------------------------------------
// interne Funktionen
//--------------------------------------------------------------
void P_PWM_InitIO_TIM3(void);
void P_PWM_InitTIM3(void);


//--------------------------------------------------------------
// Definition aller PWM Pins
// Reihenfolge wie bei PWM_TIM3_NAME_t
//
// Channel : [1...4]
// Init = Startwert : [0...PWM_TIM3_PERIODE]
//--------------------------------------------------------------
PWM_TIM3_t PWM_TIM3[] = {
  // Name     ,Channel, PORT , PIN       , CLOCK               , Source         , Init
  {PWM_T3_PC6 ,1      ,GPIOC ,GPIO_Pin_6 ,RCC_AHB1Periph_GPIOC ,GPIO_PinSource6 ,  64},
  {PWM_T3_PB5 ,2      ,GPIOB ,GPIO_Pin_5 ,RCC_AHB1Periph_GPIOB ,GPIO_PinSource5 ,  128},
};



//--------------------------------------------------------------
// init und start vom PWM mit Timer3
//-------------------------------------------------------------- 
void UB_PWM_TIM3_Init(void)
{
  P_PWM_InitIO_TIM3();
  P_PWM_InitTIM3();
}


//--------------------------------------------------------------
// stellt einen PWM-Wert für einen Kanal ein 
// wert : [0 bis PWM_TIM3_PERIODE]
//--------------------------------------------------------------
void UB_PWM_TIM3_SetPWM(PWM_TIM3_NAME_t pwm, uint16_t wert)
{
  if(wert>PWM_TIM3_PERIODE) wert=PWM_TIM3_PERIODE;

  if(PWM_TIM3[pwm].CHANNEL==1) {
    TIM3->CCR1 = wert;
  } 
  if(PWM_TIM3[pwm].CHANNEL==2) {
    TIM3->CCR2 = wert;
  } 
  if(PWM_TIM3[pwm].CHANNEL==3) {
    TIM3->CCR3 = wert;
  } 
  if(PWM_TIM3[pwm].CHANNEL==4) {
    TIM3->CCR4 = wert;
  } 
}


//--------------------------------------------------------------
// interne Funktion
// Init aller IO-Pins
//--------------------------------------------------------------
void P_PWM_InitIO_TIM3(void)
{
  GPIO_InitTypeDef GPIO_InitStructure;
  PWM_TIM3_NAME_t pwm_name;

  for(pwm_name=0;pwm_name<PWM_TIM3_ANZ;pwm_name++) {
    // Clock Enable
    RCC_AHB1PeriphClockCmd(PWM_TIM3[pwm_name].PWM_CLK, ENABLE);

    // Config des Pins als Digital-Ausgang
    GPIO_InitStructure.GPIO_Pin = PWM_TIM3[pwm_name].PWM_PIN;
    GPIO_InitStructure.GPIO_Mode = GPIO_Mode_AF;
    GPIO_InitStructure.GPIO_Speed = GPIO_Speed_100MHz;
    GPIO_InitStructure.GPIO_OType = GPIO_OType_PP;
    GPIO_InitStructure.GPIO_PuPd = GPIO_PuPd_UP ;
    GPIO_Init(PWM_TIM3[pwm_name].PWM_PORT, &GPIO_InitStructure);

    // Alternative-Funktion mit dem IO-Pin verbinden
    GPIO_PinAFConfig(PWM_TIM3[pwm_name].PWM_PORT, PWM_TIM3[pwm_name].PWM_SOURCE, GPIO_AF_TIM3);
  }  
}


//--------------------------------------------------------------
// interne Funktion
// Init vom Timer
//--------------------------------------------------------------
void P_PWM_InitTIM3(void)
{
  TIM_TimeBaseInitTypeDef  TIM_TimeBaseStructure;
  TIM_OCInitTypeDef  TIM_OCInitStructure;
  PWM_TIM3_NAME_t pwm_name;
  uint16_t wert;

  // Clock enable
  RCC_APB1PeriphClockCmd(RCC_APB1Periph_TIM3, ENABLE); 

  // Timer init
  TIM_TimeBaseStructure.TIM_Period = PWM_TIM3_PERIODE;
  TIM_TimeBaseStructure.TIM_Prescaler = PWM_TIM3_PRESCALE;
  TIM_TimeBaseStructure.TIM_ClockDivision = TIM_CKD_DIV1;
  TIM_TimeBaseStructure.TIM_CounterMode = TIM_CounterMode_Up;
  TIM_TimeBaseInit(TIM3, &TIM_TimeBaseStructure);


  for(pwm_name=0;pwm_name<PWM_TIM3_ANZ;pwm_name++) {
    if(PWM_TIM3[pwm_name].CHANNEL==1) {
      // Channel 1
      TIM_OCInitStructure.TIM_OCMode = TIM_OCMode_PWM1;
      TIM_OCInitStructure.TIM_OutputState = TIM_OutputState_Enable;
      wert=PWM_TIM3[pwm_name].PWM_INIT;
      if(wert>PWM_TIM3_PERIODE) wert=PWM_TIM3_PERIODE;
      TIM_OCInitStructure.TIM_Pulse = wert;
      TIM_OCInitStructure.TIM_OCPolarity = PWM_TIM3_POLARITY;
      TIM_OC1Init(TIM3, &TIM_OCInitStructure);
      TIM_OC1PreloadConfig(TIM3, TIM_OCPreload_Enable);
    }
    if(PWM_TIM3[pwm_name].CHANNEL==2) {
      // Channel 2
      TIM_OCInitStructure.TIM_OCMode = TIM_OCMode_PWM1;
      TIM_OCInitStructure.TIM_OutputState = TIM_OutputState_Enable;
      wert=PWM_TIM3[pwm_name].PWM_INIT;
      if(wert>PWM_TIM3_PERIODE) wert=PWM_TIM3_PERIODE;
      TIM_OCInitStructure.TIM_Pulse = wert;
      TIM_OCInitStructure.TIM_OCPolarity = PWM_TIM3_POLARITY;
      TIM_OC2Init(TIM3, &TIM_OCInitStructure);
      TIM_OC2PreloadConfig(TIM3, TIM_OCPreload_Enable);
    }
    if(PWM_TIM3[pwm_name].CHANNEL==3) {
      // Channel 3
      TIM_OCInitStructure.TIM_OCMode = TIM_OCMode_PWM1;
      TIM_OCInitStructure.TIM_OutputState = TIM_OutputState_Enable;
      wert=PWM_TIM3[pwm_name].PWM_INIT;
      if(wert>PWM_TIM3_PERIODE) wert=PWM_TIM3_PERIODE;
      TIM_OCInitStructure.TIM_Pulse = wert;
      TIM_OCInitStructure.TIM_OCPolarity = PWM_TIM3_POLARITY;
      TIM_OC3Init(TIM3, &TIM_OCInitStructure);
      TIM_OC3PreloadConfig(TIM3, TIM_OCPreload_Enable);
    }
    if(PWM_TIM3[pwm_name].CHANNEL==4) {
      // Channel 4
      TIM_OCInitStructure.TIM_OCMode = TIM_OCMode_PWM1;
      TIM_OCInitStructure.TIM_OutputState = TIM_OutputState_Enable;
      wert=PWM_TIM3[pwm_name].PWM_INIT;
      if(wert>PWM_TIM3_PERIODE) wert=PWM_TIM3_PERIODE;
      TIM_OCInitStructure.TIM_Pulse = wert;
      TIM_OCInitStructure.TIM_OCPolarity = PWM_TIM3_POLARITY;
      TIM_OC4Init(TIM3, &TIM_OCInitStructure);
      TIM_OC4PreloadConfig(TIM3, TIM_OCPreload_Enable);
    }
  }

  // Timer enable
  TIM_ARRPreloadConfig(TIM3, ENABLE);
  TIM_Cmd(TIM3, ENABLE);
}
