Jinzuu/wc_ws/ub_lib/stm32_ub_uart.c

//--------------------------------------------------------------
// File     : stm32_ub_uart.c
// Datum    : 29.03.2013
// Version  : 1.2
// Autor    : UB
// EMail    : mc-4u(@)t-online.de
// Web      : www.mikrocontroller-4u.de
// CPU      : STM32F4
// IDE      : CooCox CoIDE 1.7.0
// Module   : GPIO, USART, MISC
// Funktion : UART (RS232) In und OUT
//            Receive wird per Interrupt behandelt
//
// Hinweis  : mögliche Pinbelegungen
//            UART1 : TX:[PA9,PB6] RX:[PA10,PB7]
//            UART2 : TX:[PA2,PD5] RX:[PA3,PD6]
//            UART3 : TX:[PB10,PC10,PD8] RX:[PB11,PC11,PD9]
//            UART4 : TX:[PA0,PC10] RX:[PA1,PC11]
//            UART5 : TX:[PC12] RX:[PD2]
//            UART6 : TX:[PC6,PG14] RX:[PC7,PG9]
//
// Vorsicht : Als Endekennung beim Empfangen, muss der Sender
//            das Zeichen "0x0D" = Carriage-Return
//            an den String anhängen !!
//--------------------------------------------------------------


//--------------------------------------------------------------
// Includes
//--------------------------------------------------------------
#include "stm32_ub_uart.h"

Stm32_CircularBuffer esp_rx_circ_buffer;
char esp_rx_raw_buffer[1000] = {0};


//--------------------------------------------------------------
// Definition aller UARTs
// Reihenfolge wie bei UART_NAME_t
//--------------------------------------------------------------
UART_t UART[] = {
// Name, Clock               , AF-UART      ,UART  , Baud , Interrupt
  {COM2,RCC_APB1Periph_USART2,GPIO_AF_USART2,USART2,115200,USART2_IRQn, // UART2 mit 115200 Baud
// PORT , PIN      , Clock              , Source
  {GPIOA,GPIO_Pin_2,RCC_AHB1Periph_GPIOA,GPIO_PinSource2},  // TX an PA2
  {GPIOA,GPIO_Pin_3,RCC_AHB1Periph_GPIOA,GPIO_PinSource3}}, // RX an PA3
};





//--------------------------------------------------------------
// init aller UARTs
//--------------------------------------------------------------
void UB_Uart_Init(void)
{
  GPIO_InitTypeDef GPIO_InitStructure;
  USART_InitTypeDef USART_InitStructure;
  NVIC_InitTypeDef NVIC_InitStructure;
  UART_NAME_t nr;

  for(nr=0;nr<UART_ANZ;nr++) {

    // Clock enable der TX und RX Pins
    RCC_AHB1PeriphClockCmd(UART[nr].TX.CLK, ENABLE);
    RCC_AHB1PeriphClockCmd(UART[nr].RX.CLK, ENABLE);

    // Clock enable der UART
    if((UART[nr].UART==USART1) || (UART[nr].UART==USART6)) {
      RCC_APB2PeriphClockCmd(UART[nr].CLK, ENABLE);
    }
    else {
      RCC_APB1PeriphClockCmd(UART[nr].CLK, ENABLE);
    }

    // UART Alternative-Funktions mit den IO-Pins verbinden
    GPIO_PinAFConfig(UART[nr].TX.PORT,UART[nr].TX.SOURCE,UART[nr].AF);
    GPIO_PinAFConfig(UART[nr].RX.PORT,UART[nr].RX.SOURCE,UART[nr].AF);

    // UART als Alternative-Funktion mit PushPull
    GPIO_InitStructure.GPIO_Mode = GPIO_Mode_AF;
    GPIO_InitStructure.GPIO_Speed = GPIO_Speed_100MHz;
    GPIO_InitStructure.GPIO_OType = GPIO_OType_PP;
    GPIO_InitStructure.GPIO_PuPd = GPIO_PuPd_UP;
    // TX-Pin
    GPIO_InitStructure.GPIO_Pin = UART[nr].TX.PIN;
    GPIO_Init(UART[nr].TX.PORT, &GPIO_InitStructure);
    // RX-Pin
    GPIO_InitStructure.GPIO_Pin =  UART[nr].RX.PIN;
    GPIO_Init(UART[nr].RX.PORT, &GPIO_InitStructure);

    // Oversampling
    USART_OverSampling8Cmd(UART[nr].UART, ENABLE);

    // init mit Baudrate, 8Databits, 1Stopbit, keine Parität, kein RTS+CTS
    USART_InitStructure.USART_BaudRate = UART[nr].BAUD;
    USART_InitStructure.USART_WordLength = USART_WordLength_8b;
    USART_InitStructure.USART_StopBits = USART_StopBits_1;
    USART_InitStructure.USART_Parity = USART_Parity_No;
    USART_InitStructure.USART_HardwareFlowControl = USART_HardwareFlowControl_None;
    USART_InitStructure.USART_Mode = USART_Mode_Rx | USART_Mode_Tx;
    USART_Init(UART[nr].UART, &USART_InitStructure);

    // UART enable
    USART_Cmd(UART[nr].UART, ENABLE);

    // RX-Interrupt enable
    USART_ITConfig(UART[nr].UART, USART_IT_RXNE, ENABLE);

    // enable UART Interrupt-Vector
    NVIC_InitStructure.NVIC_IRQChannel = UART[nr].INT;
    NVIC_InitStructure.NVIC_IRQChannelPreemptionPriority = 0;
    NVIC_InitStructure.NVIC_IRQChannelSubPriority = 0;
    NVIC_InitStructure.NVIC_IRQChannelCmd = ENABLE;
    NVIC_Init(&NVIC_InitStructure);

    // RX-Puffer vorbereiten
    UART_RX[nr].rx_buffer[0]=RX_END_CHR;
    UART_RX[nr].wr_ptr=0;
    UART_RX[nr].status=RX_EMPTY;

    // Circular-Buffer vorbereiten
    CircularBuffer_Init(&(UART_RX[nr].rx_circ_buffer), RX_CIRCBUF_SIZE, UART_RX[nr].rx_raw_buffer);
  }
}

//--------------------------------------------------------------
// ein Byte per UART senden
//--------------------------------------------------------------
void UB_Uart_SendByte(UART_NAME_t uart, uint16_t wert)
{
  // warten bis altes Byte gesendet wurde
  while (USART_GetFlagStatus(UART[uart].UART, USART_FLAG_TXE) == RESET);
  USART_SendData(UART[uart].UART, wert);
}

//--------------------------------------------------------------
// einen String per UART senden
//--------------------------------------------------------------
void UB_Uart_SendString(UART_NAME_t uart, char *ptr, UART_LASTBYTE_t end_cmd)
{
  // sende kompletten String
  while (*ptr != 0) {
    UB_Uart_SendByte(uart,*ptr);
    ptr++;
  }
  // eventuell Endekennung senden
  if(end_cmd==LFCR) {
    UB_Uart_SendByte(uart,0x0A); // LineFeed senden
    UB_Uart_SendByte(uart,0x0D); // CariageReturn senden
  }
  else if(end_cmd==CRLF) {    
    UB_Uart_SendByte(uart,0x0D); // CariageReturn senden
    UB_Uart_SendByte(uart,0x0A); // LineFeed senden
  }
  else if(end_cmd==LF) {    
    UB_Uart_SendByte(uart,0x0A); // LineFeed senden
  }
  else if(end_cmd==CR) {    
    UB_Uart_SendByte(uart,0x0D); // CariageReturn senden    
  }
}

//--------------------------------------------------------------
// einen String per UART empfangen
// (der Empfang wird per Interrupt abgehandelt)
// diese Funktion muss zyklisch gepollt werden
// Return Wert :
//  -> wenn nichts empfangen = RX_EMPTY
//  -> wenn String empfangen = RX_READY -> String steht in *ptr
//  -> wenn Puffer voll      = RX_FULL
//--------------------------------------------------------------
UART_RXSTATUS_t UB_Uart_ReceiveString(UART_NAME_t uart, char *ptr)
{
  UART_RXSTATUS_t ret_wert=RX_EMPTY;
  uint8_t n,wert;

  if(UART_RX[uart].status==RX_READY) {
    ret_wert=RX_READY;
    // Puffer kopieren
    n=0;
    do {
      wert=UART_RX[uart].rx_buffer[n];
      if(wert!=RX_END_CHR) {
        ptr[n]=wert;
        n++;
      }
    }while(wert!=RX_END_CHR);
    // Stringendekennung
    ptr[n]=0x00;
    // RX-Puffer löschen
    UART_RX[uart].rx_buffer[0]=RX_END_CHR;
    UART_RX[uart].wr_ptr=0;
    UART_RX[uart].status=RX_EMPTY;
  }
  else if(UART_RX[uart].status==RX_FULL) {
    ret_wert=RX_FULL;
    // RX-Puffer löschen
    UART_RX[uart].rx_buffer[0]=RX_END_CHR;
    UART_RX[uart].wr_ptr=0;
    UART_RX[uart].status=RX_EMPTY;
  }

  return(ret_wert);
}

//--------------------------------------------------------------
// den RX-Puffer eines UARTs auslesen
//--------------------------------------------------------------
int UB_Uart_ReadRxBuffer(UART_NAME_t uart, char *ptr, int max_length)
{
	return CircularBuffer_Read(&(UART_RX[uart].rx_circ_buffer), ptr, max_length);
}

int UB_Uart_GetRXSize(UART_NAME_t uart)
{
	return CircularBuffer_GetPopulation(&(UART_RX[uart].rx_circ_buffer));
}

int UB_Uart_ReadLine(UART_NAME_t uart, char* line, int length)
{
	int iLengthOfLine = 0;
	//do {
		iLengthOfLine = CircularBuffer_SearchString(&(UART_RX[uart].rx_circ_buffer), "\r\n");
	//}while( iLengthOfLine == -1 );

	if( iLengthOfLine == -1 ) {
		return -1;
	}

	//iLengthOfLine = iLengthOfLine + 2;

	// string is longer than given string memory
	if( iLengthOfLine > length ) {
		iLengthOfLine = length;
		return -1;
	}

	CircularBuffer_Read(&(UART_RX[uart].rx_circ_buffer), line, iLengthOfLine);
	return iLengthOfLine;
}

int UB_Uart_Is_Full_Line_Received(UART_NAME_t uart)
{
	int iLengthOfLine = 0;
	iLengthOfLine = CircularBuffer_SearchString(&(UART_RX[uart].rx_circ_buffer), "\r\n");
	return (iLengthOfLine != -1);
}

//--------------------------------------------------------------
// interne Funktion
// speichern des empfangenen Zeichens im Puffer
//--------------------------------------------------------------
int iCounter = 0;
void P_UART_Receive(UART_NAME_t uart, uint16_t wert)
{
	++iCounter;
	CircularBuffer_Store(&(UART_RX[uart].rx_circ_buffer), (char*)&wert, 1);

  if(UART_RX[uart].wr_ptr<RX_BUF_SIZE) {
    // wenn noch Platz im Puffer
    if(UART_RX[uart].status==RX_EMPTY) {
      // wenn noch keine Endekennung empfangen wurde
      if((wert>=RX_FIRST_CHR) && (wert<=RX_LAST_CHR)) {
        // Byte im Puffer speichern
        UART_RX[uart].rx_buffer[UART_RX[uart].wr_ptr]=wert;
        UART_RX[uart].wr_ptr++;
      }

      if(wert==RX_END_CHR) {
        // wenn Endekennung empfangen
        UART_RX[uart].rx_buffer[UART_RX[uart].wr_ptr]=wert;
        UART_RX[uart].status=RX_READY;
      }
    }
  }
  else {
    // wenn Puffer voll ist
    UART_RX[uart].status=RX_FULL;
  }
}


//--------------------------------------------------------------
// interne Funktion
// UART-Interrupt-Funktion
// Interrupt-Nr muss übergeben werden
//--------------------------------------------------------------
void P_UART_RX_INT(uint8_t int_nr, uint16_t wert)
{
  UART_NAME_t nr;

  // den passenden Eintrag suchen
  for(nr=0;nr<UART_ANZ;nr++) {
    if(UART[nr].INT==int_nr) {
      // eintrag gefunden, Byte speichern
      P_UART_Receive(nr,wert);
      break;
    }
  }
}


//--------------------------------------------------------------
// UART1-Interrupt
//--------------------------------------------------------------
void USART1_IRQHandler(void) {
  uint16_t wert;

  if (USART_GetITStatus(USART1, USART_IT_RXNE) == SET) {
    // wenn ein Byte im Empfangspuffer steht
    wert=USART_ReceiveData(USART1);
    // Byte speichern
    P_UART_RX_INT(USART1_IRQn,wert);
  }
}

//--------------------------------------------------------------
// UART2-Interrupt
//--------------------------------------------------------------
void USART2_IRQHandler(void) {
  uint16_t wert;

  if (USART_GetITStatus(USART2, USART_IT_RXNE) == SET) {
    // wenn ein Byte im Empfangspuffer steht
    wert=USART_ReceiveData(USART2);
    // Byte speichern
    P_UART_RX_INT(USART2_IRQn,wert);
  }
}


//--------------------------------------------------------------
// UART3-Interrupt
//--------------------------------------------------------------
void USART3_IRQHandler(void) {
  uint16_t wert;

  if (USART_GetITStatus(USART3, USART_IT_RXNE) == SET) {
    // wenn ein Byte im Empfangspuffer steht
    wert=USART_ReceiveData(USART3);
    // Byte speichern
    P_UART_RX_INT(USART3_IRQn,wert);
  }
}

//--------------------------------------------------------------
// UART4-Interrupt
//--------------------------------------------------------------
void USART4_IRQHandler(void) {
  uint16_t wert;

  if (USART_GetITStatus(UART4, USART_IT_RXNE) == SET) {
    // wenn ein Byte im Empfangspuffer steht
    wert=USART_ReceiveData(UART4);
    // Byte speichern
    P_UART_RX_INT(UART4_IRQn,wert);
  }
}

//--------------------------------------------------------------
// UART5-Interrupt
//--------------------------------------------------------------
void USART5_IRQHandler(void) {
  uint16_t wert;

  if (USART_GetITStatus(UART5, USART_IT_RXNE) == SET) {
    // wenn ein Byte im Empfangspuffer steht
    wert=USART_ReceiveData(UART5);
    // Byte speichern
    P_UART_RX_INT(UART5_IRQn,wert);
  }
}

//--------------------------------------------------------------
// UART6-Interrupt
//--------------------------------------------------------------
void USART6_IRQHandler(void) {
  uint16_t wert;

  if (USART_GetITStatus(USART6, USART_IT_RXNE) == SET) {
    // wenn ein Byte im Empfangspuffer steht
    wert=USART_ReceiveData(USART6);
    // Byte speichern
    P_UART_RX_INT(USART6_IRQn,wert);
  }
}
