Jinzuu/wc_ws/ub_lib/stm32_ub_dig_out.c

//--------------------------------------------------------------
// File     : stm32_ub_dig_out.c
// Datum    : 01.02.2013
// Version  : 1.2
// Autor    : UB
// EMail    : mc-4u(@)t-online.de
// Web      : www.mikrocontroller-4u.de
// CPU      : STM32F4
// IDE      : CooCox CoIDE 1.7.0
// Module   : GPIO
// Funktion : Digital_Out Funktionen
//--------------------------------------------------------------

//--------------------------------------------------------------
// Includes
//--------------------------------------------------------------
#include "stm32_ub_dig_out.h"


//--------------------------------------------------------------
// Definition aller Digital-Out Pins
// Reihenfolge wie bei DOUT_NAME_t
//
// Init : [Bit_SET,Bit_RESET]
//--------------------------------------------------------------
DOUT_PIN_t DOUT_PIN[] = {
  // Name    ,PORT , PIN       , CLOCK              , Init
  {DOUT_PB9 ,GPIOB,GPIO_Pin_9 ,RCC_AHB1Periph_GPIOB,Bit_RESET},
  {DOUT_PB7 ,GPIOB,GPIO_Pin_7 ,RCC_AHB1Periph_GPIOB,Bit_RESET},
  {DOUT_PB5 ,GPIOB,GPIO_Pin_5 ,RCC_AHB1Periph_GPIOB,Bit_RESET},
  {DOUT_PB3 ,GPIOB,GPIO_Pin_3 ,RCC_AHB1Periph_GPIOB,Bit_RESET},
  {DOUT_PB4 ,GPIOB,GPIO_Pin_4 ,RCC_AHB1Periph_GPIOB,Bit_RESET},
  {DOUT_PA10 ,GPIOB,GPIO_Pin_10 ,RCC_AHB1Periph_GPIOA,Bit_RESET},
};



//--------------------------------------------------------------
// Init aller Digital-Out Pins
//--------------------------------------------------------------
void UB_DigOut_Init(void)
{
  GPIO_InitTypeDef  GPIO_InitStructure;
  DOUT_NAME_t dig_pin;
  
  for(dig_pin=0;dig_pin<DOUT_ANZ;dig_pin++) {
    // Clock Enable
    RCC_AHB1PeriphClockCmd(DOUT_PIN[dig_pin].GPIO_CLK, ENABLE);

    // Config als Digital-Ausgang
    GPIO_InitStructure.GPIO_Pin = DOUT_PIN[dig_pin].GPIO_PIN;
    GPIO_InitStructure.GPIO_Mode = GPIO_Mode_OUT;
    GPIO_InitStructure.GPIO_OType = GPIO_OType_PP;
    GPIO_InitStructure.GPIO_PuPd = GPIO_PuPd_UP;
    GPIO_InitStructure.GPIO_Speed = GPIO_Speed_50MHz;
    GPIO_Init(DOUT_PIN[dig_pin].GPIO_PORT, &GPIO_InitStructure);

    // Default Wert einstellen
    if(DOUT_PIN[dig_pin].GPIO_INIT==Bit_RESET) {
    	 UB_DigOut_Lo(dig_pin);
    }
    else {
    	UB_DigOut_Hi(dig_pin);
    }
  }
}


//--------------------------------------------------------------
// Digital-Out Pin auf Lo-Pegel setzen
//--------------------------------------------------------------
void UB_DigOut_Lo(DOUT_NAME_t dig_pin)
{
  DOUT_PIN[dig_pin].GPIO_PORT->BSRRH = DOUT_PIN[dig_pin].GPIO_PIN;
}

//--------------------------------------------------------------
// Digital-Out Pin auf Hi-Pegel setzen
//--------------------------------------------------------------
void UB_DigOut_Hi(DOUT_NAME_t dig_pin)
{
  DOUT_PIN[dig_pin].GPIO_PORT->BSRRL = DOUT_PIN[dig_pin].GPIO_PIN;
} 

//--------------------------------------------------------------
// Digital-Out Pin Pegel toggeln
//--------------------------------------------------------------
void UB_DigOut_Toggle(DOUT_NAME_t dig_pin)
{
  DOUT_PIN[dig_pin].GPIO_PORT->ODR ^= DOUT_PIN[dig_pin].GPIO_PIN;
}

//--------------------------------------------------------------
// Digital-Out Pin auf Lo oder Hi setzen
//--------------------------------------------------------------
void UB_DigOut_Pin(DOUT_NAME_t dig_pin,BitAction wert)
{
  if(wert==Bit_RESET) {
    UB_DigOut_Lo(dig_pin);
  }
  else {
    UB_DigOut_Hi(dig_pin);
  }
}
