Jinzuu/wc_ws/wc_IrRemoteProcessing.c

#include "wc_IrRemoteProcessing.h"
#include "wc_LightDependentBrightness.h"
#include "ub_lib/stm32_ub_rtc.h"

/*****************************************
 *  GLOBALS
 *****************************************/
int irAddressFirstSeen = -1;	// Used to take only cmds from this address (-1 = not set yet)
WS2812_HSV_t gCurrentMatrixColor = {0,  0, 100};

//####################################################################################################
//################################## FUNCTIONS IMPLEMENTATION ########################################
//####################################################################################################
// Function that uses a received IR command to do stuff
void ProcessIrDataPacket( IRMP_DATA irPacket ){
	// Process packet only if it came from the right remote
	if ( irAddressFirstSeen == -1 )
		irAddressFirstSeen = irPacket.address;
	else if ( irAddressFirstSeen != irPacket.address )
		return;

	switch ( irPacket.command )
	{
		// Commands
		case IR_REMOTE_KEY_BRIGHTNESS_INC:
			AdjustBrightnessArray( 1, ambientBrightnessCurrent, ambientBrightnessLedDimmingFactors );
			break;
		case IR_REMOTE_KEY_BRIGHTNESS_DEC:
			AdjustBrightnessArray( 0, ambientBrightnessCurrent, ambientBrightnessLedDimmingFactors );
			break;
		case IR_REMOTE_KEY_OFF:
			gCurrentMatrixColor = WC_GetColor();
			WC_SetColor(WS2812_HSV_COL_OFF);
			break;
		case IR_REMOTE_KEY_ON:
			WC_SetColor(gCurrentMatrixColor);
			break;
//		case IR_REMOTE_KEY_FLASH:
//
//			break;
//		case IR_REMOTE_KEY_STROBE:
//
//			break;
//		case IR_REMOTE_KEY_FADE:
//
//			break;
#ifdef ENABLE_TESTMODE
		case IR_REMOTE_KEY_SMOOTH:
			UB_RTC = UB_RTC_GetClock( RTC_DEC );
			UB_RTC.min = ( UB_RTC.min + 3 ) % 60;
			UB_RTC.std = ( UB_RTC.std + 1 ) % 24;
			UB_RTC_SetClock( RTC_DEC );
			break;
#endif

		// Basic colors
		case IR_REMOTE_KEY_RED:
			WC_SetColor(WS2812_HSV_COL_RED);
			break;
		case IR_REMOTE_KEY_GREEN:
			WC_SetColor(WS2812_HSV_COL_GREEN);
			break;
		case IR_REMOTE_KEY_BLUE:
			WC_SetColor(WS2812_HSV_COL_BLUE);
			break;
		case IR_REMOTE_KEY_WHITE:
			WC_SetColor(WS2812_HSV_COL_WHITE);
			break;

		// Other colors
		case IR_REMOTE_KEY_ORANGE:
			WC_SetColor(WS2812_HSV_COL_ORANGE);
			break;
		case IR_REMOTE_KEY_LIGHTORANGE:
			WC_SetColor(WS2812_HSV_COL_LIGHTORANGE);
			break;
		case IR_REMOTE_KEY_DARKYELLOW:
			WC_SetColor(WS2812_HSV_COL_DARKYELLLOW);
			break;
		case IR_REMOTE_KEY_YELLOW:
			WC_SetColor(WS2812_HSV_COL_YELLOW);
			break;
		case IR_REMOTE_KEY_LIGHTGREEN:
			WC_SetColor(WS2812_HSV_COL_LIGHTGREEN);
			break;
		case IR_REMOTE_KEY_LIGHTGREENBLUE:
			WC_SetColor(WS2812_HSV_COL_LIGHTGREENBLUE);
			break;
		case IR_REMOTE_KEY_CYAN:
			WC_SetColor(WS2812_HSV_COL_CYAN);
			break;
		case IR_REMOTE_KEY_DARKGREENBLUE:
			WC_SetColor(WS2812_HSV_COL_DARKGREENBLUE);
			break;
		case IR_REMOTE_KEY_DARKBLUE:
			WC_SetColor(WS2812_HSV_COL_DARKBLUE);
			break;
		case IR_REMOTE_KEY_PURPLE:
			WC_SetColor(WS2812_HSV_COL_PURPLE);
			break;
		case IR_REMOTE_KEY_PINK:
			WC_SetColor(WS2812_HSV_COL_PINK);
			break;
		case IR_REMOTE_KEY_DARKPINK:
			WC_SetColor(WS2812_HSV_COL_DARKPINK);
			break;
	}

	// Save current color
	if ( irPacket.command != IR_REMOTE_KEY_OFF )
		gCurrentMatrixColor = WC_GetColor();
}
