Jinzuu/wc_ws/ub_lib/stm32_ub_led.c

//--------------------------------------------------------------
// File     : stm32_ub_led.c
// Datum    : 09.02.2013
// Version  : 1.1
// Autor    : UB
// EMail    : mc-4u(@)t-online.de
// Web      : www.mikrocontroller-4u.de
// CPU      : STM32F4
// IDE      : CooCox CoIDE 1.7.0
// Module   : GPIO
// Funktion : LED Funktionen
//--------------------------------------------------------------

//--------------------------------------------------------------
// Includes
//--------------------------------------------------------------
#include "stm32_ub_led.h"


//--------------------------------------------------------------
// Definition aller LEDs
// Reihenfolge wie bei LED_NAME_t
//
// Init : [LED_OFF,LED_ON]
//--------------------------------------------------------------
LED_t LED[] = {
  // Name    ,PORT , PIN       , CLOCK              , Init
  {LED_GREEN ,GPIOA,GPIO_Pin_5,RCC_AHB1Periph_GPIOA,LED_OFF},   // PA5=Gruene LED auf dem Discovery-Board
//  {LED_ORANGE,GPIOD,GPIO_Pin_13,RCC_AHB1Periph_GPIOD,LED_OFF},   // PD13=Orange LED auf dem Discovery-Board
//  {LED_RED   ,GPIOD,GPIO_Pin_14,RCC_AHB1Periph_GPIOD,LED_OFF},   // PD14=Rote LED auf dem Discovery-Board
//  {LED_BLUE  ,GPIOD,GPIO_Pin_15,RCC_AHB1Periph_GPIOD,LED_OFF},   // PD15=Blaue LED auf dem Discovery-Board
};



//--------------------------------------------------------------
// Init aller LEDs
//--------------------------------------------------------------
void UB_Led_Init(void)
{
  GPIO_InitTypeDef  GPIO_InitStructure;
  LED_NAME_t led_name;
  
  for(led_name=0;led_name<LED_ANZ;led_name++) {
    // Clock Enable
    RCC_AHB1PeriphClockCmd(LED[led_name].LED_CLK, ENABLE);

    // Config als Digital-Ausgang
    GPIO_InitStructure.GPIO_Pin = LED[led_name].LED_PIN;
    GPIO_InitStructure.GPIO_Mode = GPIO_Mode_OUT;
    GPIO_InitStructure.GPIO_OType = GPIO_OType_PP;
    GPIO_InitStructure.GPIO_PuPd = GPIO_PuPd_UP;
    GPIO_InitStructure.GPIO_Speed = GPIO_Speed_50MHz;
    GPIO_Init(LED[led_name].LED_PORT, &GPIO_InitStructure);

    // Default Wert einstellen
    if(LED[led_name].LED_INIT==LED_OFF) {
    	 UB_Led_Off(led_name);
    }
    else {
    	UB_Led_On(led_name);
    }
  }
}


//--------------------------------------------------------------
// LED ausschalten
//--------------------------------------------------------------
void UB_Led_Off(LED_NAME_t led_name)
{
  LED[led_name].LED_PORT->BSRRH = LED[led_name].LED_PIN;
}

//--------------------------------------------------------------
// LED einschalten
//--------------------------------------------------------------
void UB_Led_On(LED_NAME_t led_name)
{
  LED[led_name].LED_PORT->BSRRL = LED[led_name].LED_PIN;
} 

//--------------------------------------------------------------
// LED toggeln
//--------------------------------------------------------------
void UB_Led_Toggle(LED_NAME_t led_name)
{
  LED[led_name].LED_PORT->ODR ^= LED[led_name].LED_PIN;
}

//--------------------------------------------------------------
// LED ein- oder ausschalten
//--------------------------------------------------------------
void UB_Led_Switch(LED_NAME_t led_name, LED_STATUS_t wert)
{
  if(wert==LED_OFF) {
    UB_Led_Off(led_name);
  }
  else {
    UB_Led_On(led_name);
  }
}
