Jinzuu/wc_ws/sonstige_lib/stm32_ub_tim5.c

//--------------------------------------------------------------
// File     : stm32_ub_tim5.c
// Datum    : 20.08.2013
// Version  : 1.0
// Autor    : UB
// EMail    : mc-4u(@)t-online.de
// Web      : www.mikrocontroller-4u.de
// CPU      : STM32F4
// IDE      : CooCox CoIDE 1.7.0
// Module   : TIM, MISC
// Funktion : Timer-Funktionen per Timer5
//            (mit Callback-Funktion für externe ISR)
//--------------------------------------------------------------


//--------------------------------------------------------------
// Includes
//--------------------------------------------------------------
#include "stm32_ub_tim5.h"



//--------------------------------------------------------------
// interne Funktionen
//--------------------------------------------------------------
void P_TIM5_TIMER(uint16_t prescaler, uint16_t periode);
void P_TIM5_NVIC(void);
//--------------------------------------------------------------
uint32_t tim5_enable_flag=0;



//--------------------------------------------------------------
// Init und Stop vom Timer mit Vorteiler und Counterwert
// prescaler : [0...65535]
// periode   : [0...65535]
//
// F_TIM = 84 MHz / (prescaler+1) / (periode+1)
//--------------------------------------------------------------
void UB_TIMER5_Init(uint16_t prescaler, uint16_t periode)
{
  // Timer flag löschen
  tim5_enable_flag=0;
  // Timer einstellen
  P_TIM5_TIMER(prescaler, periode);
  P_TIM5_NVIC();
}

//--------------------------------------------------------------
// Init und Stop vom Timer mit einem FRQ-Wert (in Hz)
// frq_hz : [1...42000000]
//
// Hinweis : die tatsächliche Frq weicht wegen Rundungsfehlern
//           etwas vom Sollwert ab (Bitte nachrechnen falls Wichtig)
//--------------------------------------------------------------
void UB_TIMER5_Init_FRQ(uint32_t frq_hz)
{
  RCC_ClocksTypeDef RCC_Clocks;
  uint32_t clk_frq;
  uint16_t prescaler, periode;
  uint32_t u_temp;
  float teiler,f_temp;

  // Clock-Frequenzen (PCLK1) auslesen
  RCC_GetClocksFreq(&RCC_Clocks);
  clk_frq = RCC_Clocks.PCLK1_Frequency;

  // check der werte
  if(frq_hz==0) frq_hz=1;
  if(frq_hz>clk_frq) frq_hz=clk_frq;

  // berechne teiler
  teiler=(float)(clk_frq<<1)/(float)(frq_hz);

  // berechne prescaler
  u_temp=(uint32_t)(teiler);
  prescaler=(u_temp>>16);

  // berechne periode
  f_temp=(float)(teiler)/(float)(prescaler+1);
  periode=(uint16_t)(f_temp-1);

  // werte einstellen
  UB_TIMER5_Init(prescaler, periode);
}

//--------------------------------------------------------------
// Timer starten
//--------------------------------------------------------------
void UB_TIMER5_Start(void)
{
  // Timer enable
  TIM_Cmd(TIM5, ENABLE);
  // Timer flag setzen
  tim5_enable_flag=1;
}


//--------------------------------------------------------------
// Timer anhalten
//--------------------------------------------------------------
void UB_TIMER5_Stop(void)
{
  // Timer flag löschen
  tim5_enable_flag=0;
  // Timer disable
  TIM_Cmd(TIM5, DISABLE);
}


//--------------------------------------------------------------
// interne Funktion
// init vom Timer
//--------------------------------------------------------------
void P_TIM5_TIMER(uint16_t prescaler, uint16_t periode)
{
  TIM_TimeBaseInitTypeDef  TIM_TimeBaseStructure;

  // Clock enable
  RCC_APB1PeriphClockCmd(RCC_APB1Periph_TIM5, ENABLE);

  // Timer disable
  TIM_Cmd(TIM5, DISABLE);

  // Timer init
  TIM_TimeBaseStructure.TIM_Period =  periode;
  TIM_TimeBaseStructure.TIM_Prescaler = prescaler;
  TIM_TimeBaseStructure.TIM_ClockDivision = TIM_CKD_DIV1;
  TIM_TimeBaseStructure.TIM_CounterMode = TIM_CounterMode_Up;
  TIM_TimeBaseInit(TIM5, &TIM_TimeBaseStructure);

  // Timer preload enable
  TIM_ARRPreloadConfig(TIM5, ENABLE);
}


//--------------------------------------------------------------
// interne Funktion
// init vom Interrupt
//--------------------------------------------------------------
void P_TIM5_NVIC(void)
{
  NVIC_InitTypeDef NVIC_InitStructure;

  // Update Interrupt enable
  TIM_ITConfig(TIM5,TIM_IT_Update,ENABLE);

  // NVIC konfig
  NVIC_InitStructure.NVIC_IRQChannel = TIM5_IRQn;
  NVIC_InitStructure.NVIC_IRQChannelPreemptionPriority = 0;
  NVIC_InitStructure.NVIC_IRQChannelSubPriority = 0;
  NVIC_InitStructure.NVIC_IRQChannelCmd = ENABLE;
  NVIC_Init(&NVIC_InitStructure);
}



//--------------------------------------------------------------
// Timer-Interrupt
// wird beim erreichen vom Counterwert aufgerufen
// die Callback funktion muss extern benutzt werden
//--------------------------------------------------------------
void TIM5_IRQHandler(void)
{
  if (TIM_GetITStatus(TIM5, TIM_IT_Update) != RESET) {
    // wenn Interrupt aufgetreten
    TIM_ClearITPendingBit(TIM5, TIM_IT_Update);

    // Callback Funktion aufrufen
    // Diese Funktion muss extern vom User benutzt werden !!
    if(tim5_enable_flag!=0) {
      // nur wenn Timer aktiviert ist
      UB_TIMER5_ISR_CallBack();
    }
  }
}
