Jinzuu/wc_ws/wc_IrRemoteProcessing.h

#ifndef __WC_IRREMOTEPROCESSING_H
#define __WC_IRREMOTEPROCESSING_H

#include "main.h"
#include "IRMP/irmp.h"
#include "wc_frontend.h"

//####################################################################################################
//######################################### VARIABLES ################################################
//####################################################################################################


//####################################################################################################
//##################################### REMOTE KEY DEFINES ###########################################
//####################################################################################################
// Defines for DX Remote ED618
// http://www.dx.com/p/24-key-wireless-infrared-ir-remote-controller-for-rgb-led-light-bulb-1-cr2025-47019
#define IR_REMOTE_KEY_BRIGHTNESS_INC	5
#define IR_REMOTE_KEY_BRIGHTNESS_DEC	4
#define IR_REMOTE_KEY_OFF				6
#define IR_REMOTE_KEY_ON				7

#define IR_REMOTE_KEY_FLASH				15
#define IR_REMOTE_KEY_STROBE			23
#define IR_REMOTE_KEY_FADE				27
#define IR_REMOTE_KEY_SMOOTH			19

#define IR_REMOTE_KEY_RED				9
#define IR_REMOTE_KEY_GREEN				8
#define IR_REMOTE_KEY_BLUE				10
#define IR_REMOTE_KEY_WHITE				11

#define IR_REMOTE_KEY_ORANGE			13
#define IR_REMOTE_KEY_LIGHTORANGE		21
#define IR_REMOTE_KEY_DARKYELLOW		25
#define IR_REMOTE_KEY_YELLOW			17
#define IR_REMOTE_KEY_LIGHTGREEN		12
#define IR_REMOTE_KEY_LIGHTGREENBLUE	20
#define IR_REMOTE_KEY_CYAN				24
#define IR_REMOTE_KEY_DARKGREENBLUE		16
#define IR_REMOTE_KEY_DARKBLUE			14
#define IR_REMOTE_KEY_PURPLE			22
#define IR_REMOTE_KEY_PINK				26
#define IR_REMOTE_KEY_DARKPINK			18

//####################################################################################################
//####################################### OTHER DEFINES ##############################################
//####################################################################################################

//####################################################################################################
//########################################### GLOBALS ################################################
//####################################################################################################
WS2812_HSV_t gCurrentMatrixColor;

//####################################################################################################
//##################################### EXTERNAL FUNCTIONS ###########################################
//####################################################################################################

// Deals with e.g. this remote: http://www.dx.com/p/24-key-wireless-infrared-ir-remote-controller-for-rgb-led-light-bulb-1-cr2025-47019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

// Function that uses a received IR command to do stuff
void ProcessIrDataPacket( IRMP_DATA irPacket );



#endif //__WC_IRREMOTEPROCESSING_H
