Jinzuu/wc_ws/sonstige_lib/stm32_ub_tim5.h

//--------------------------------------------------------------
// File     : stm32_ub_tim5.h
//--------------------------------------------------------------

//--------------------------------------------------------------
#ifndef __STM32F4_UB_TIM5_H
#define __STM32F4_UB_TIM5_H


//--------------------------------------------------------------
// Includes
//--------------------------------------------------------------
#include "stm32f4xx.h"
#include "stm32f4xx_rcc.h"
#include "stm32f4xx_tim.h"
#include "misc.h"




//--------------------------------------------------------------
// Globale Funktionen
//--------------------------------------------------------------
void UB_TIMER5_Init(uint16_t prescaler, uint16_t periode);
void UB_TIMER5_Init_FRQ(uint32_t frq_hz);
void UB_TIMER5_Start(void);
void UB_TIMER5_Stop(void);
void UB_TIMER5_ISR_CallBack(void);  // Diese Funktion muss extern benutzt werden !!


//--------------------------------------------------------------
#endif // __STM32F4_UB_TIM5_H
