Jinzuu/wc_ws/sonstige_lib/stm32_ub_tim3.h

/*
//--------------------------------------------------------------
// File     : stm32_ub_tim3.h
//--------------------------------------------------------------

//--------------------------------------------------------------
#ifndef __STM32F4_UB_TIM3_H
#define __STM32F4_UB_TIM3_H


//--------------------------------------------------------------
// Includes
//--------------------------------------------------------------
#include "stm32f4xx.h"
#include "stm32f4xx_rcc.h"
#include "stm32f4xx_tim.h"
#include "misc.h"




//--------------------------------------------------------------
// Globale Funktionen
//--------------------------------------------------------------
void UB_TIMER3_Init(uint16_t prescaler, uint16_t periode);
void UB_TIMER3_Start(void);
void UB_TIMER3_Stop(void);
void UB_TIMER3_ISR_CallBack(void);  // Diese Funktion muss extern benutzt werden !!


//--------------------------------------------------------------
#endif // __STM32F4_UB_TIM3_H
*/
