Jinzuu/wc_ws/(commit log)

2014-02-22 Updated UB Timer Libs
2014-02-22 Fixed error due to update in timer library
    [main.c]
2014-10-11 - Added function to switch all elements off
2014-10-12 Code added to translate RTC time to active LEDs
2014-11-02 Configured for NUCLEO 411re board (Clock 96 MHz)
    Removed compilation errors
    [DCF77.c, main.c, stm32_ub_led.c, stm32_ub_led.h, wc_IrRemoteProcessing.h, wc_TimeToMatrix.h]
2014-11-11 Word matrix depending is set depending on RTC OneMinuteISR RTC is updated by DCF reception Top left LED now indicates DCF reception state (green ok, red bad signal)
2014-12-10 Reworked light dependent brightness code Integrated IR settability of brightness based on ambient brightness
    [CommonMath.c, CommonMath.h, main.c, wc_IrRemoteProcessing.c, wc_LightDependentBrightness.c, wc_LightDependentBrightness.h]
2014-12-10 Fixed small bug in WC Frontend
    [wc_frontend.c]
2014-12-11 After testing, minor changes/bugfixes
    [main.c, stm32_ub_ws2812.h, wc_LightDependentBrightness.c, wc_TimeToMatrix.c, wc_frontend.c, wc_frontend.h]
2014-12-22 - mechanische Zeichnungen
    [Horizontal_Einschub.ipt]
2014-12-29 Fixed bug in front end that caused disabled LEDs to be still active Fixed bug in conversion from time to LED matrix Added simple test mode (only addable by defines in main.h)
    [main.c, main.h, wc_IrRemoteProcessing.c, wc_IrRemoteProcessing.h, wc_TimeToMatrix.c, wc_frontend.c]
2014-12-29 Fixed bug due to overlapping word config defines
    [main.h, wc_TimeToMatrix.c, wc_frontend.c, wc_frontend.h]
2015-02-21 - changed output PIN for WS-LEDs to PB0
2015-03-21 - Pin-belegung in Dokumentation eingepflegt
2015-03-28 Documentation Bugfix in main.h
    [main.h]
2015-04-07 - bugfix (einS - Stunde curly brackets were missing) - thanks to Mana!
    [wc_TimeToMatrix.c]
2015-05-21 - updated docu with WLAN pins - included PCB
    [Schutz.brd, Schutz.sch, Zusatzplatine.sch]
2015-06-02 - Platine erweitert
    [Zusatzplatine.brd, Zusatzplatine.sch]
2015-06-03 - Platine weiter
    [Zusatzplatine.brd, Zusatzplatine.sch]
2015-06-03 - kleine Änderungen - Beschriftungen
    [Zusatzplatine.brd]
2015-06-04 - Platine Fehler behoben
    [Zusatzplatine.brd, Zusatzplatine.sch]
2015-10-25 - Platine überarbeitet
    [Zusatzplatine.brd, Zusatzplatine.sch]
2015-10-26 - Platine auf Arduino Connectors umgestellt
    [Zusatzplatine.brd, Zusatzplatine.sch]
2015-10-27 Corrected layout of top right pin row for arduino interfacing
    [Zusatzplatine.brd, Zusatzplatine.sch]
2015-10-28 Added Library for Stm32F411RE Nucleo Board
2015-10-29 Reworked Board Design
    [Zusatzplatine.brd, Zusatzplatine.sch]
2015-10-29 Platine: * WS-Schutz Layout verbessert * +5V & GND Leiterbahnen gelöscht (da wir Polygons haben) * DCF-In & DCF-PON auf Arduino Connector verlegt * kleine Trace-Umlegungen um Leitfähigkeit der Polygo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
    Dokumentation aktualisiert
    [Zusatzplatine.brd, Zusatzplatine.sch]
2015-10-30 Increased Drill for esp8266 module pins
    [Zusatzplatine.brd, Zusatzplatine.sch]
2015-10-30 Added Upside Down Mount Option for WiFI Improved Documentation on Board
    [Zusatzplatine.brd, Zusatzplatine.sch]
2015-10-30 - DCF-Leitungen umgelegt - Doku korrigiert
    [Zusatzplatine.brd, Zusatzplatine.sch]
2015-10-30 - Parallele Verbindung zu Morpho-Connectors
    [Zusatzplatine.brd, Zusatzplatine.sch]
2015-10-30 Silkscreen optimized
    [Zusatzplatine.brd]
2015-11-07 - small error fix concerning includes
    [wc_LightDependentBrightness.h, wc_frontend.c, wc_frontend.h]
2015-11-14 - UART am Laufen - Kommunikation mit ESP läuft aber noch nicht
2018-10-08 !!! not a building/working commit !!! - added missing files
    [esp8266.c, stm32_circularbuffer.c, stm32_circularbuffer.h]
2018-10-15 - created TrueStudio Project - now compiling - corrected PinConfiguration for Nucleo Board
    [DCF77.h, esp8266.c, main.c, stm32_ub_dig_in.c, stm32_ub_dig_in.h]
2018-10-15 - fixed ESP WLAN chip - now working with WiFi
    [esp8266.c, main.c, main.h, stm32_circularbuffer.c, stm32_ub_rtc.c, stm32_ub_uart.c]
2018-10-15 - Update der Dokumentation
2018-11-04 - Corrected winter time handling
    [stm32_ub_rtc.c]
2020-01-28 - Added ESP32 section to Documentation
