Jinzuu/wc_ws/(notices)

Notices in the files:
Platine/Zusatzplatine.brd:
(c) 2015 K. Neumann, J. Berg
